alexjegers/DAMPING_ADJUSTER/Controller/Testing and Other/ST7789  Address Set Bug/IMG_5339.JPG

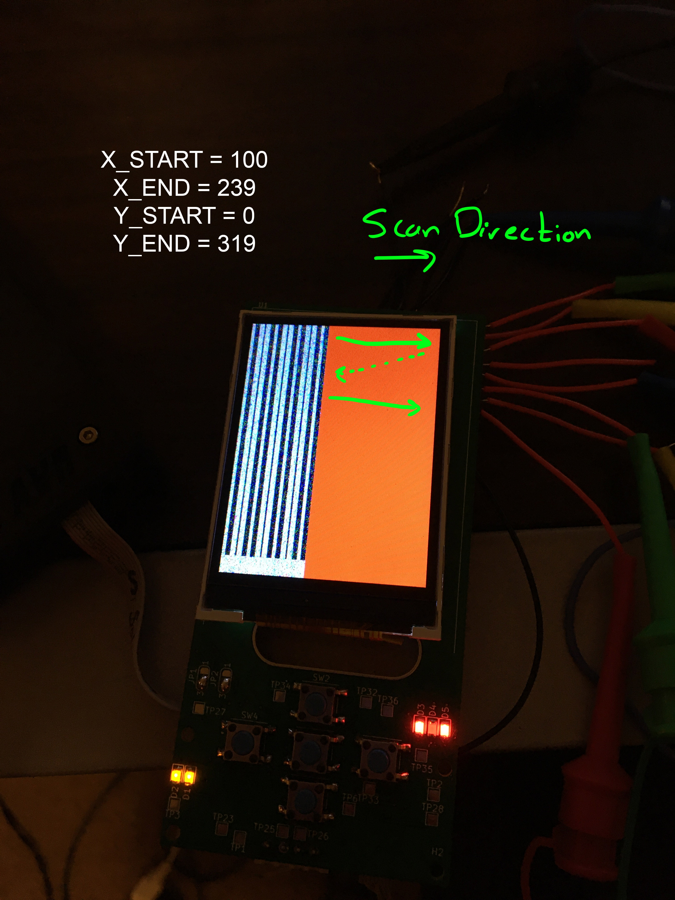
Controller/Testing and Other/ST7789 Address Set Bug/IMG_5339.JPG
