alexjegers/DAMPING_ADJUSTER/Stepper Motor Controller/CAD/3D Models/PerformanceLog.txt

Number of Contacts: 0
Number of contact data: 0
