alexjegers/DAMPING_ADJUSTER/Other Docs/Coilover Adjuster IIC Procedure.docx

Coilover Adjuster IIC Procedure

Version 1

1. Initiate communication by sending the device address and a write bit.
  a. Write 1 byte of data, this sets the internal address. After 1 byte of data the slave will NACK and transmission will stop.
    i. This slave now hold that internal address.
2. To read or write from this address, start another transmission beginning with the device address and the preferred direction (read or write) immediately followed by sending data (write) or preparing to receive (read) the next byte(s).
  a. Refer to the table below for size of each internal address and read/write capability.

Address | Name | Direction | Size (bytes) | Description
0x01 | MOTOR_SETPOINT | R/W | 2 | First byte: LSB of setpoint. Second byte: MSB of setpoint. Setpoint is the actual damping setting multiplied by 10. Should be a multiple of 10 between 0 – 300.
0x02 | MOTOR_POSITION | R/W | 2 | Only write on startup. First byte: LSB of position. Second byte: MSB of position. Position is the true position of the coilover times 10.
0x03 | MOTOR_SPEED | R/W | 2 | First byte: LSB of rotational speed in RPM. Second byte: MSB of rotational speed in RPM.
0x04 | MOTOR_CURRENT | R/W | 2 | First byte: LSB of member from CURRENT_LIMIT_t. Second byte: MSB of member from CURRENT_LIMIT_t.
0x05 | MOTOR_STEP_MODE | R/W | 1 | Member of STEP_MODE_t.
0x06 | MOTOR_STATUS_FLAGS | R | 1 | Returns 1 byte. STEPPER_INFO.flags
0x07 | BATTERY_VOLTAGE | R | 2 | Returns the ADC result
0x08 | GO_TO_ZERO | W | 1 | Any value written starts the go to zero process.

Version 2

Offset | Name | Direction | Size (bytes) | Description
0x00 | POSITION | | 2 | First byte: MSB of position. Second byte: LSB of set point.
0x02 | SET_POINT | | 2 | First byte: MSB of position. Second byte: LSB of set point.
0x04 | STEP_MODE | | 1 | Member of STEP_MODE_t.
0x05 | CURRENT_LIMIT | | 2 | First byte: MSB of member from CURRENT_LIMIT_t. Second byte: LSB of member from CURRENT_LIMIT_t.
0x07 | DECAY_MODE | | 1
0x08 | MOTOR_SPEED | | 2
0x10 | STATUS_FLAGS | | 1
