alexjegers/DAMPING_ADJUSTER/Other Docs/Coilover Damping Adjusters.pptx

## Coilover Damping Adjusters

Started: 8/10/2022

## High Level Block Diagram (old) – 8/10/2022

Main Control Board

Stepper Motor Board

IIC Slave

Stepper Motor and Driver

Encoder for Motor Position Feedback

Stepper Motor Board

IIC Slave

Stepper Motor and Driver

Encoder for Motor Position Feedback

OLED Display

IIC Master for communicating with motors

Encoder for user input

Stepper Motor Board

IIC Slave

Stepper Motor and Driver

Encoder for Motor Position Feedback

Stepper Motor Board

IIC Slave

Stepper Motor and Driver

Encoder for Motor Position Feedback

*Notes
IIC daisy chained to minimize the amount of wire.

## Motor Control Board Block Diagram – 8/13/22

IIC Master

ATtiny3217
or
AVR32DA32

DRV8825

NEMA-17 Short Stepper Motor

Bours open-center encoder

Coilover Damping Adjustment Screw

## PCB Board Cutout Coordinates – 8/19/22

Coordinates of each corner relative to origin (100, 100)

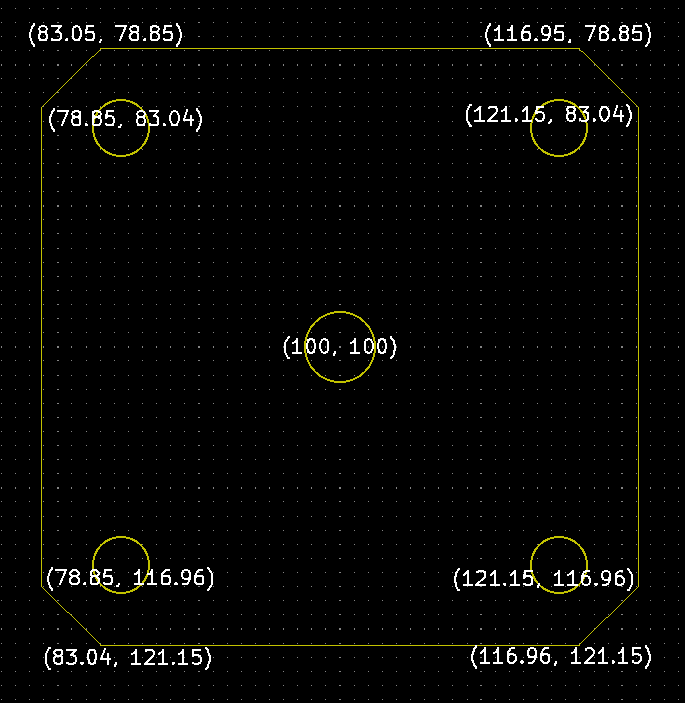
[picture p3: figure]

(100,100)

## Controller Board Block Diagram

Serial EEPROM

240x320
LCD
ST7789
or variant

8-bit parallel interface

ATUC128D3
or
SAM4LC2BA

Stepper Motor Boards

FL

FR

RL

RR

Switches

## High Level Block Diagram Updated – 9/22/22

Stepper Motor Board Front Right

IIC Slave

Stepper Motor and Driver

Encoder for Motor Position Feedback

Main Controller
Operated by driver

Stepper Motor Board Rear Right

IIC Slave

Stepper Motor and Driver

Encoder for Motor Position Feedback

LCD Display

IIC Master for communicating with motors

Switches for user input

Stepper Motor Board Front Left

IIC Slave

Stepper Motor and Driver

Encoder for Motor Position Feedback

12V

Stepper Motor Board Rear Left

IIC Slave

Stepper Motor and Driver

Encoder for Motor Position Feedback

Power Board
Located by fuse box.
4x Connectors for power and communication.

GND

## Top of Strut Dimensions and Actuator Depth – 10/9/22

Optimal length for hex key: 20.5mm from start of mounting (female) threads.

## Encoder Filtering – 8/14/22

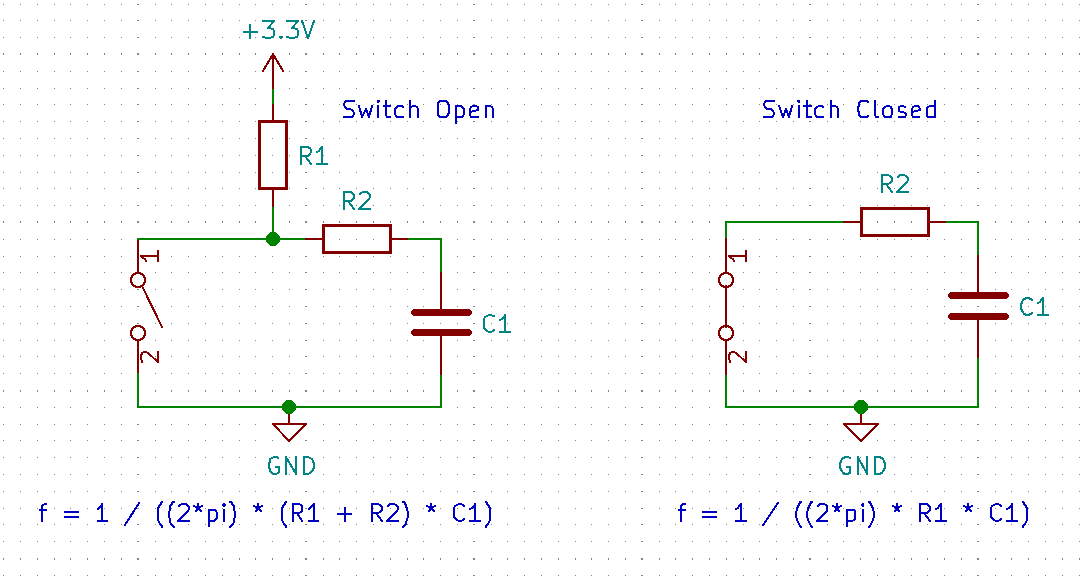
[picture p4: figure]

- Encoder max current rating: 10mA @ 5v
  - Pull-up resistor for 10mA @ 3.3V: >=330 ohm
- Max stepper RPM: ~100 rpm
  - Encoder pulses per rotation (PPR): 10
  - Pulses per second: 16.67
  - Min cutoff frequency: 16.67 Hz
- R1 = 330
- R2 = 7.5k
- C1 = 1u
  - Fc_open = 20.32 Hz
  - Fc_closed = 21.22 Hz
- If R2 = 5.1k
  - Fc_open = 29.31 Hz
  - Fc_closed = 31.21 Hz

## Encoder Filtering Cont – 8/15/22

- Schmitt trigger max upper threshold @ 3V: 2.0V
- Schmitt trigger min lower threshold @ 3V: 0.8V

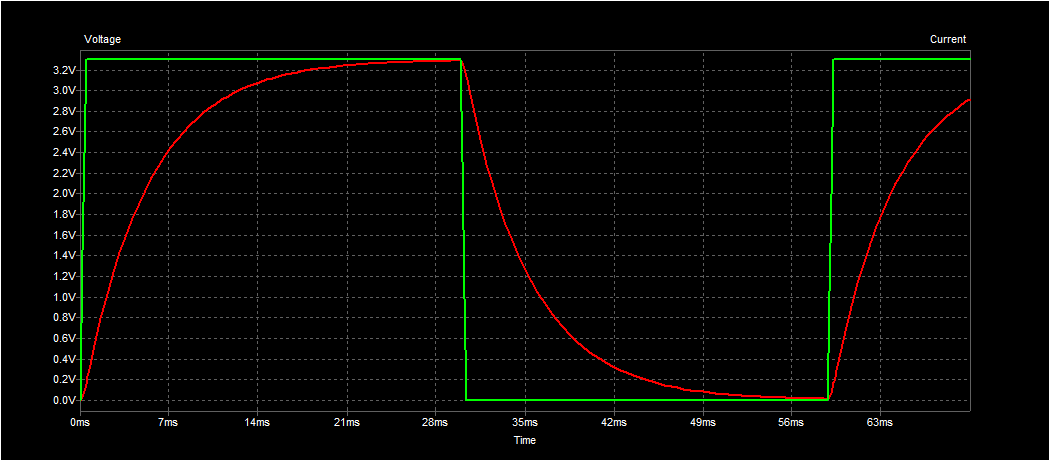
[picture p5: figure]

RC filter output with R2 = 5.1k

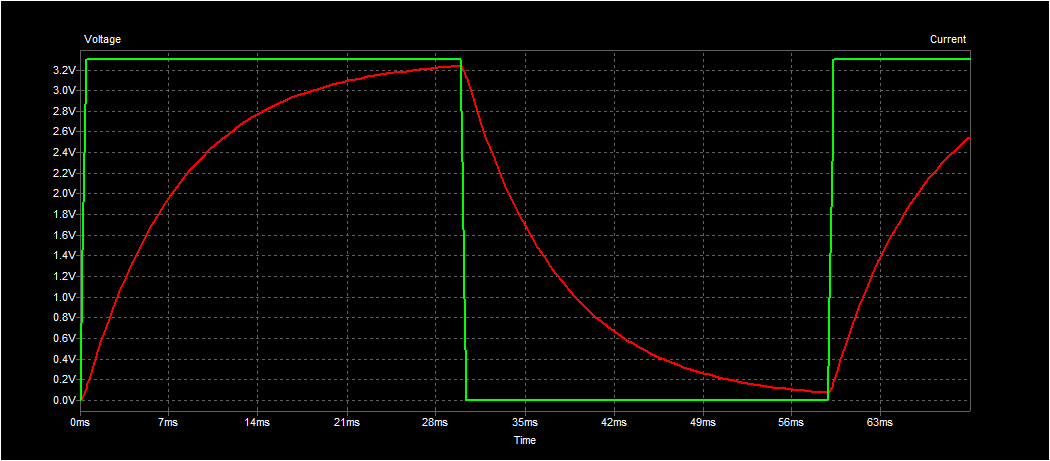
[picture p6: figure]

RC Filter output with R2 = 7.5k

## Stepper Current Sense Loop – 8/19/22

- ATtiny32xx DAC output range: 0.2 to VDD-0.2
- AVR32 DAC output range: GND to VDD
- DVR8825 Vref absolute range: 0V – 3.5V
  - Recommended range: 1V – 3.5V
- Rsense: 0.1 ohm
- Vref for 1A Ichop: 0.5V
- Rsense power dissipation: 0.1W
- Rsense: 0.25 ohm
- Vref for 1A Ichop: 1.26V
- Rsense power dissipation: 0.251W

## Stepper Motor Current Loop – 8/21/22

Goal is to keep current loop as short and constrained as possible.
Peak current of 1A per coil

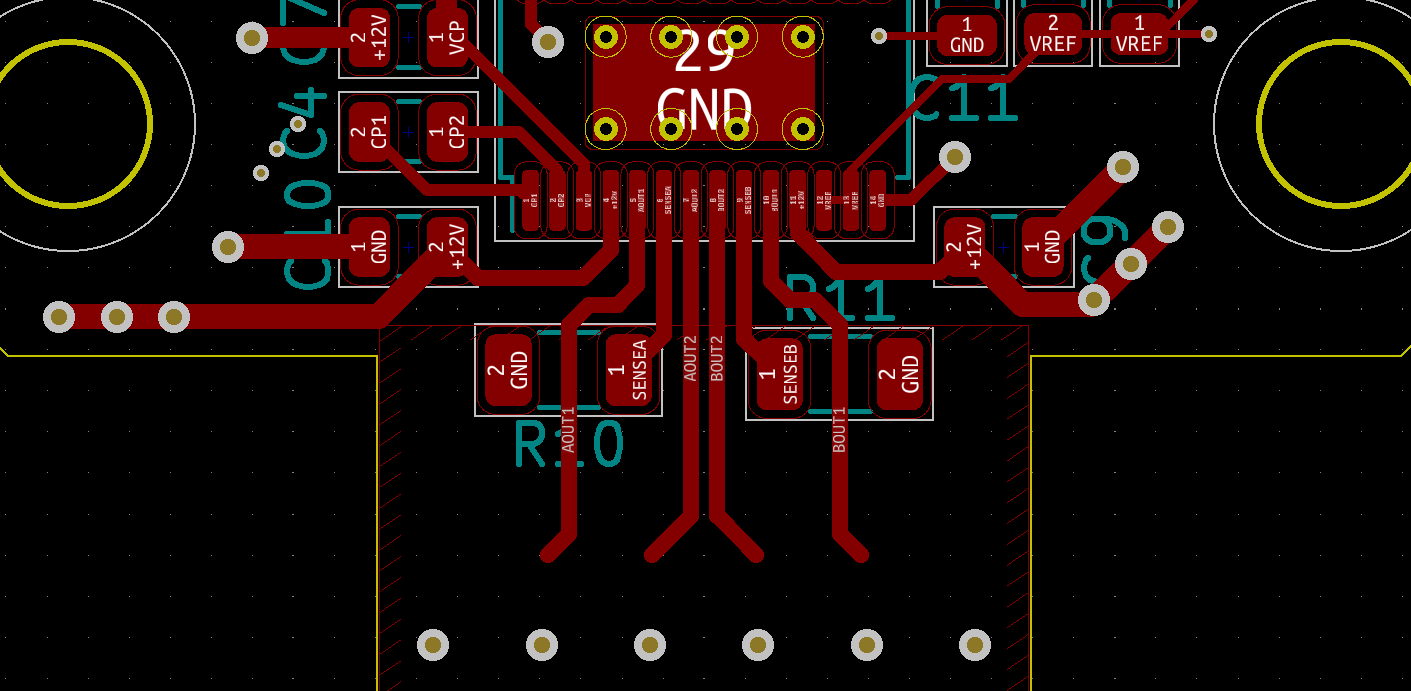
[picture p7: figure]

## On-Board Voltage Measurements – 8/21/22

- Vref = 2.5V
- Battery Voltage
- Max battery voltage: 15V
- Min battery voltage: 11V
- R1 = 1200, R2 = 200 -> divide by 7
  - Max power = 160.7mW
- Max divider output = 2.143V = 3511 (12 bit output)
- Min divider output = 1.571V = 2574 (12 bit output)
- Battery Voltage = ADC result / 1638.4

Vref = 2.5V
Regulated Voltage
Max, hopefully, 3.3V
Min, because of Vref, 2.5V
R1 = 680, R2 = 680 -> divide by 2
Max power = 165.4mW
Max divider output = 1.65V = 2703 bits
Min divider output = 1.25V = 2048 bits
Regulated Voltage = ADC result / 1638.4

## On-Board Voltage Measurements – 9/1/22

Calculating minimum impedance divider while not exceeding resistor power rating (0.25W)

## Slide 14

## Mounting – 8/26/22

- Coilover top hat thread size M12x1.25

## Controller MCU Selection – 8/29/22

Device/Description | # of pins
LCD data pins | 8
LCD backlight | 1
LCD Data/Cmd, CS, RD, WR | 4
LCD reset | 1
At least 1 IIC | 2
Buttons | >=5
Total | >=21 + prog pins

- Minimum memory:
  - Absolutely no less than 128kB, ideally more than or equal to 256kB.
- Peripherals:
  - At least 1 IIC.
  - CANBUS for future use.
  - EMI/SBC?

ATSAM4LC2BA

## ATSAM4LC2BA Clocking – 9/1/22

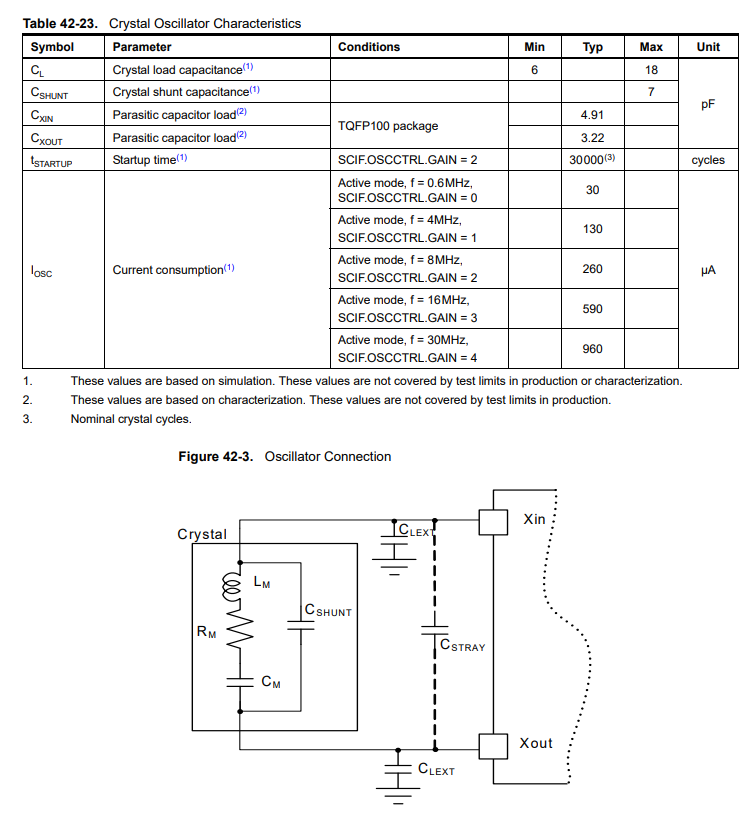
[picture p8: figure]

Crystal: AS-30.000-10-F-2020-EXT-SMD-TR
External capacitor value =
Cx = 2(CL – Cstray) = 2(10pF – 3pF) = 14pF

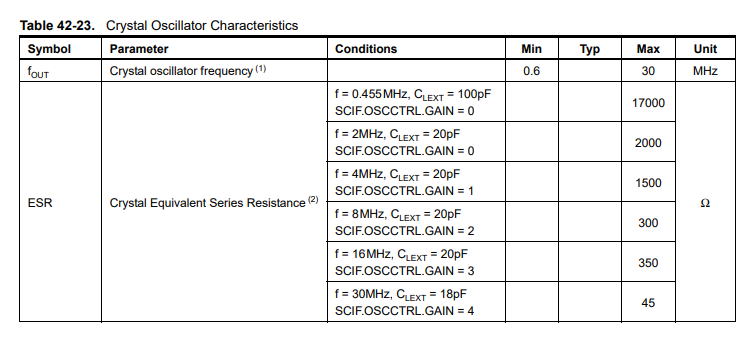
[picture p9: figure]

## Controller Board Buttons Filter – 9/2/22

- Max current through button: 10mA
  - Pull resistor (R21): 3.3V / 10mA = 330 ohm
- Cutoff frequency minimum: 15Hz
  - fc,min = 1 / ((2*pi)*(R21+R22)*C16)
- C16: 1uF
- R21: 330
- R22: 10k
- Switch pressed cutoff frequency = 15.92Hz
- Switch released cutoff frequency = 15.41Hz

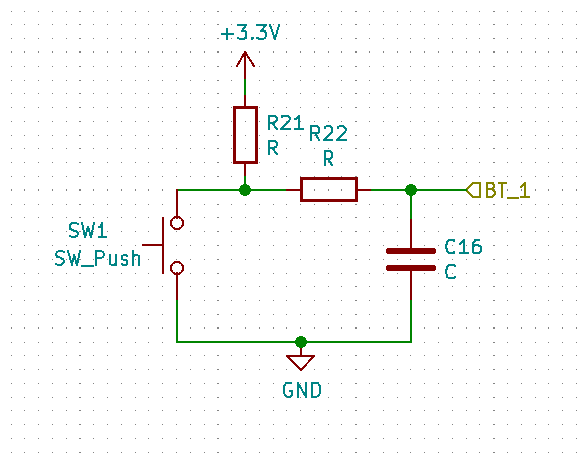
[picture p10: figure]

## ATUC128D3 Clocking – 9/3/22

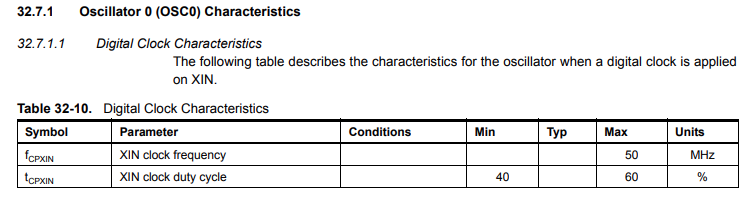
[picture p11: figure]

## DRV8825 Step PWM Frequency Calculation – 9/15/22

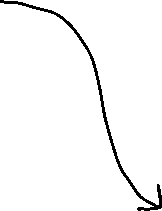
[picture p12: figure]

## Stepper Motor Timeout Frequency Calculations – 10/7/2022

## UPDI Pinout – 8/13/22

Atmel ICE Pinout

My Pinout

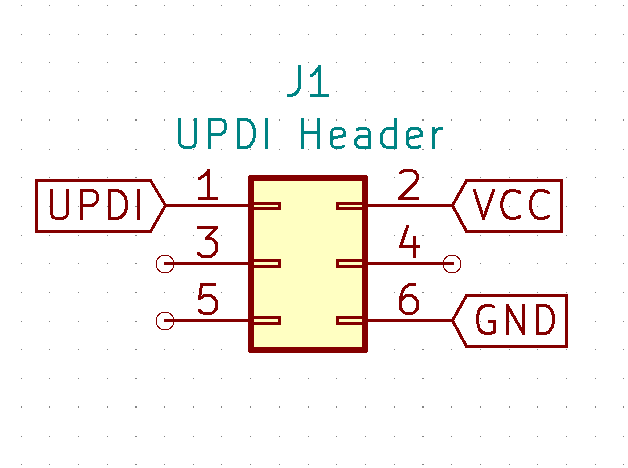
[picture p13: figure]
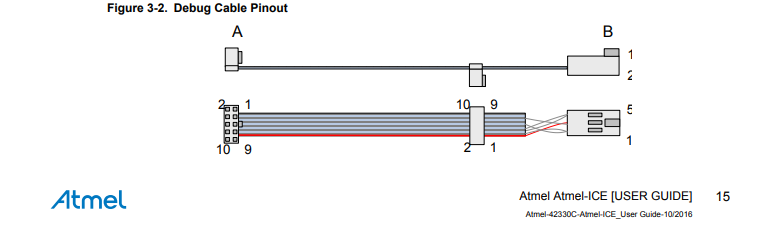
[picture p14: figure]
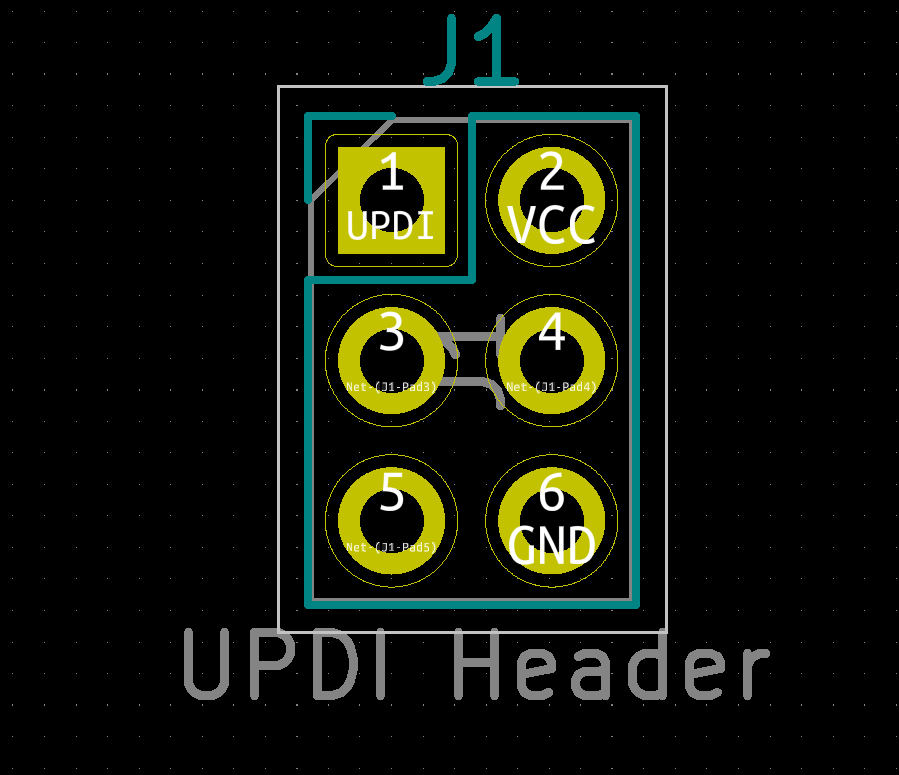
[picture p15: figure]
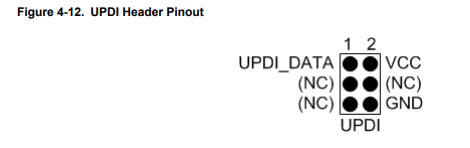
[picture p16: figure]

## UPDI Pinout - 8/20/22

Updated schematic for AVR32DA32

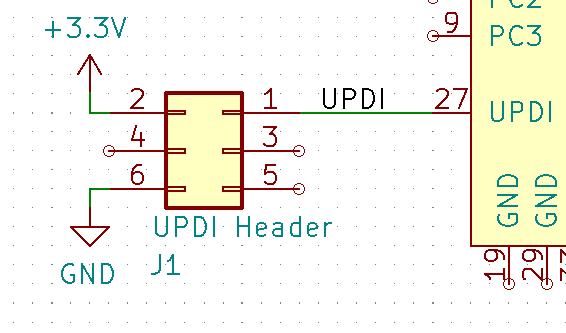
[picture p17: figure]

## UA78M33CKVURG3 Footprint – 8/15/22

Had to modify existing KiCAD TO-252 footprint. Extended pin 1 & 3 pads to 2.75mm from 2.2mm.

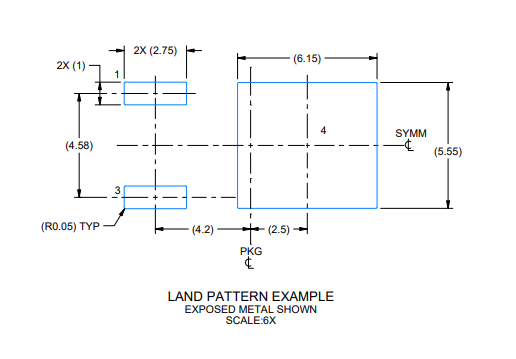
[picture p18: figure]
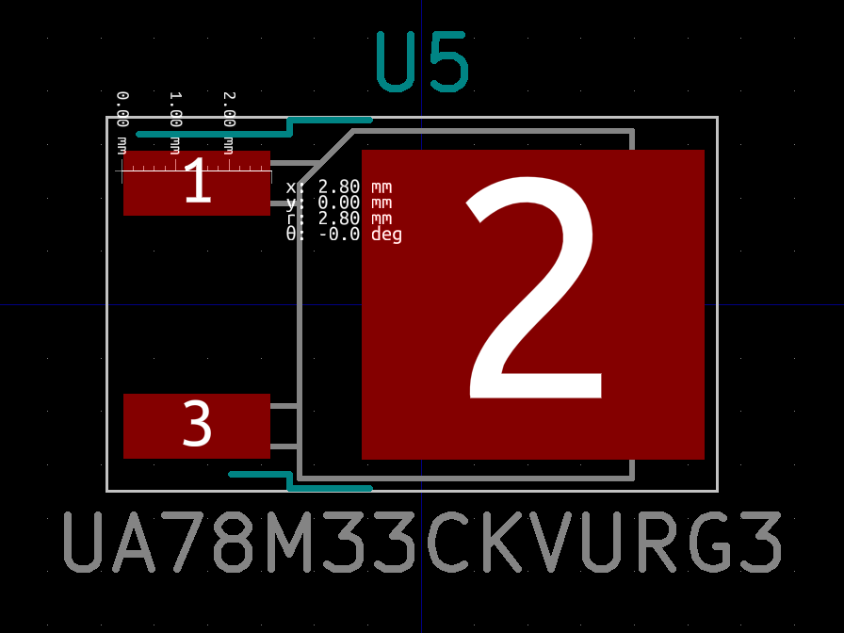
[picture p19: figure]

## ATSAM4LC2BA JTAG Pinout – 8/30/22

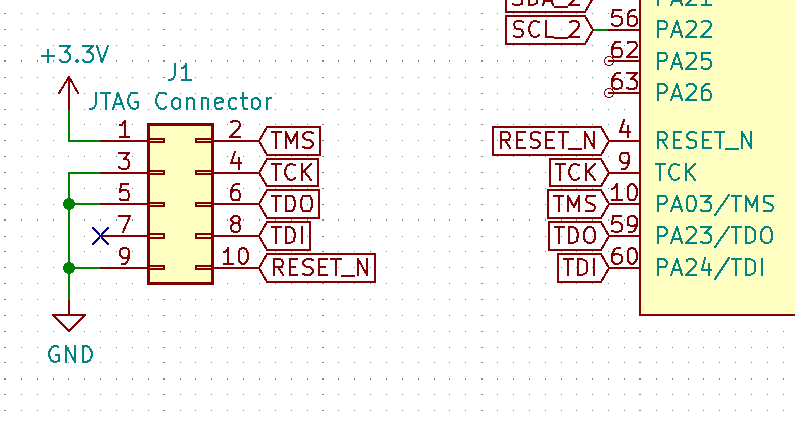
[picture p20: figure]
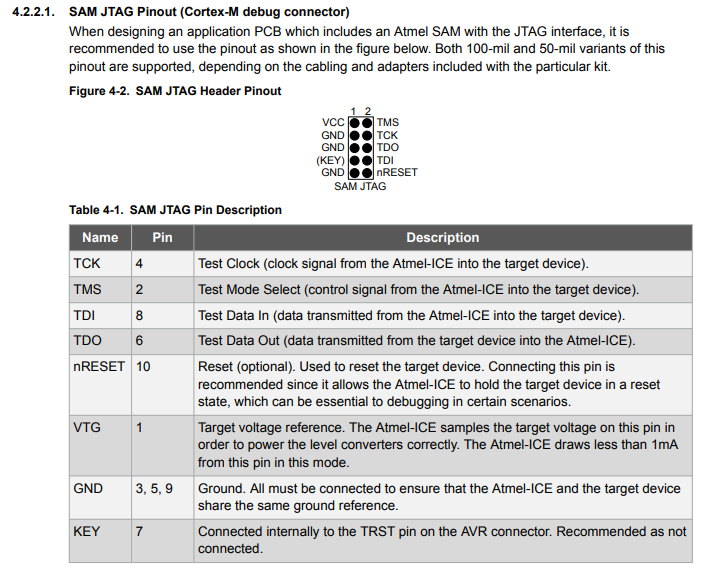
[picture p21: figure]
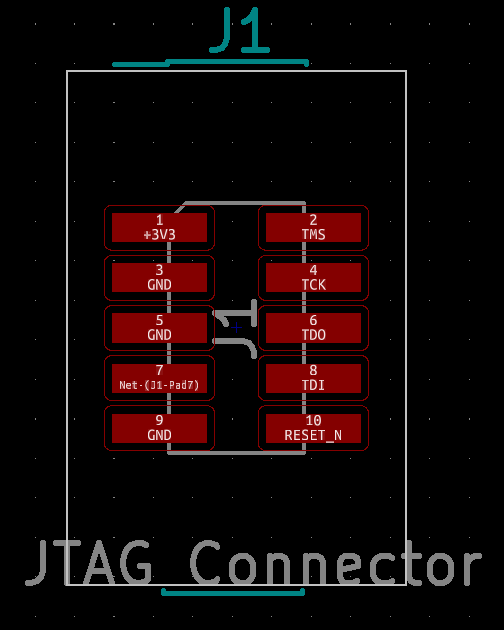
[picture p22: figure]

## ATSAM4LC2BA I2C Pins – 8/31/22

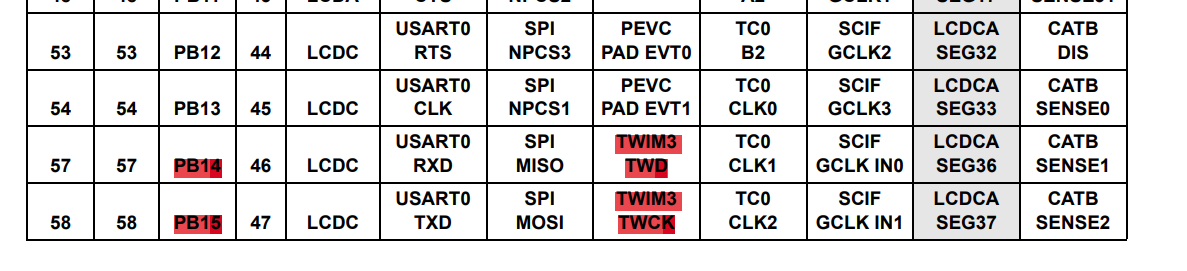
[picture p23: figure]
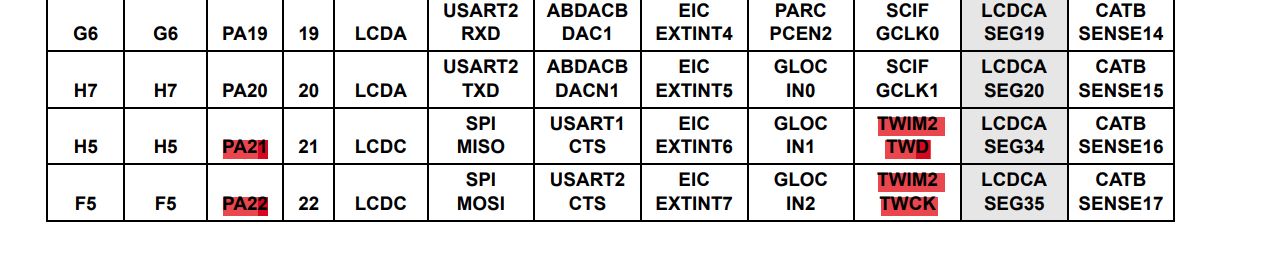
[picture p24: figure]
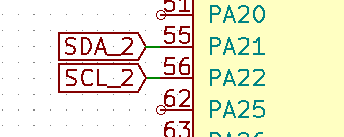
[picture p25: figure]

## BSR802N Backlight FET Pinout – 9/1/22

Datasheet

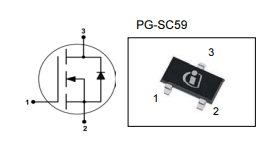
[picture p26: figure]
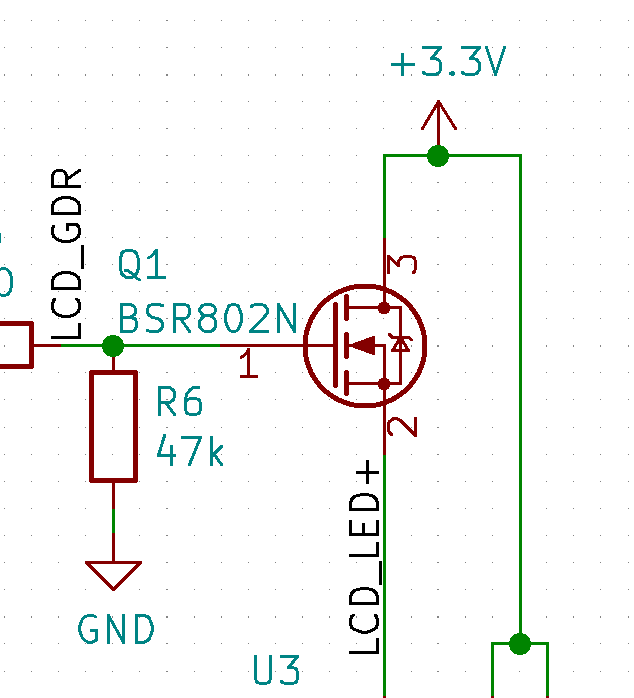
[picture p27: figure]
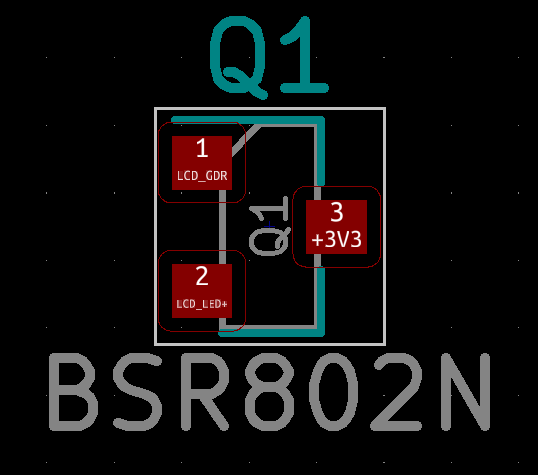
[picture p28: figure]

## ATUC128C3 JTAG Pinout – 9/3/22

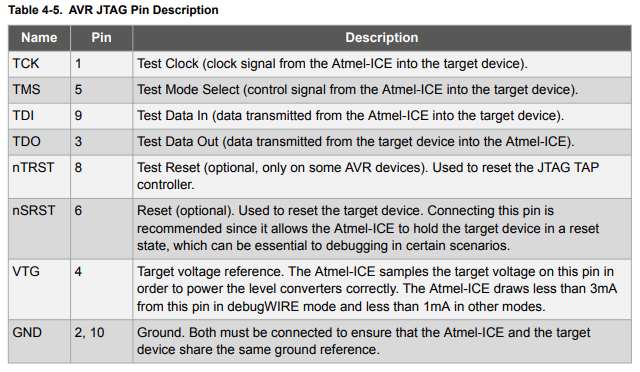
[picture p29: figure]
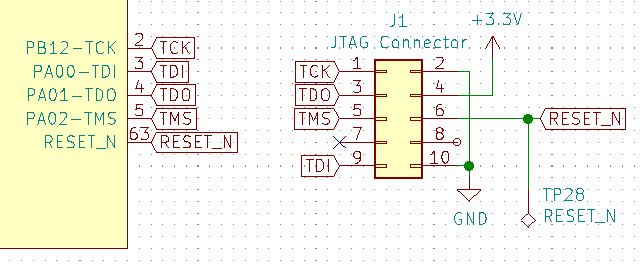
[picture p30: figure]
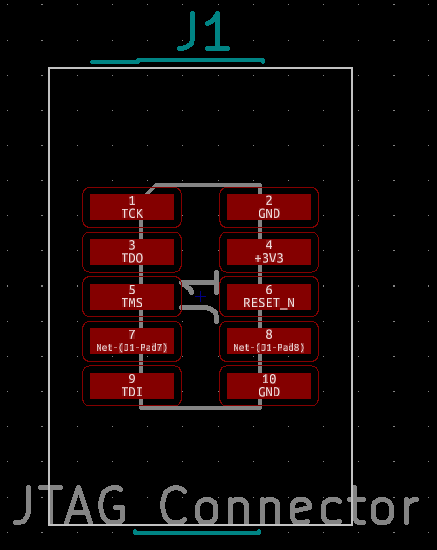
[picture p31: figure]
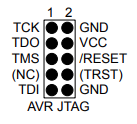
[picture p32: figure]

## SN74LVC2G17 Decoupling – 8/15/22

## UA78M33CKVURG3 Decoupling – 8/17/22

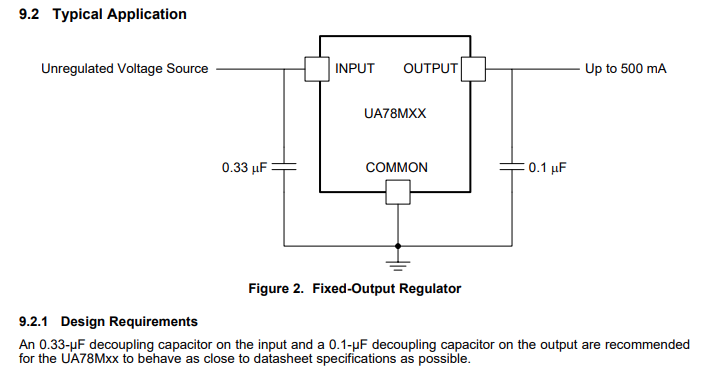
[picture p33: figure]

## AVR32DA32 Decoupling

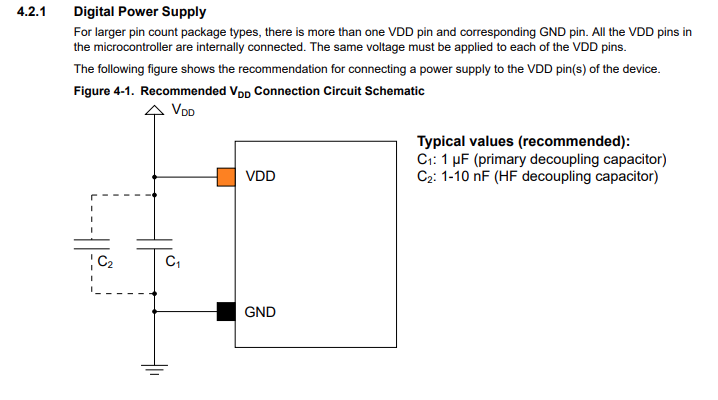
[picture p34: figure]
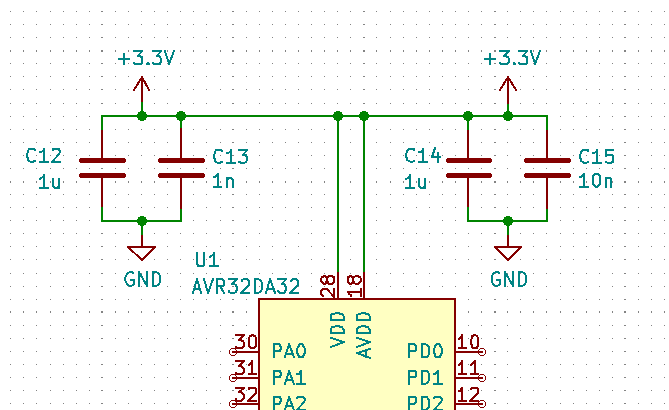
[picture p35: figure]

## ATSAM4LC2BA Power Supply – 8/30/22

- VDDANA, GNDANA
  - Analog Voltage Supply,
  - 3.3V
- VDDCORE
  - Core voltage supply
  - 1.8V, connect to VDDOUT
- VDDIN
  - Voltage regulator in
  - 3.3V
- VDDIO
  - IO Voltage,
  - 3.3V,
- VDDOUT
  - Voltage regulator output
  - 1.8V out
