alexjegers/DAMPING_ADJUSTER/Other Docs/Pinout Check Template.xlsx

Pin Number | My Symbol | Pin Number2 | Data Sheet | Check
1 |  | 1 |  | TRUE
2 |  | 2 |  | TRUE
3 |  | 3 |  | TRUE
4 |  | 4 |  | TRUE
5 |  | 5 |  | TRUE
6 |  | 6 |  | TRUE
7 |  | 7 |  | TRUE
8 |  | 8 |  | TRUE
9 |  | 9 |  | TRUE
10 |  | 10 |  | TRUE
11 |  | 11 |  | TRUE
12 |  | 12 |  | TRUE
13 |  | 13 |  | TRUE
14 |  | 14 |  | TRUE
15 |  | 15 |  | TRUE
16 |  | 16 |  | TRUE
17 |  | 17 |  | TRUE
18 |  | 18 |  | TRUE
19 |  | 19 |  | TRUE
20 |  | 20 |  | TRUE
21 |  | 21 |  | TRUE
22 |  | 22 |  | TRUE
23 |  | 23 |  | TRUE
24 |  | 24 |  | TRUE
25 |  | 25 |  | TRUE
26 |  | 26 |  | TRUE
27 |  | 27 |  | TRUE
28 |  | 28 |  | TRUE
29 |  | 29 |  | TRUE
30 |  | 30 |  | TRUE
31 |  | 31 |  | TRUE
32 |  | 32 |  | TRUE
33 |  | 33 |  | TRUE
