alexjegers/DAMPING_ADJUSTER/Controller/CAD/JPG/A1005-001-Front.JPG

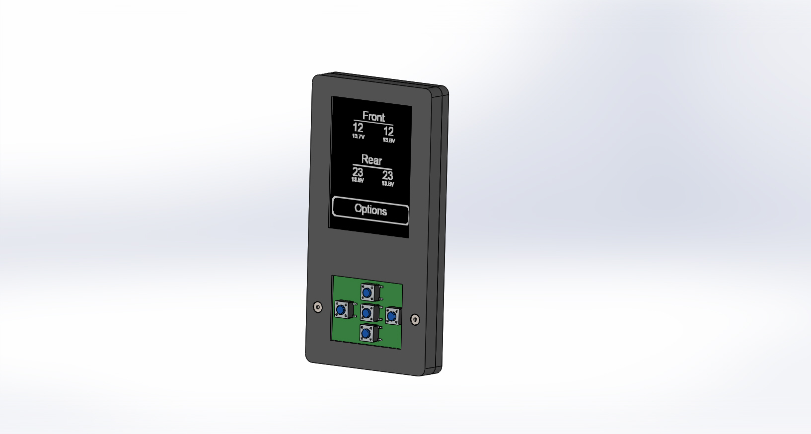
Controller/CAD/JPG/A1005-001-Front.JPG
