alexjegers/DAMPING_ADJUSTER/Controller/CAD/JPG/A1005-001-Rear.JPG

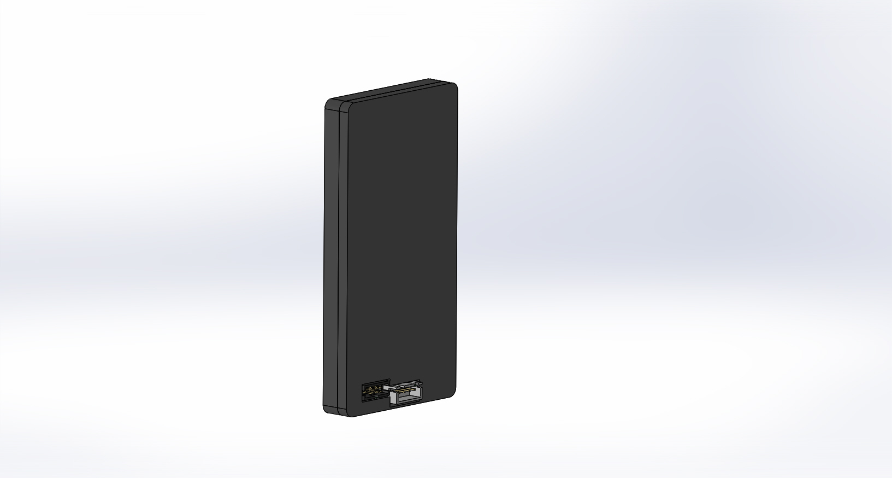
Controller/CAD/JPG/A1005-001-Rear.JPG
