alexjegers/DAMPING_ADJUSTER/Other Docs/Diagram Overview.jpg

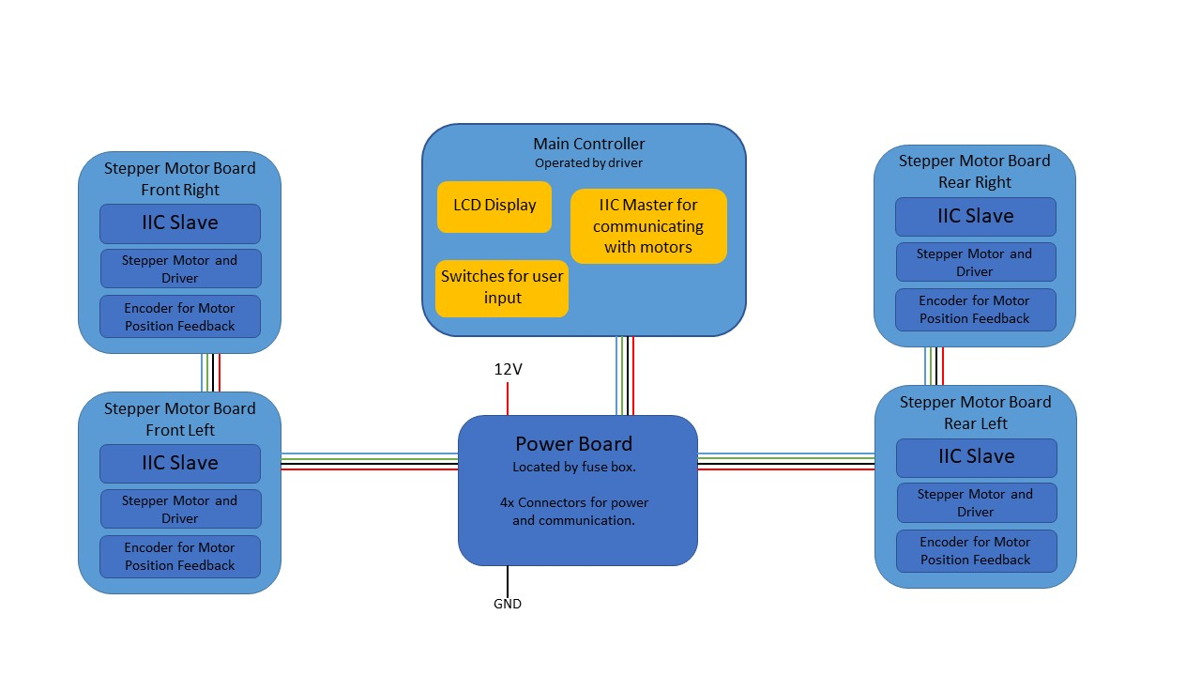
Other Docs/Diagram Overview.jpg
