alexjegers/DAMPING_ADJUSTER/Stepper Motor Controller/Testing and Other/ADC Input Impedance/Schematic.PNG

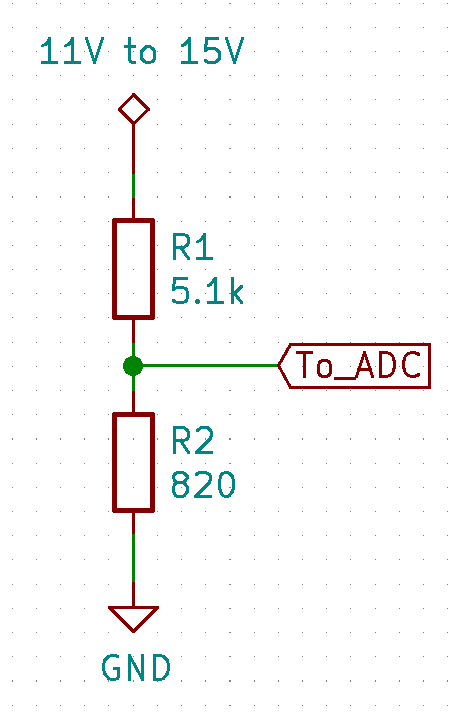
Stepper Motor Controller/Testing and Other/ADC Input Impedance/Schematic.PNG
