alexjegers/DAMPING_ADJUSTER/Stepper Motor Controller/Testing and Other/ADC Measurements/Schematic.PNG

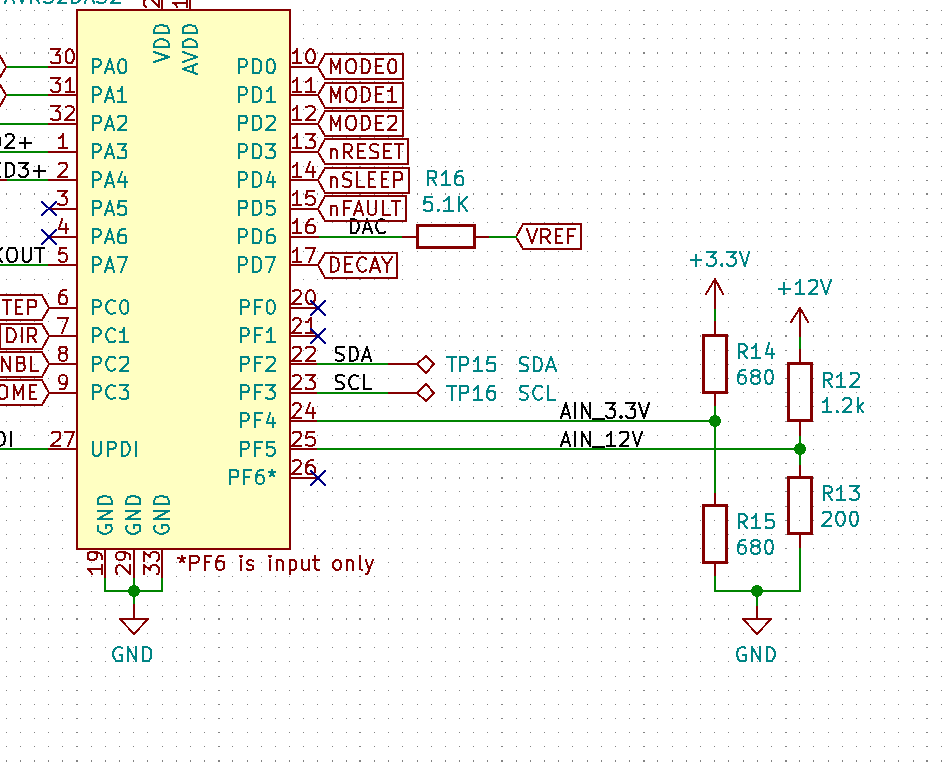
Stepper Motor Controller/Testing and Other/ADC Measurements/Schematic.PNG
