alexjegers/DAMPING_ADJUSTER/Other Docs/Full Parts List.xlsx

Sheet: Parts
Part Num | Mfg Part Num | Type | Distributor | Description | Unit Cost
1001 | PER231-P19-N0010 | Other | Arrow | Open center encoder | 2.24
1002 | 17HS08-1004S | Other | StepperOnline | Nema 17 Stepper Motor | 8.56
1003 | SN74LVC2G17DBVR | IC | JLC Parts | Schmitt Trigger, Dual | 0.15
1004 | UA78M33CKVURG3 | IC | Digi-Key | 3.3V Regulator | 0.81
1005 | JST-XH | Connector | Amazon | 2.54mm pitch connector
1005-001 | JST-XH | Connector |  | 2 pin
1005-002 | JST-XH | Connector |  | 3 pin
1005-003 | JST-XH | Connector |  | 4 pin
1006 | MAL202136101E3 | Passive | Digi-Key | 100uF axial capacitor | 1.98
1007 | DRV8825 | IC | JLC Parts | Stepper motor driver | 3.87
1008-001 | KDV12DR100ET | Passive | Digi-Key | Current Sense Resistors .1 ohm | 0.36 | *Note: Alternative for .25 ohm, order both.
1008-002 | CSR1206FKR250 | Passive | Digi-Key | Current Sense Resistors .25 ohm | 0.41
1009 | AVR32DA32T-E/RXB | IC | Digi-Key | 8 bit AVR MCU 32kb flash | 2.14
1010 |  | 3D Printed |  | Stepper motor to hex adapter
1011 |  | 3D Printed |  | PCB Stepper motor spacer
1012 | 18072 | Hardware | Bolts Depot | Mounting Nut | 0.24
1013 |  | 3D Printed |  | Mounting nut holder front
1014 | 22474 | Hardware | Bolts Depot | Extended Mount to Stepper Screws 25mm | 0.21
1015 | AT24C04D | IC | Digi-Key | IIC EEPROM | 0.26
1016 | BSR802NL6327HTSA1 | IC | Digi-Key | LCD Backlight FET switch | 0.72
1017 | ATSAM4LC2BA-MUR | IC | Digi-Key | 32 bit MCU 128kB flash | 2.47
1018 |  | 3D Printed |  | Mounting Nut Holder rear
1019 |  | Hardware |  | 3mm Hex Key
1020 | AS-30.000-10-F-2020-EXT-SMD-TR | Passive | Digi-Key | 30MHz crystal | 0.21
1021-001 |  | Passive |  | 14pF crystal load cap
1021-002 |  | Passive |  | 12pF crystal load cap
1021-003 |  | Passive |  | 16pF crystal load cap
1021-004 |  | Passive |  | 10pF crystal load cap
1022 | ECS-2520MV-480-CN-TR | Passive | Digi-Key | 48 MHz Oscillator | 1.29
1023 | ATUC128D3-A2UT | IC | Digi-Key | 32 bit MCU 128kB flash | 2.65
1024 | 104990542 | IC | Digi-Key | 2.4" LCD Screen | 6.9
1025 | CF20241D0R0-NH | Connector | Digi-Key | FFC Connector for LCD | 0.47
1026 |  | Hardware |  | M2 threaded insert
1027 | PTS645SM43SMTR92 LFS | Other | Digi-Key | Switch for controller board | 0.28
1028 |  | 3D Printed |  | Controller case bottom half
1029 |  | 3D Printed |  | Controller case top half
1030 | 3221-10-0300-00 | Connector | Digi-Key | JTAG Socket | 0.76
1031 |  | 3D Printed |  | Power and Signal Board Case Bottom
1032 |  | 3D Printed |  | Power and signal board case top
]

Sheet: Assemblies
Part Number | Description
A1001 | Full stepper motor assembly
A1002 | Stepper motor board PCA
A1003 | LCD and FPC Connector
A1004 | Controller Board PCA
A1005 | Full Controller Assembly
A1006 | Power/signal distribution PCA
A1007 | Full power/signal distribution assembly
A1013 | Stepper motor mount front, 1013 & 1012
A1018 | Stepper motor mount rear, 1018 & 1012
