alexjegers/DAMPING_ADJUSTER/Other Docs/BOM & Dev Costs.xlsx

Sheet: A1001 - Full Stepper Assembly
Part Num | Mfg Part Num | Distributor | Description | Quantity | Unit Cost | Total Cost | Cost for 1
1010 | 3D Printed |  | Stepper motor to hex adapter | 1 |  | 0 | 20.4
1011 | 3D Printed |  | PCB Stepper motor spacer | 1 |  | 0
A1002 | A1002 |  | Stepper motor PCA | 1 | 19.32 | 19.32
A1013 | A1013 |  | Stepper Motor Mount | 1 | 1.08 | 1.08

Sheet: A1002 - Stepper Motor PCA
Part Num/Designator | Mfg Part Num | Distributor | Type | Value | Footprint | Quantity | Unit Cost | Total Cost | Total
C1, C2, C12, C14 | 1276-1066-1-ND | DigiKey | Capacitor | 1u | 0805 | 4 | 0.1 | 0.4 | 19.32
C3, C6, C7, C9, C10 | 1276-1099-1-ND | DigiKey | Capacitor | .1u | 0805 | 5 | 0.1 | 0.5
C4, C15 | 1276-1015-1-ND | DigiKey | Capacitor | .01u | 0805 | 1 | 0.1 | 0.1
C5 | 1276-1123-1-ND | DigiKey | Capacitor | .33u | 0805 | 1 | 0.1 | 0.1
C8 | 4032PHCT-ND | DigiKey | Capacitor | 100u | 0805 | 1 | 1.98 | 1.98
C11 | 1276-1039-1-ND | DigiKey | Capacitor | .47u | 0805 | 1 | 0.1 | 0.1
C13 | 1276-1020-1-ND | DigiKey | Capacitor | 1n | 0805 | 1 | 0.1 | 0.1
D1-D5 | 732-4988-1-ND | DigiKey | LED | LED | 1206 | 5 | 0.23 | 1.15
J1 | 2057-PH2RA-06-UA-ND | DigiKey | Connector | 2x3 2.54mm 90 degree THT header |  | 1 | 0.19 | 0.19
J2 |  |  | Connector | JST-XH 4 pin THT |  | 1 |  | 0
J3, J4 |  |  | Connector | JST-XH 4 pin THT |  | 2 |  | 0
R1, R2 | A106061CT-ND | DigiKey | Resistor | 330 | 0805 | 2 | 0.1 | 0.2
R3, R4, R16 | 13-RT0805FRE075K1LCT-ND | DigiKey | Resistor | 5.1k | 0805 | 3 | 0.1 | 0.3
R5 | A106058CT-ND | DigiKey | Resistor | 1M | 0805 | 1 | 0.1 | 0.1
R6, R7 | RMCF0805FT10K0CT-ND | DigiKey | Resistor | 10k | 0805 | 2 | 0.1 | 0.2
R10, R11/1008-001 | 273-KDV12DR100ETCT-ND | DigiKey | Resistor | 0.1 | 1206 | 2 | 0.36 | 0.72
R12, R20 | A129750CT-ND | DigiKey | Resistor | 1.2k | 0805 | 2 | 0.1 | 0.2
R13 | RHM200KCT-ND | DigiKey | Resistor | 200 | 0805 | 1 | 0.14 | 0.14
R14, R15 | A129747CT-ND | DigiKey | Resistor | 680 | 0805 | 2 | 0.1 | 0.2
R17-R19, R21 | A129745CT-ND | DigiKey | Resistor | 470 | 0805 | 4 | 0.1 | 0.4
U1/1009 | 150-AVR32DA32T-E/RXBCT-ND | DigiKey | IC | AVR32DA32 | QFN-32 | 1 | 2.14 | 2.14
U2/1007 | C81582 | LCSC/JLC | IC | DRV8825 | HTSSOP-28 | 1 | 4.02 | 4.02
U3/1001 | 118-PER231-P19-N0010-ND | DigiKey | IC | PER231-P19-N0010 |  | 1 | 3.42 | 3.42
U4/1003 | 296-SN74LVC2G17DBVRCT-ND | DigiKey | IC | SN74LVC2G17DBVR | SOT23-6 | 1 | 0.44 | 0.44
U5/1004 | 296-21208-1-ND | DigiKey | IC | UA78M33CKVURG3 | TO-252-2 | 1 | 0.62 | 0.62
A1002 |  | JLC PCB | PCB | PCB |  | 1 | 1.6 | 1.6

Sheet: A1003 - Controller Board PCA
Part Num/Designator | Mfg Part Num | Distributor | Type | Value | Footprint | Quantity | Unit Cost | Total Cost | Total
C1, C3-C5, C7, C9, C10, C12, C13, C15 | 1276-1099-1-ND | DigiKey | Capacitor | .1u | 0805 | 10 | 0.1 | 1 | 19.19
C2, C6, C16-C20 | 1276-1066-1-ND | DigiKey | Capacitor | 1u | 0805 | 7 | 0.1 | 0.7
C8 | 1276-1123-1-ND | DigiKey | Capacitor | .33u | 0805 | 1 | 0.1 | 0.1
C11 | 1276-6454-1-ND | DigiKey | Capacitor | 10u | 0805 | 1 | 0.18 | 0.18
C14 | 399-17612-1-ND | DigiKey | Capacitor | 10p | 0805 | 1 | 0.26 | 0.26
D1-D5 | 732-4988-1-ND | DigiKey | LED | Any | 1206 | 5 | 0.23 | 1.15
J1 | 1175-1735-ND | DigiKey | Connector |  | 2x6 SMD | 1 | 0.76 | 0.76
J2 |  | DigiKey | Connector |  | 1x4 THT | 1 |  | 0
Q1/1016 | BSR802NL6327HTSA1CT-ND | DigiKey | IC | BSR802N | SOT-23 | 1 | 0.72 | 0.72
R1 | A130137CT-ND | DigiKey | Resistor | 3.3k | 0805 | 1 | 0.1 | 0.1
R2, R14 | A129750CT-ND | DigiKey | Resistor | 1.2k | 0805 | 2 | 0.1 | 0.2
R3, R4 | RNCP0805FTD1K00CT-ND | DigiKey | Resistor | 1k | 0805 | 2 | 0.1 | 0.2
R5, R15 | RHM200KCT-ND | DigiKey | Resistor | 200 | 0805 | 2 | 0.14 | 0.28
R6 | A106064CT-ND | DigiKey | Resistor | 47k | 0805 | 1 | 0.1 | 0.1
R13, R22, R24, R26, R28, R30 | RMCF0805FT10K0CT-ND | DigiKey | Resistor | 10k | 0805 | 6 | 0.1 | 0.6
R18-R20 | A129745CT-ND | DigiKey | Resistor | 470 | 0805 | 2 | 0.1 | 0.2
R21, R23, R25, R27, R29 | A106061CT-ND | DigiKey | Resistor | 330 | 0805 | 5 | 0.1 | 0.5
U1/1024 | 1597-104990542-ND | DigiKey | IC | RY24049B0-00 |  | 1 | 6.9 | 6.9
U2/1004 | 296-21208-1-ND | DigiKey | IC | UA78M33CKVURG3 | TO-252-2 | 1 | 0.62 | 0.62
U3/1023 | ATUC128D3-A2UT-ND | DigiKey | IC | ATUC128D3 | TQFP-64 | 1 | 2.65 | 2.65
U4/1015 | 1611-AT24C04D-XHM-B-ND | DigiKey | IC | AT24C04D | TSSOP-8 | 1 | 0.26 | 0.26
X1 | XC2757CT-ND | DigiKey | IC | ECS-2520MV-480 |  | 1 | 1.24 | 1.24
J3 | 2987-CF20241D0R0-NHCT-ND | DigiKey | Connector | CF20241D0R0-NH |  | 1 | 0.47 | 0.47
SW1-SW5 | CKN9112CT-ND | DigiKey | Switch | PTS645SM43SMTR92 LFS |  | 5 | 0.28 | 1.4

Sheet: A1013 - Stepper Motor Mount
Part Num | Mfg Part Num | Distributor | Description | Quantity | Unit Cost | Total Cost | Cost for 1
1012 | 18072 | Bolts Depot | Mounting Nut | 1 | 0.24 | 0.24 | 1.08
1013 | 3D Printed |  | Mounting nut holder front | 1 |  | 0
1014 | 22474 | Bolts Depot | Extended Mount to Stepper Screws 25mm | 4 | 0.21 | 0.84

Sheet: A1018 - Stepper Motor Mount Ext
Part Num | Mfg Part Num | Distributor | Description | Quantity | Unit Cost | Total Cost | Cost for 1

Sheet: Purchase History
Date | Part Num | Retailer | Order Number | Item | Quantity | Sub-Total | Tax | Shipping | Total
2022-08-13 | 1001 | Arrow.com |  | Open Center Encoder | 4 | 8.98 | 1.33 | 5.99 | 16.3 | Total Spent | 246.86
8/25/2022 | A1002 | Digikey.com | 77498754 | Electrical Parts | 5 | 30.81 | 3.51 | 4.99 | 39.31
2022-08-25 | A1002 | JLCPCB | Y9-3281895A | PCB, PCA, and parts | 5 | 35.38 | 0 | 19.44 | 54.82
2022-08-28 | A1002 | Bolts Depot | 1825377 | 1012, 1014, some socket cap | 4 | 10.88 | 0.89 | 4.95 | 16.72
2022-08-29 | A1003 | Digikey.com | 77627274 | Electrical Parts | 2 | 21.28 | 2.51 | 4.99 | 28.78
2022-09-12 | A1002 | Digikey.com | 77751071 | Electrical Parts | 5 | 10.7 | 1.39 | 4.99 | 17.08
2022-09-18 | A1003/A1002 | Digikey.com | 77843061 | Switches, header pins | 2 | 6.86 | 1.7 | 4.99 | 13.55
2022-09-25 | A1003 | JLCPCB | Y13-3281895A, Y11-3281895A | PCB | 5 | 9 | 0 | 20.01 | 29.01
2022-10-02 | A1003 | Digikey.com | 78062957 | Passives | 2 | 14.27 | 1.86 | 4.99 | 21.12
2022-10-02 | 1005 | PCHCables.com | PCH-106524 | Connectors M&F | 15 | 4.05 | 0 | 6.12 | 10.17
