alexjegers/DAMPING_ADJUSTER/Stepper Motor Controller/Electrical/Mfg Files/JLC PCA BOM.xlsx

Comment | Designator | Footprint | JLCPCB Part #（optional）
SN74LVC2G17DBVR | U4 | SOT-23-6L | C10429
DRV8825PWPR | U2 | HTSSOP-28_EP_4.4x9.7x0.65P | C81582
