alexjegers/DAMPING_ADJUSTER/Controller/Electrical/Controller_Board_AB/Mfg Files/BOM/Controller_Board_JLC_BOM.xlsx

Comment | Designator | Footprint | JLCPCB Part #（optional）
.1u | C1, C3-C5, C7, C9, C10, C12, C13, C15 | Capacitor_SMD:C_0805_2012Metric | C1711
1u | C2, C6, C16-C20 | Capacitor_SMD:C_0805_2012Metric
.33u | C8 | Capacitor_SMD:C_0805_2012Metric
10u | C11 | Capacitor_SMD:C_0805_2012Metric
10p | C14 | Capacitor_SMD:C_0805_2012Metric
LED | D1, D2 | LED_SMD:LED_0805_2012Metric
LED1 | D3 | LED_SMD:LED_0805_2012Metric
LED2 | D4 | LED_SMD:LED_0805_2012Metric
LED3 | D5 | LED_SMD:LED_0805_2012Metric
3.3k | R1 | Resistor_SMD:R_0805_2012Metric
1.2k | R2, R14 | Resistor_SMD:R_0805_2012Metric
1k | R3, R4 | Resistor_SMD:R_0805_2012Metric
200 | R5, R15 | Resistor_SMD:R_0805_2012Metric
47k | R6 | Resistor_SMD:R_0805_2012Metric
10k | R13, R22, R24, R26, R28, R30 | Resistor_SMD:R_0805_2012Metric
470 | R18-R20 | Resistor_SMD:R_0805_2012Metric
330 | R21, R23, R25, R27, R29 | Resistor_SMD:R_0805_2012Metric
ECS-2520MV-480 | X1 | Oscillator:Oscillator_SMD_ECS_2520MV-xxx-xx-4Pin_2.5x2.0mm
