alexjegers/DAMPING_ADJUSTER/Controller/CAD/SLDPRT/A1005-001.SLDASM

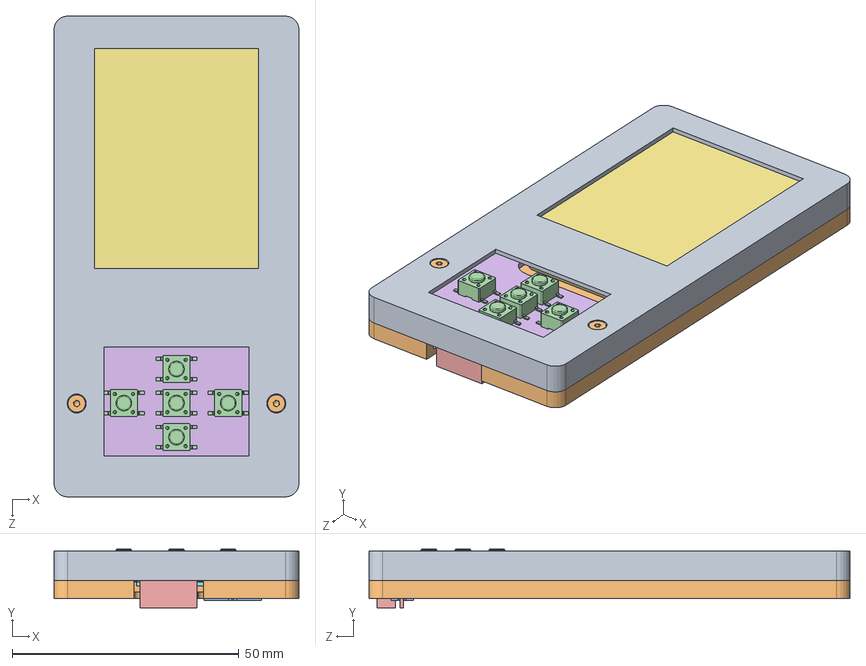
[picture p41: CAD file, 2022-11-11]
Controller/CAD/SLDPRT/A1005-001.SLDASM
54.0 x 13.0 x 106.0 mm
COMPOUND.step x 5
SOLID.step x 20
SOLID-0.step
SOLID-1.step
SOLID-2.step x 5
SOLID-3.step x 22
SOLID-4.step
COMPOUND-5.step
SOLID-6.step
COMPOUND-7.step
COMPOUND-8.step
socket head cap screw_am x 2
socket countersunk head screw_am x 2
