alexjegers/DAMPING_ADJUSTER/Power & Signal Board/CAD/SLDPRT/A1007-001.SLDASM

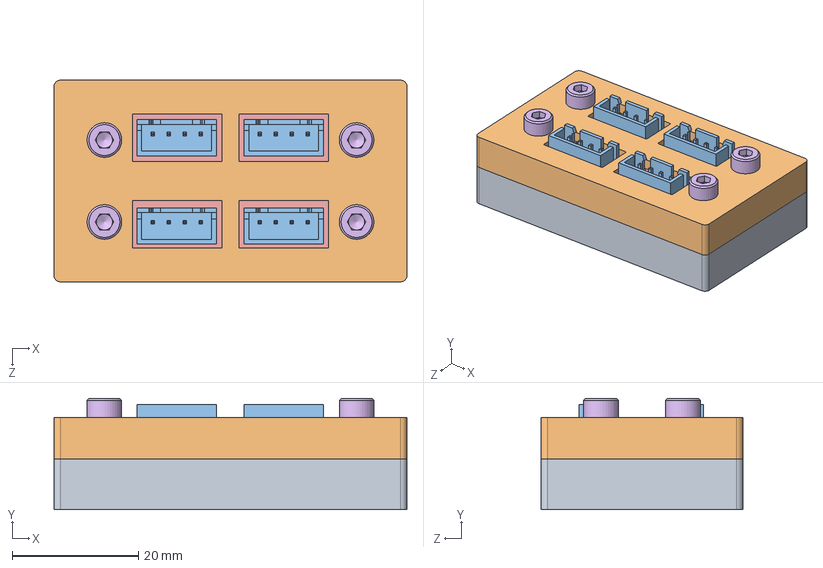
[picture p43: CAD file, 2022-11-11]
Power & Signal Board/CAD/SLDPRT/A1007-001.SLDASM
56.0 x 17.6 x 32.0 mm
COMPOUND.step x 4
SOLID.step x 4
COMPOUND-0.step
socket head cap screw_am x 6
