alexjegers/DAMPING_ADJUSTER/Stepper Motor Controller/CAD/3D Models/A1001-003.SLDASM

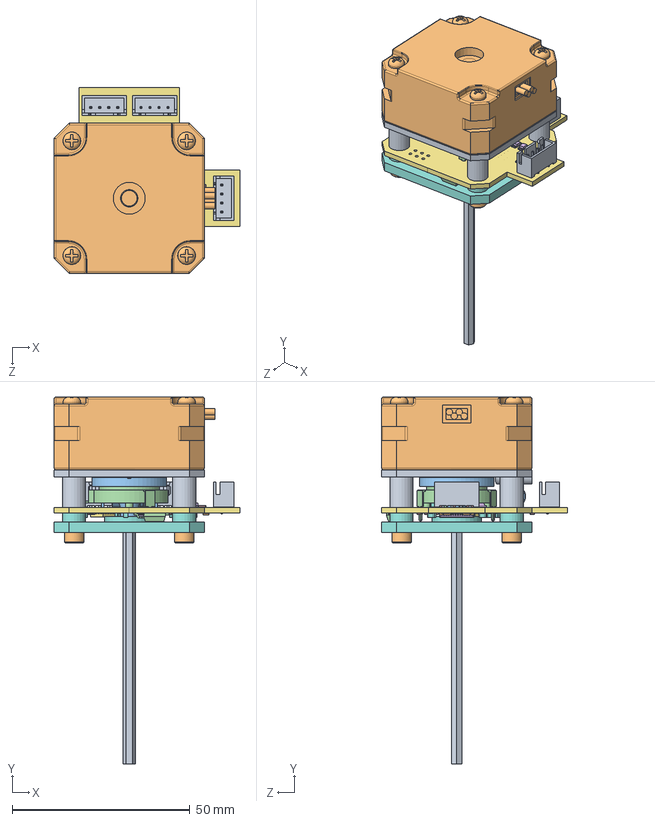
[picture p44: CAD file, 2022-11-15]
Stepper Motor Controller/CAD/3D Models/A1001-003.SLDASM
52.3 x 103.3 x 52.3 mm
SOLID.step x 19
SOLID-0.step x 5
SOLID-1.step
SOLID-2.step x 14
COMPOUND.step x 3
SOLID-3.step x 2
SOLID-4.step
SOLID-5.step
SOLID-6.step
SOLID-7.step
COMPOUND-8.step
socket head cap screw_am x 4
