alexjegers/DAMPING_ADJUSTER/Controller/CAD/SLDPRT/A1003-001.SLDASM

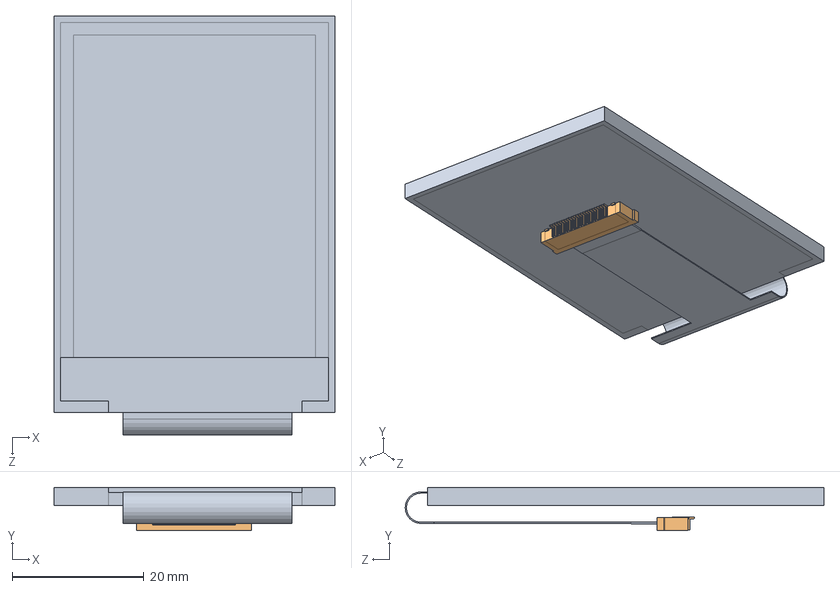
[picture p45: CAD file, 2022-11-11]
Controller/CAD/SLDPRT/A1003-001.SLDASM
42.7 x 6.60 x 63.7 mm
