alexjegers/DAMPING_ADJUSTER/Stepper Motor Controller/CAD/3D Models/A1004-001.SLDASM

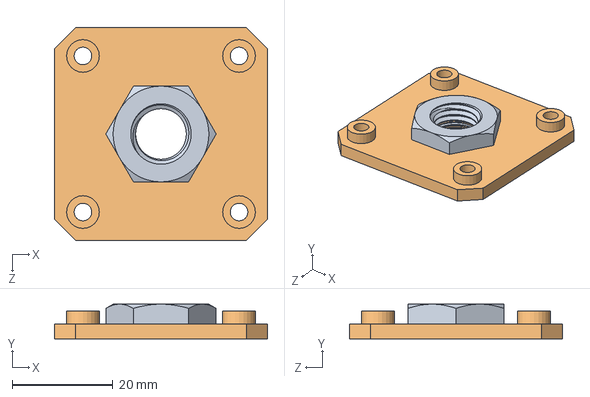
[picture p46: CAD file, 2022-10-05]
Stepper Motor Controller/CAD/3D Models/A1004-001.SLDASM
42.3 x 6.90 x 42.3 mm
