alexjegers/DAMPING_ADJUSTER/Stepper Motor Controller/CAD/3D Models/A1005-001.SLDASM

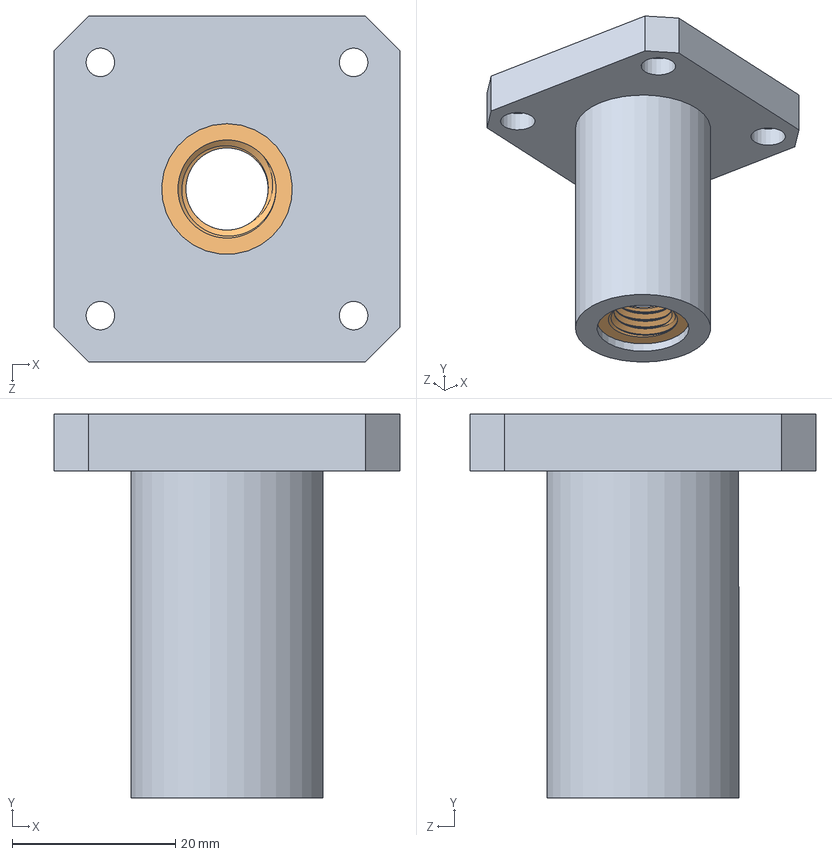
[picture p48: CAD file, 2022-10-05]
Stepper Motor Controller/CAD/3D Models/A1005-001.SLDASM
42.3 x 47.0 x 42.3 mm
