alexjegers/DAMPING_ADJUSTER/Controller/CAD/SLDPRT/1028-002.SLDPRT

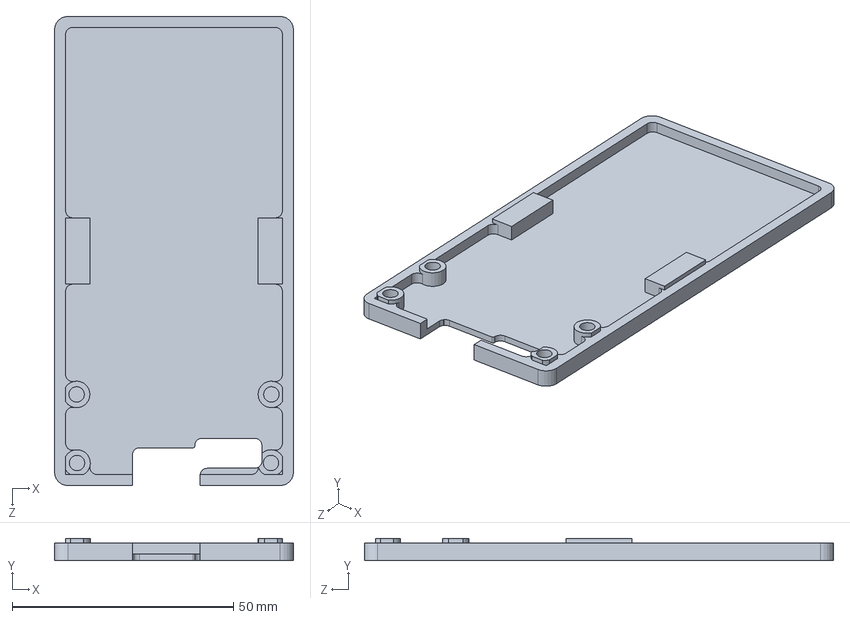
[picture p51: CAD file, 2022-12-20]
Controller/CAD/SLDPRT/1028-002.SLDPRT
54.0 x 5.00 x 106.0 mm
