alexjegers/DAMPING_ADJUSTER/Controller/CAD/STEP/1030-001.STEP

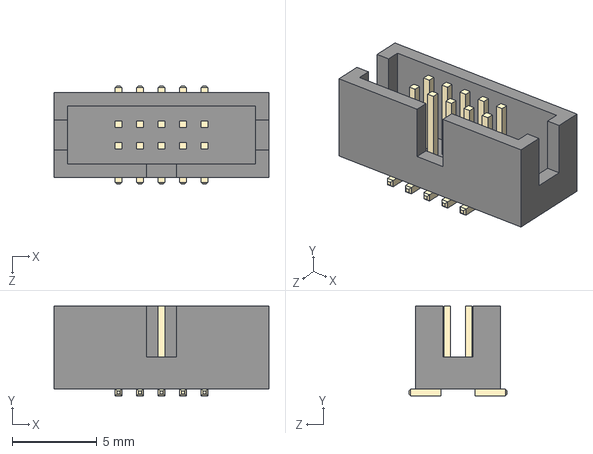
[picture p52: CAD file, 2022-10-19]
Controller/CAD/STEP/1030-001.STEP
12.7 x 5.30 x 5.80 mm
