alexjegers/DAMPING_ADJUSTER/Controller/Testing and Other/Carbon Fiber Mold/1028-001 Mold.SLDPRT

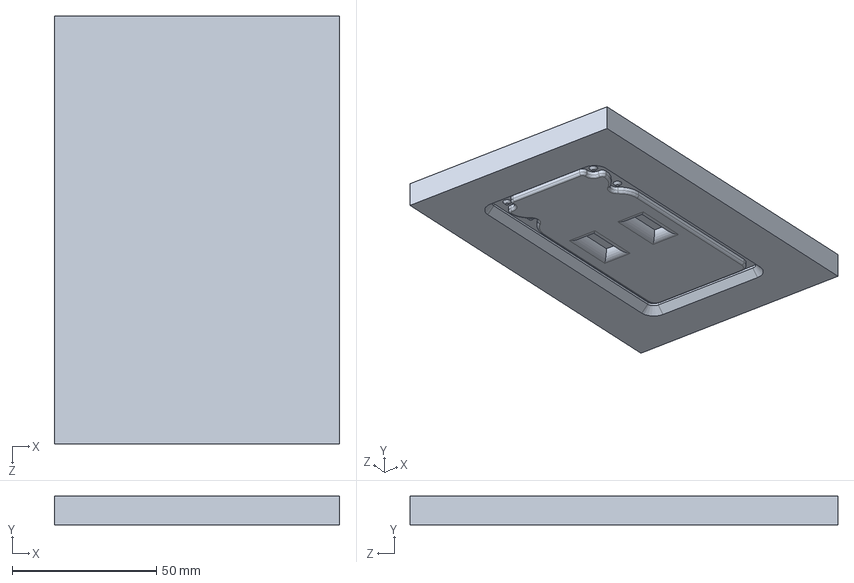
[picture p53: CAD file, 2022-10-11]
Controller/Testing and Other/Carbon Fiber Mold/1028-001 Mold.SLDPRT
99.0 x 9.90 x 148.5 mm
