alexjegers/DAMPING_ADJUSTER/Power & Signal Board/CAD/SLDPRT/1031-001.SLDPRT

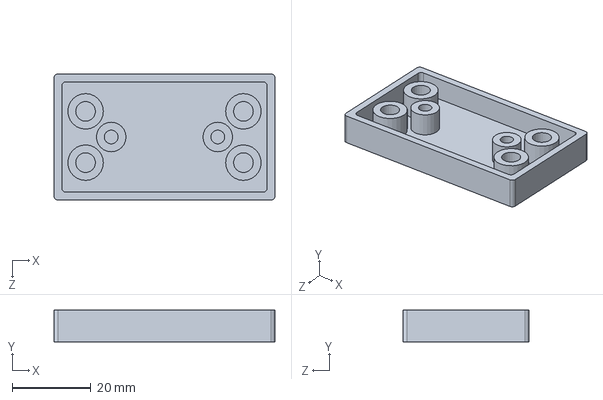
[picture p54: CAD file, 2022-11-11]
Power & Signal Board/CAD/SLDPRT/1031-001.SLDPRT
56.0 x 8.00 x 32.0 mm
