alexjegers/DAMPING_ADJUSTER/Power & Signal Board/CAD/STEP/Power_Board_001.step

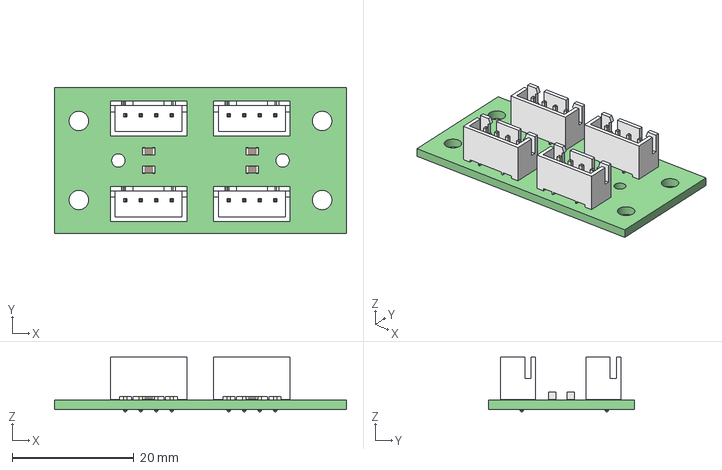
[picture p55: CAD file, 2022-11-11]
Power & Signal Board/CAD/STEP/Power_Board_001.step
48.0 x 24.0 x 9.00 mm
