alexjegers/DAMPING_ADJUSTER/Stepper Motor Controller/CAD/3D Models/1010-004.SLDPRT

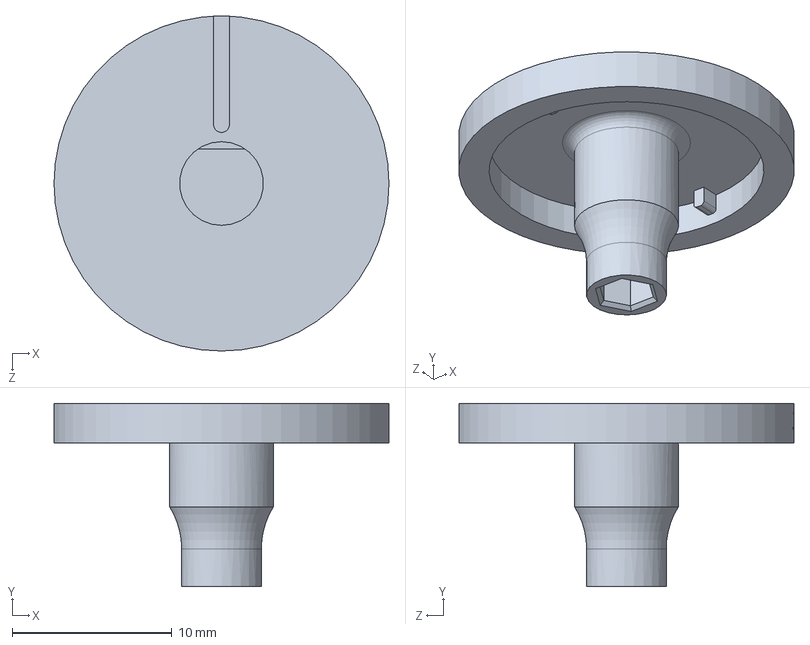
[picture p56: CAD file, 2022-11-15]
Stepper Motor Controller/CAD/3D Models/1010-004.SLDPRT
21.0 x 11.5 x 21.0 mm
