alexjegers/DAMPING_ADJUSTER/Stepper Motor Controller/CAD/STEP/1005-002.STEP

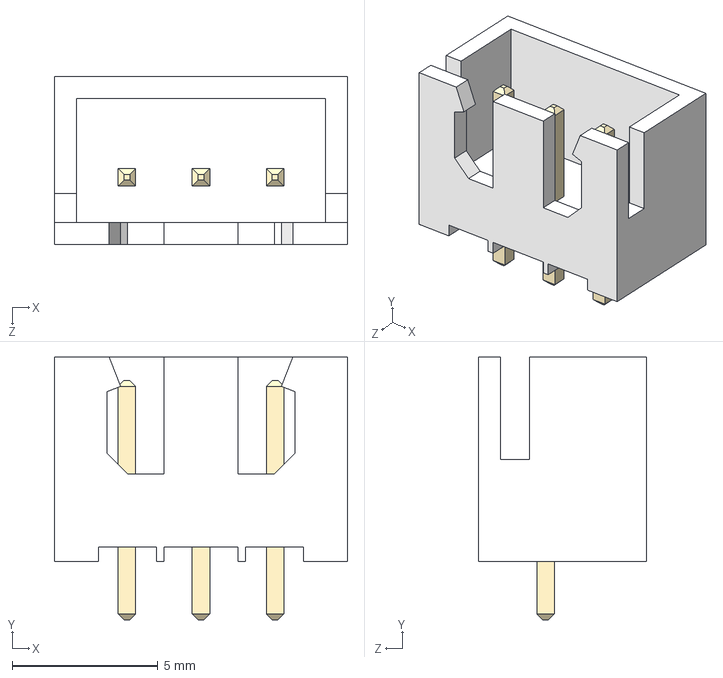
[picture p58: CAD file, 2022-10-05]
Stepper Motor Controller/CAD/STEP/1005-002.STEP
10.0 x 9.00 x 5.75 mm
