alexjegers/DAMPING_ADJUSTER/Stepper Motor Controller/CAD/STL/1013-1.STL

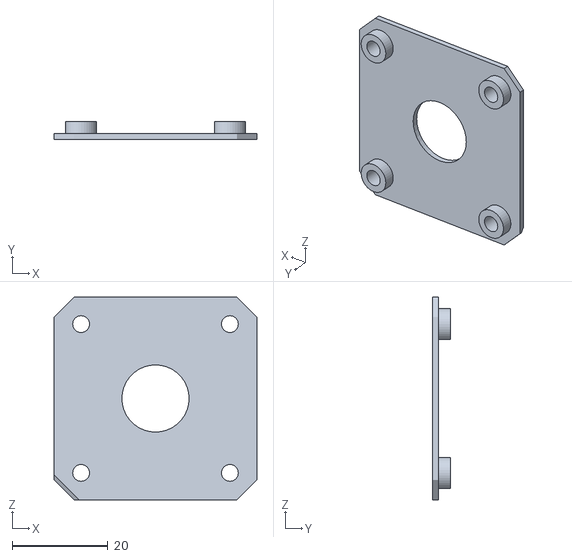
[picture p59: CAD file, 2022-10-05]
Stepper Motor Controller/CAD/STL/1013-1.STL
42.3 x 3.70 x 42.3
