alexjegers/DAMPING_ADJUSTER/Controller/Testing and Other/Carbon Fiber Mold/1028-001 Mold 2.SLDPRT

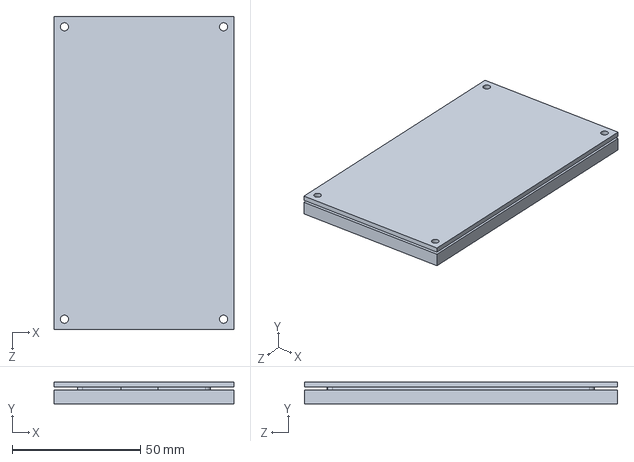
[picture p60: CAD file, 2022-10-11]
Controller/Testing and Other/Carbon Fiber Mold/1028-001 Mold 2.SLDPRT
70.0 x 8.50 x 122.0 mm
