alexjegers/DAMPING_ADJUSTER/Power & Signal Board/CAD/SLDPRT/1032-001.SLDPRT

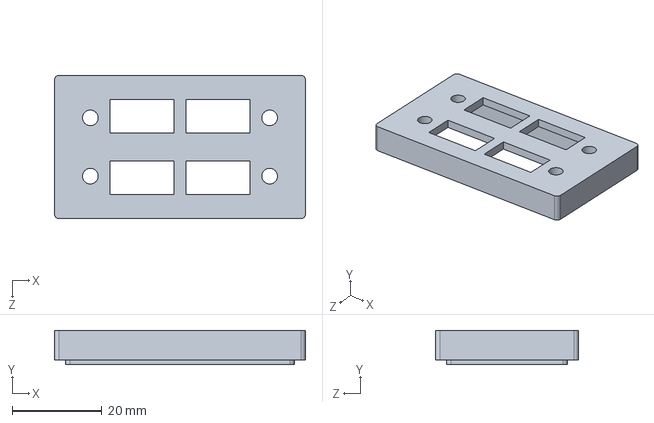
[picture p61: CAD file, 2022-11-11]
Power & Signal Board/CAD/SLDPRT/1032-001.SLDPRT
56.0 x 7.65 x 32.0 mm
