alexjegers/DAMPING_ADJUSTER/Stepper Motor Controller/CAD/3D Models/1019-002.SLDPRT

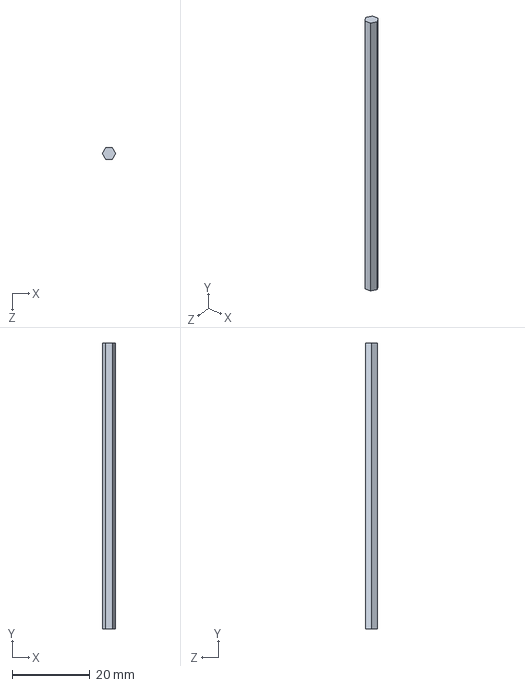
[picture p62: CAD file, 2022-11-15]
Stepper Motor Controller/CAD/3D Models/1019-002.SLDPRT
3.46 x 73.7 x 3.00 mm
