alexjegers/DAMPING_ADJUSTER/Stepper Motor Controller/CAD/STEP/1005-003.STEP

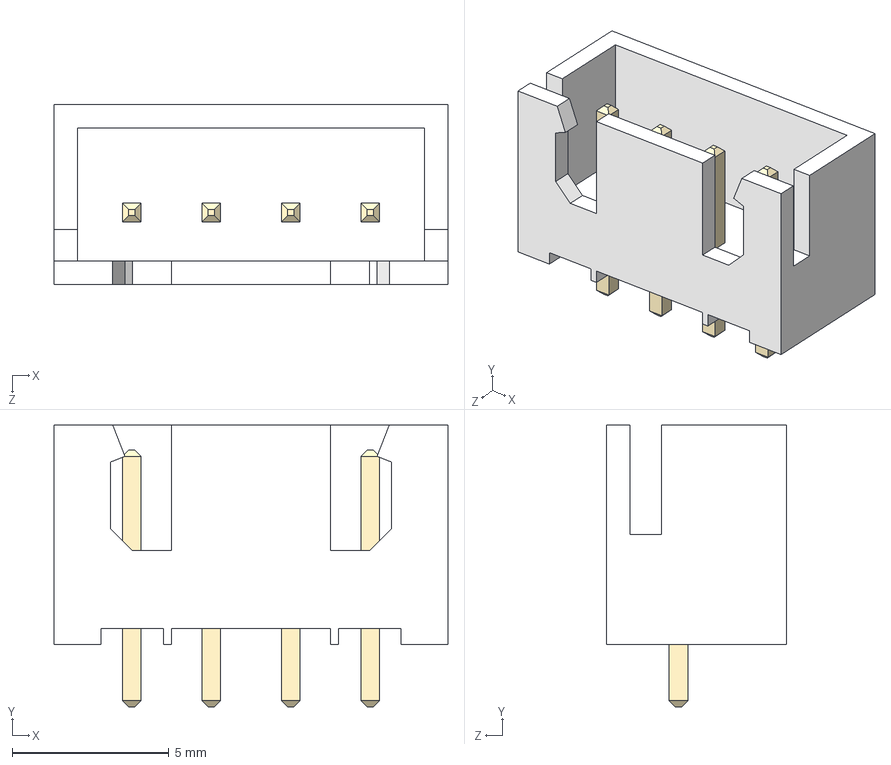
[picture p63: CAD file, 2022-10-05]
Stepper Motor Controller/CAD/STEP/1005-003.STEP
12.6 x 9.00 x 5.75 mm
