alexjegers/DAMPING_ADJUSTER/Stepper Motor Controller/CAD/STL/1013-2.STL

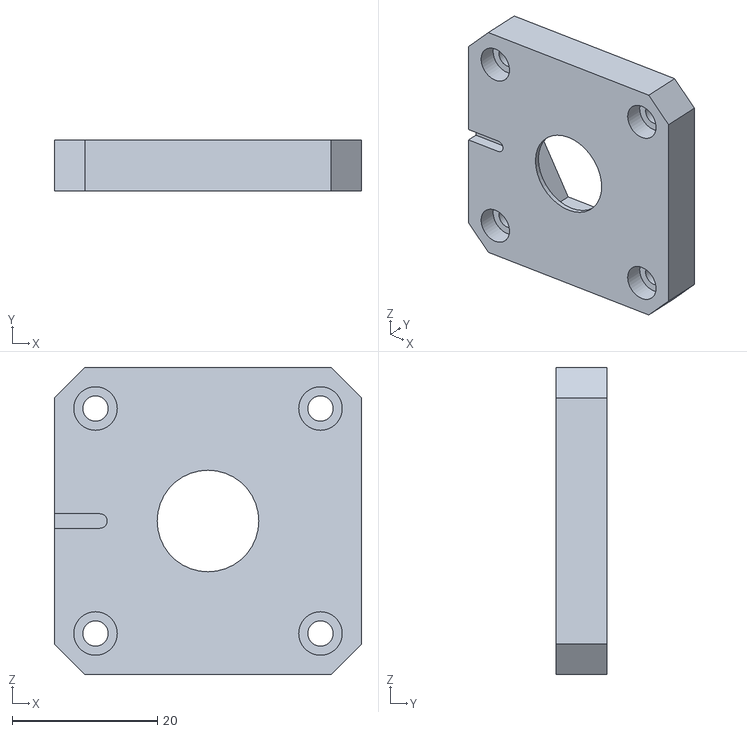
[picture p64: CAD file, 2022-10-05]
Stepper Motor Controller/CAD/STL/1013-2.STL
42.3 x 7.00 x 42.3
