alexjegers/DAMPING_ADJUSTER/Controller/CAD/STEP/1024-001.STEP

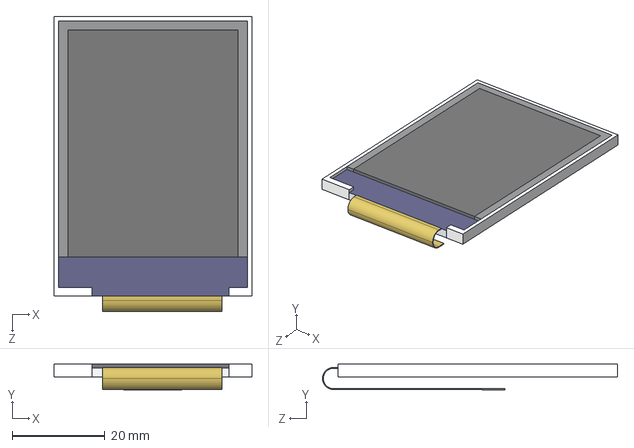
[picture p65: CAD file, 2022-10-05]
Controller/CAD/STEP/1024-001.STEP
42.7 x 5.55 x 63.7 mm
