alexjegers/DAMPING_ADJUSTER/Stepper Motor Controller/CAD/STEP/1001.STEP

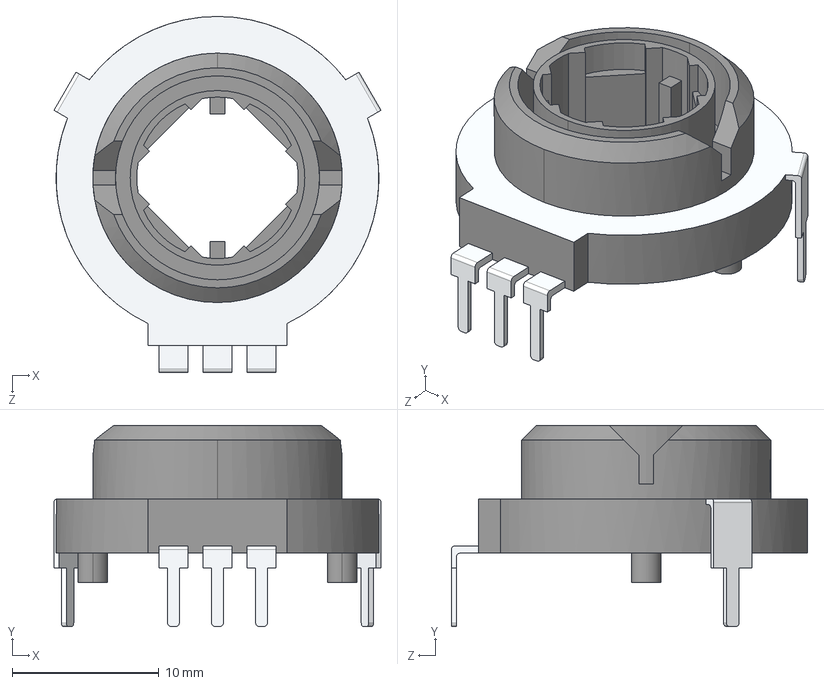
[picture p66: CAD file, 2022-10-05]
Stepper Motor Controller/CAD/STEP/1001.STEP
22.3 x 13.7 x 24.3 mm
