alexjegers/DAMPING_ADJUSTER/Stepper Motor Controller/CAD/STL/1018-2.STL

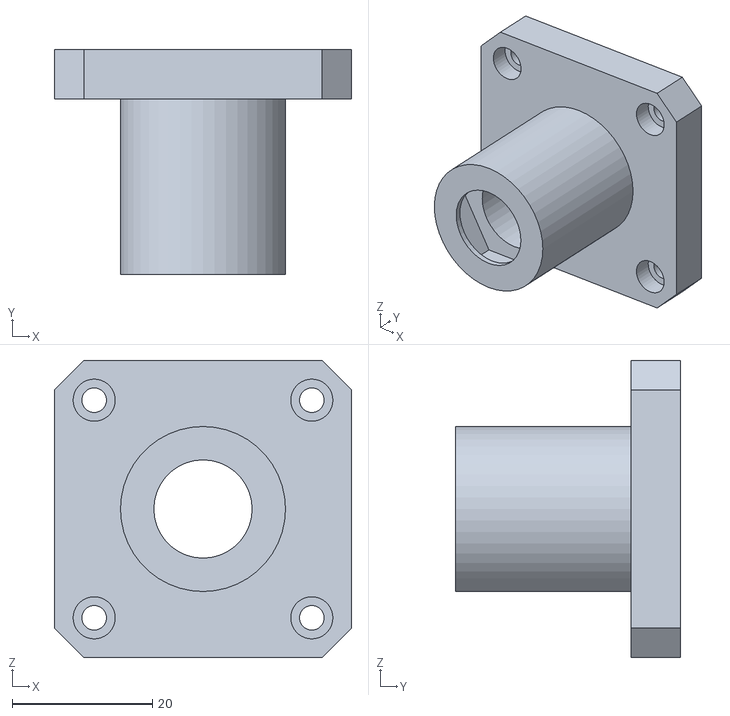
[picture p67: CAD file, 2022-10-05]
Stepper Motor Controller/CAD/STL/1018-2.STL
42.3 x 32.0 x 42.3
