alexjegers/DAMPING_ADJUSTER/Controller/CAD/STEP/1025.STEP

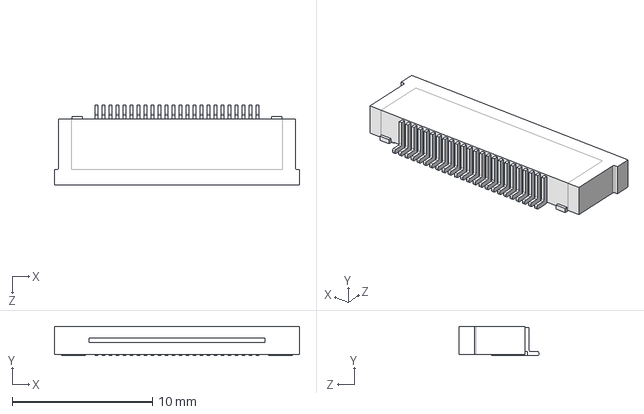
[picture p68: CAD file, 2022-10-05]
Controller/CAD/STEP/1025.STEP
17.5 x 2.10 x 5.70 mm
