alexjegers/DAMPING_ADJUSTER/Stepper Motor Controller/CAD/3D Models/1011-004.SLDPRT

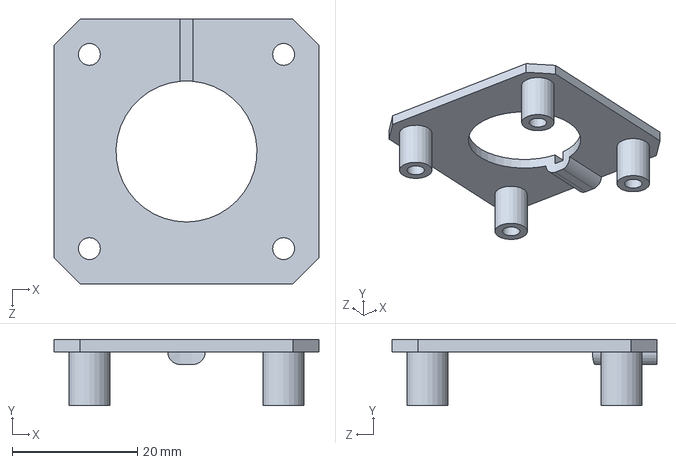
[picture p69: CAD file, 2022-10-11]
Stepper Motor Controller/CAD/3D Models/1011-004.SLDPRT
42.3 x 10.6 x 42.3 mm
