alexjegers/DAMPING_ADJUSTER/Stepper Motor Controller/CAD/STEP/1005-001.STEP

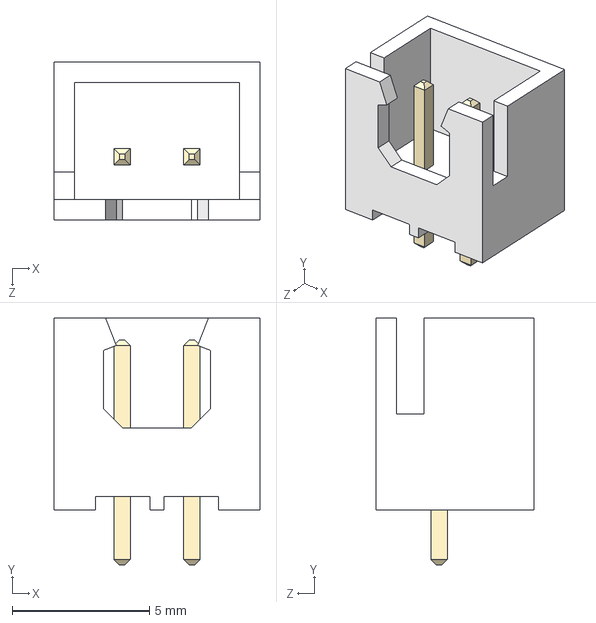
[picture p70: CAD file, 2022-10-05]
Stepper Motor Controller/CAD/STEP/1005-001.STEP
7.50 x 9.00 x 5.75 mm
