alexjegers/DAMPING_ADJUSTER/Controller/CAD/STEP/1027-001.STEP

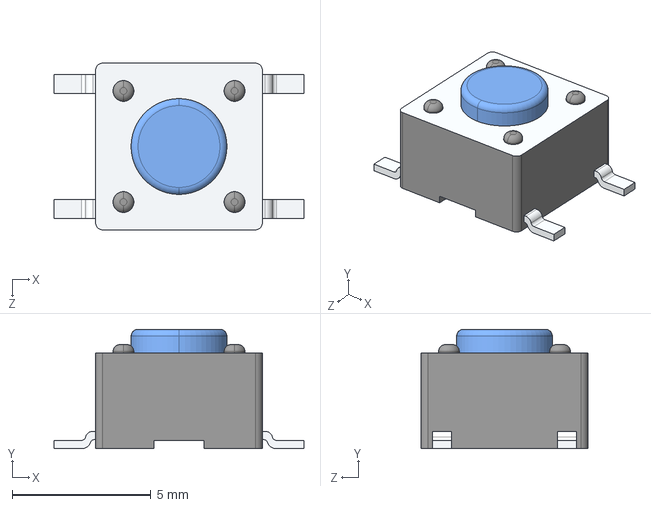
[picture p72: CAD file, 2022-10-05]
Controller/CAD/STEP/1027-001.STEP
9.00 x 4.30 x 6.00 mm
