alexjegers/DAMPING_ADJUSTER/Stepper Motor Controller/CAD/3D Models/1013-002.SLDPRT

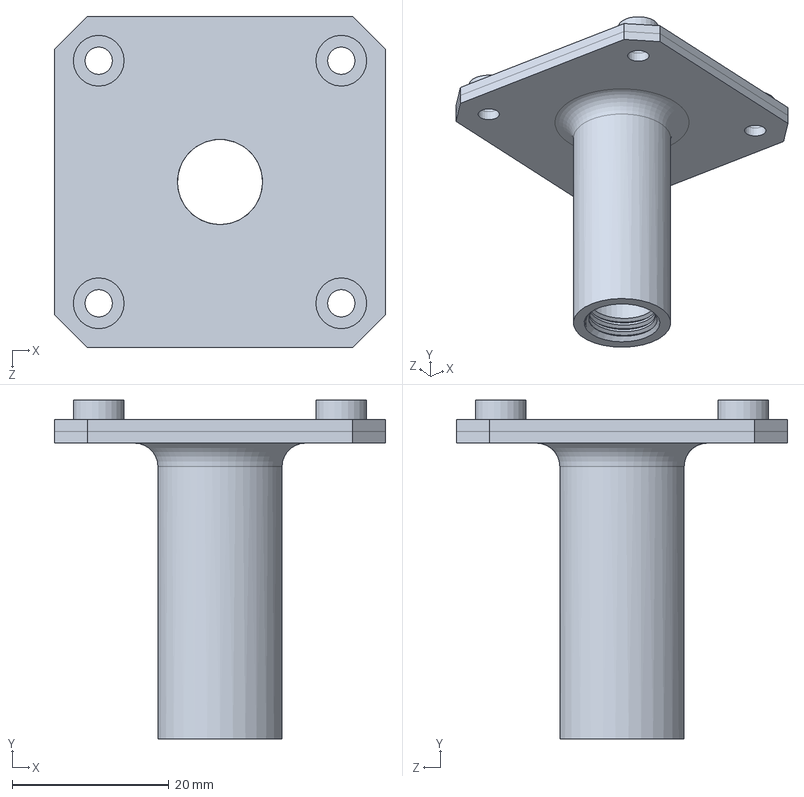
[picture p73: CAD file, 2022-10-11]
Stepper Motor Controller/CAD/3D Models/1013-002.SLDPRT
42.3 x 43.3 x 42.3 mm
