alexjegers/DAMPING_ADJUSTER/Stepper Motor Controller/CAD/STEP/1007.STEP

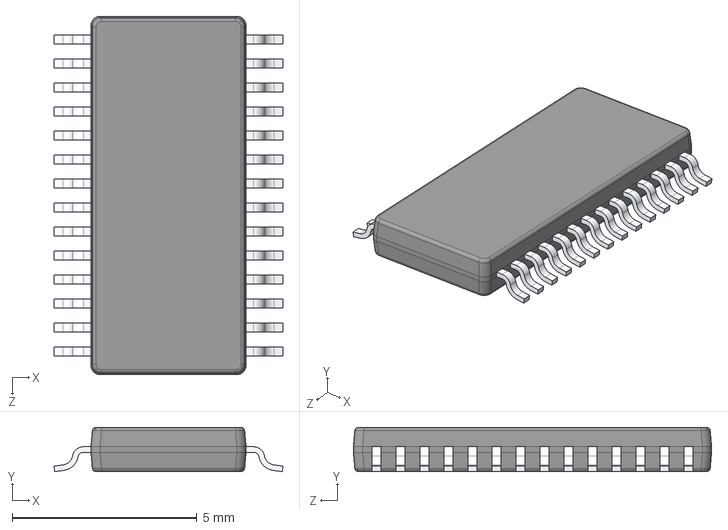
[picture p74: CAD file, 2022-10-05]
Stepper Motor Controller/CAD/STEP/1007.STEP
6.20 x 1.20 x 9.70 mm
