alexjegers/DAMPING_ADJUSTER/Controller/CAD/SLDPRT/1029-001.SLDPRT

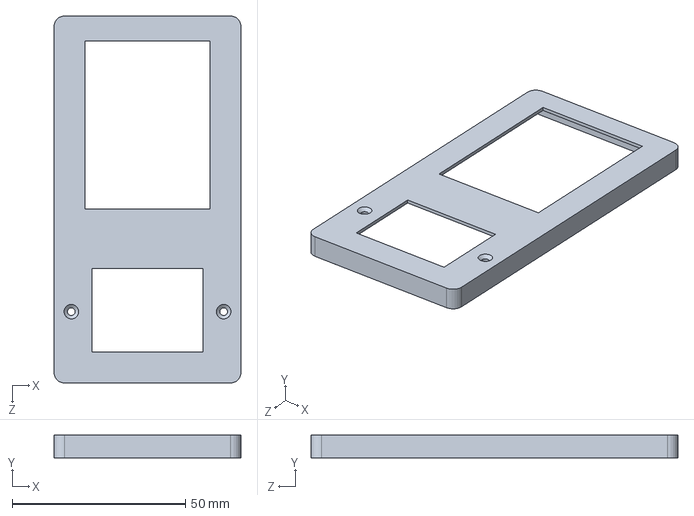
[picture p75: CAD file, 2022-10-11]
Controller/CAD/SLDPRT/1029-001.SLDPRT
54.0 x 6.50 x 106.0 mm
