alexjegers/DAMPING_ADJUSTER/Controller/CAD/SLDPRT/Contr_Mock.SLDPRT

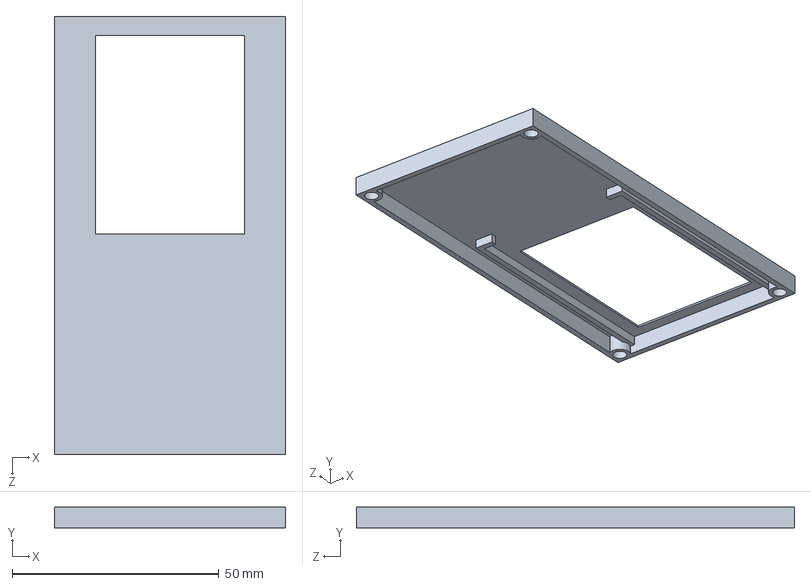
[picture p76: CAD file, 2022-10-05]
Controller/CAD/SLDPRT/Contr_Mock.SLDPRT
56.0 x 5.00 x 106.0 mm
