alexjegers/DAMPING_ADJUSTER/Stepper Motor Controller/CAD/3D Models/1010-001.SLDPRT

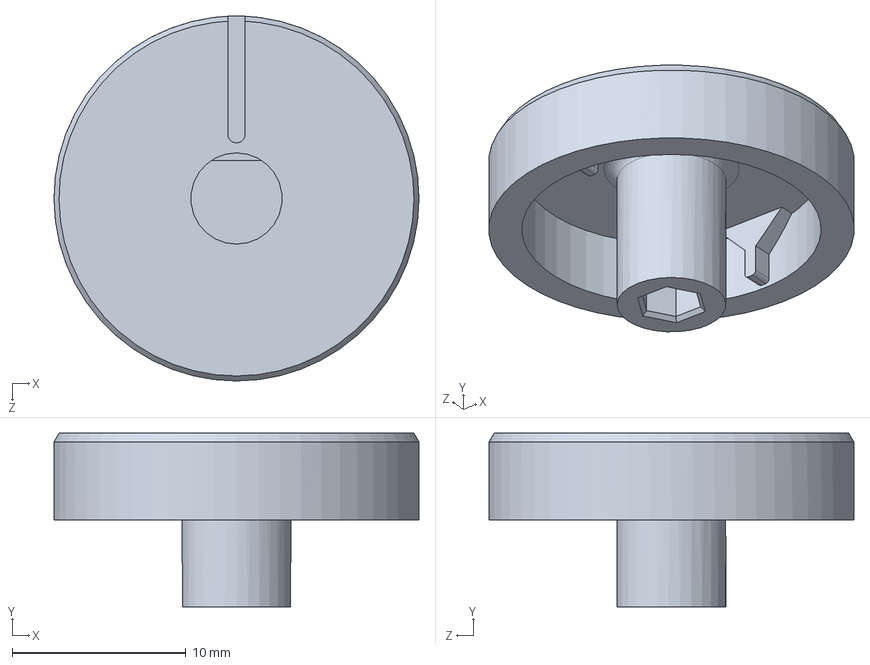
[picture p77: CAD file, 2022-10-05]
Stepper Motor Controller/CAD/3D Models/1010-001.SLDPRT
21.0 x 10.0 x 21.0 mm
