alexjegers/DAMPING_ADJUSTER/Stepper Motor Controller/CAD/3D Models/1013-001.SLDPRT

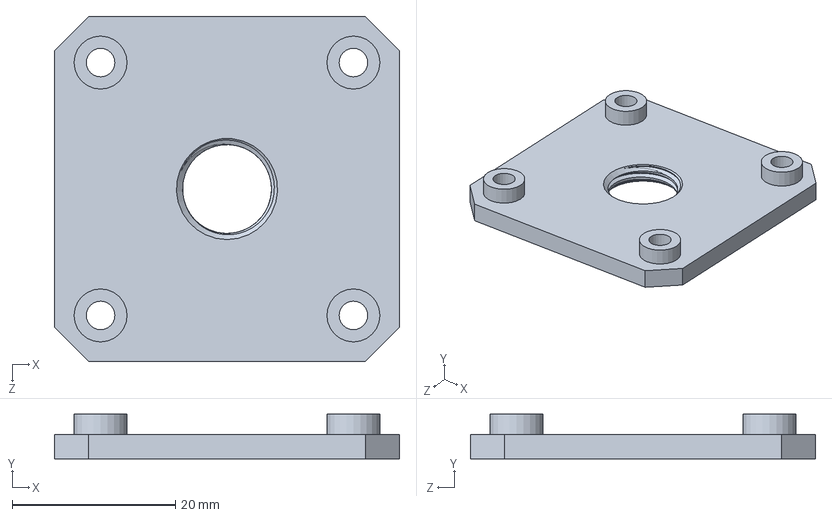
[picture p78: CAD file, 2022-10-05]
Stepper Motor Controller/CAD/3D Models/1013-001.SLDPRT
42.3 x 5.50 x 42.3 mm
