alexjegers/DAMPING_ADJUSTER/Controller/CAD/SLDPRT/1020-001.SLDPRT

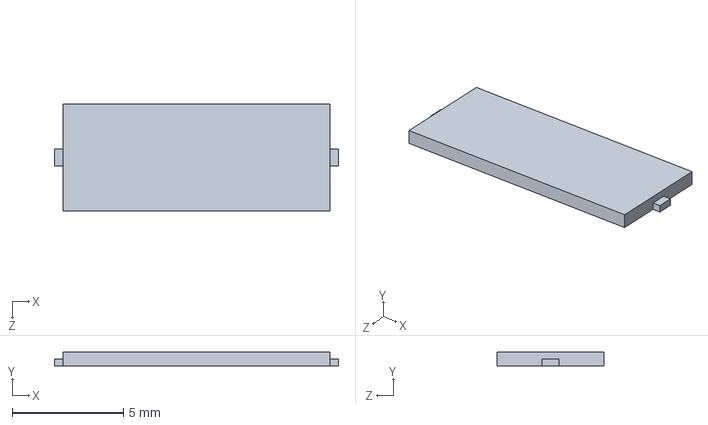
[picture p79: CAD file, 2022-10-05]
Controller/CAD/SLDPRT/1020-001.SLDPRT
12.8 x 0.65 x 4.80 mm
