alexjegers/DAMPING_ADJUSTER/Controller/CAD/SLDPRT/1028-001.SLDPRT

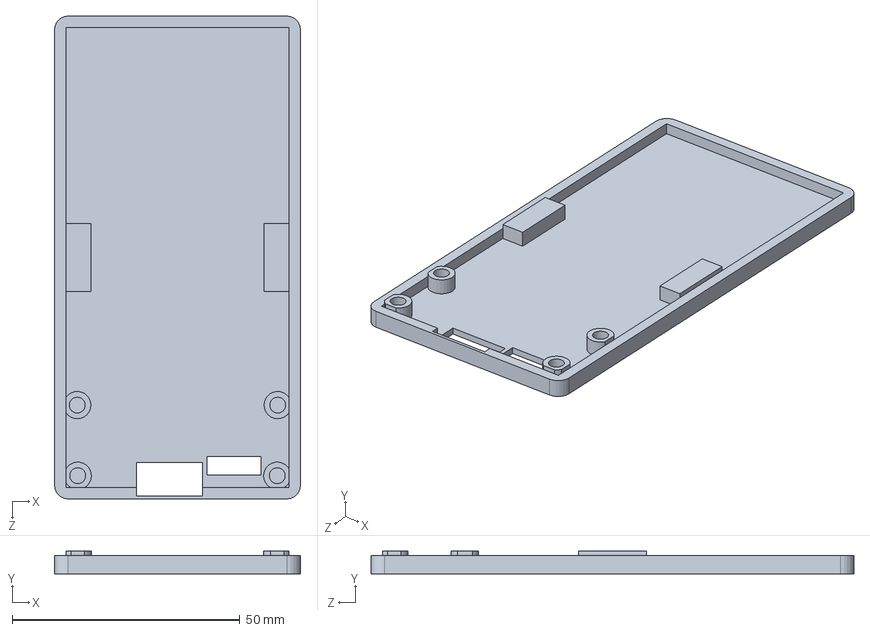
[picture p80: CAD file, 2022-10-05]
Controller/CAD/SLDPRT/1028-001.SLDPRT
54.0 x 5.00 x 106.0 mm
