alexjegers/DAMPING_ADJUSTER/Controller/CAD/SLDPRT/1026-001.SLDPRT

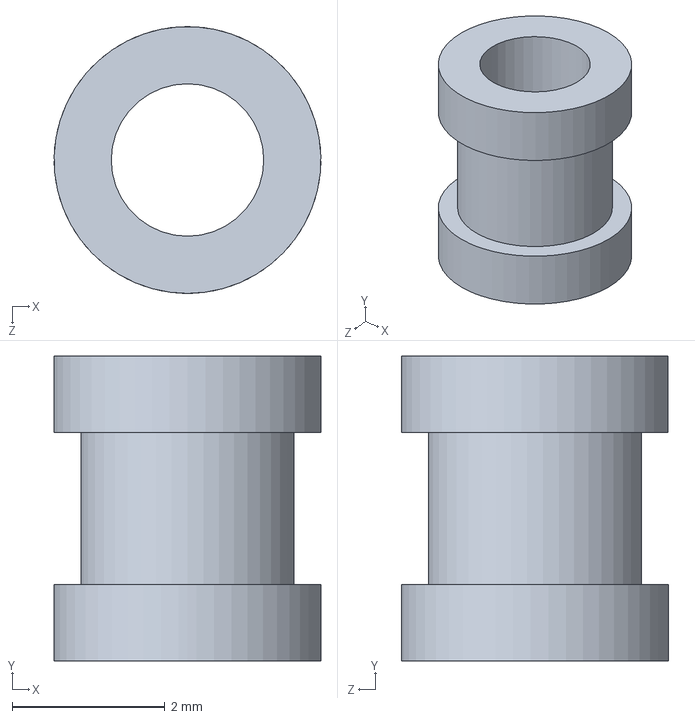
[picture p81: CAD file, 2022-10-05]
Controller/CAD/SLDPRT/1026-001.SLDPRT
3.50 x 4.00 x 3.50 mm
