alexjegers/DAMPING_ADJUSTER/Stepper Motor Controller/CAD/3D Models/1001-001.SLDPRT

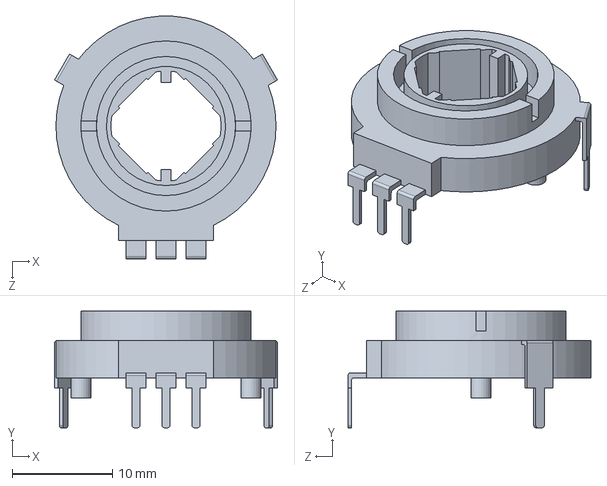
[picture p82: CAD file, 2022-10-05]
Stepper Motor Controller/CAD/3D Models/1001-001.SLDPRT
22.3 x 11.7 x 24.2 mm
