alexjegers/DAMPING_ADJUSTER/Stepper Motor Controller/CAD/3D Models/1010-002.SLDPRT

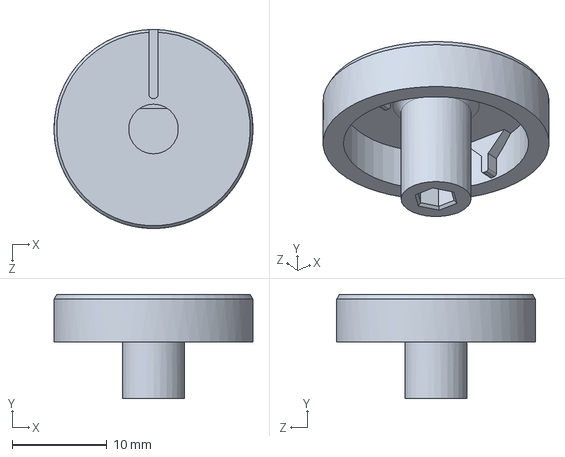
[picture p83: CAD file, 2022-10-05]
Stepper Motor Controller/CAD/3D Models/1010-002.SLDPRT
21.0 x 11.0 x 21.0 mm
