alexjegers/DAMPING_ADJUSTER/Stepper Motor Controller/CAD/3D Models/1002-001.SLDPRT

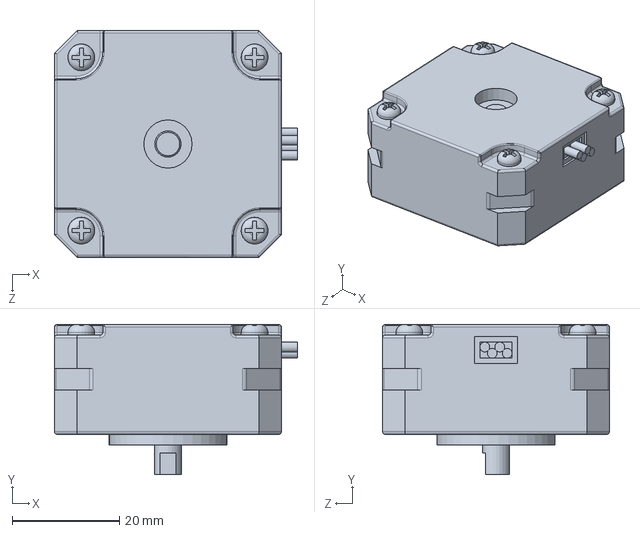
[picture p84: CAD file, 2022-10-05]
Stepper Motor Controller/CAD/3D Models/1002-001.SLDPRT
45.3 x 28.0 x 42.3 mm
