alexjegers/DAMPING_ADJUSTER/Stepper Motor Controller/CAD/3D Models/1019-001.SLDPRT

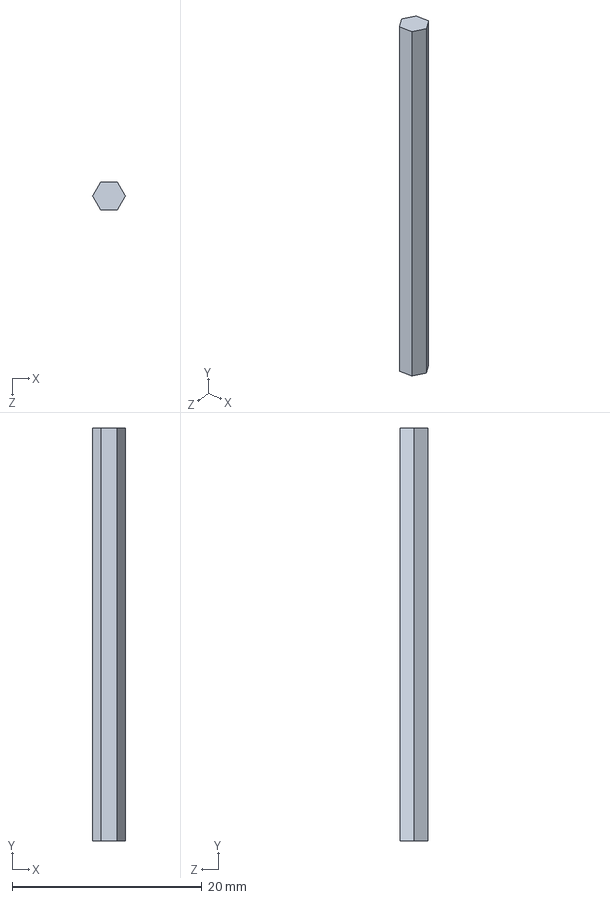
[picture p85: CAD file, 2022-10-05]
Stepper Motor Controller/CAD/3D Models/1019-001.SLDPRT
3.46 x 43.6 x 3.00 mm
