alexjegers/DAMPING_ADJUSTER/Stepper Motor Controller/CAD/3D Models/1011-001.SLDPRT

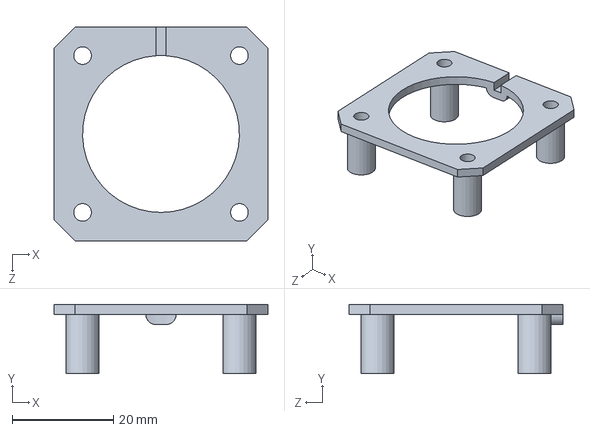
[picture p86: CAD file, 2022-10-05]
Stepper Motor Controller/CAD/3D Models/1011-001.SLDPRT
42.3 x 13.7 x 42.3 mm
