alexjegers/DAMPING_ADJUSTER/Stepper Motor Controller/CAD/3D Models/1010-003.SLDPRT

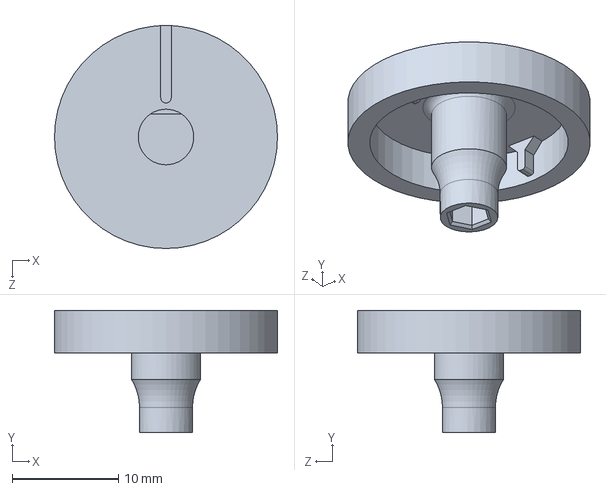
[picture p87: CAD file, 2022-10-05]
Stepper Motor Controller/CAD/3D Models/1010-003.SLDPRT
21.0 x 11.5 x 21.0 mm
