alexjegers/DAMPING_ADJUSTER/Stepper Motor Controller/CAD/3D Models/1011-002.SLDPRT

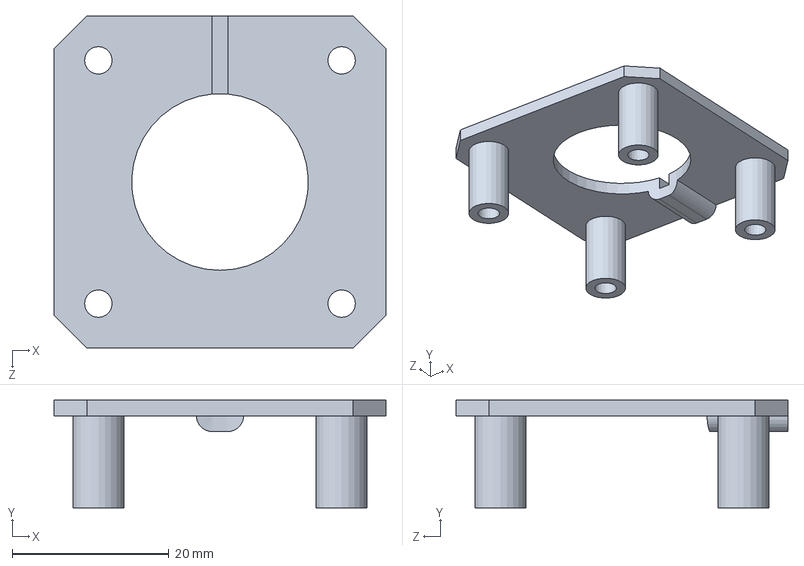
[picture p88: CAD file, 2022-10-05]
Stepper Motor Controller/CAD/3D Models/1011-002.SLDPRT
42.3 x 13.7 x 42.3 mm
