alexjegers/DAMPING_ADJUSTER/Stepper Motor Controller/CAD/3D Models/1018-001.SLDPRT

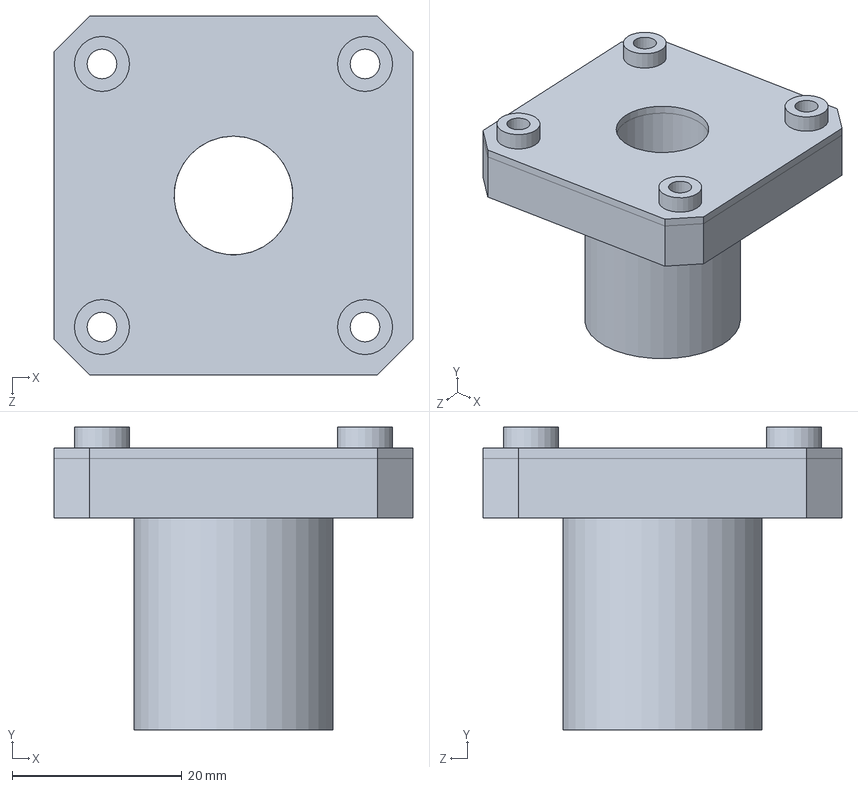
[picture p89: CAD file, 2022-10-05]
Stepper Motor Controller/CAD/3D Models/1018-001.SLDPRT
42.3 x 35.7 x 42.3 mm
