alexjegers/DAMPING_ADJUSTER/Stepper Motor Controller/CAD/3D Models/1012-001.SLDPRT

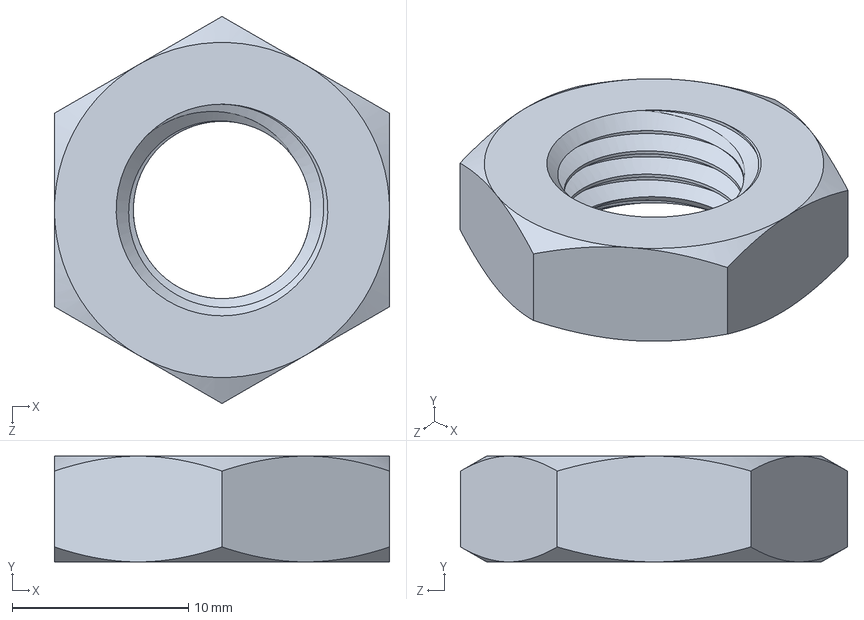
[picture p90: CAD file, 2022-10-05]
Stepper Motor Controller/CAD/3D Models/1012-001.SLDPRT
19.0 x 6.00 x 21.9 mm
