alexjegers/DAMPING_ADJUSTER/Stepper Motor Controller/CAD/3D Models/1018-002.SLDPRT

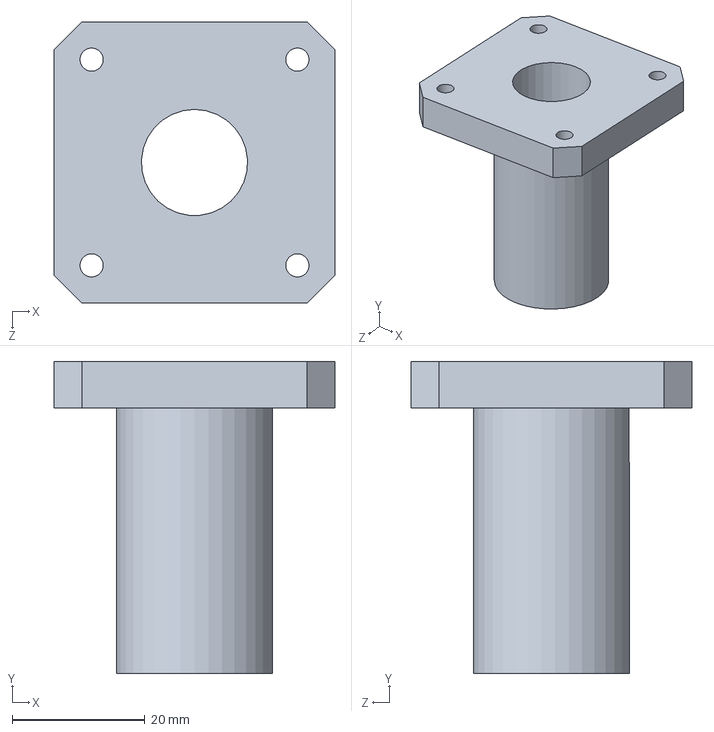
[picture p91: CAD file, 2022-10-05]
Stepper Motor Controller/CAD/3D Models/1018-002.SLDPRT
42.3 x 47.0 x 42.3 mm
