alexjegers/DAMPING_ADJUSTER/Stepper Motor Controller/CAD/3D Models/1011-003.SLDPRT

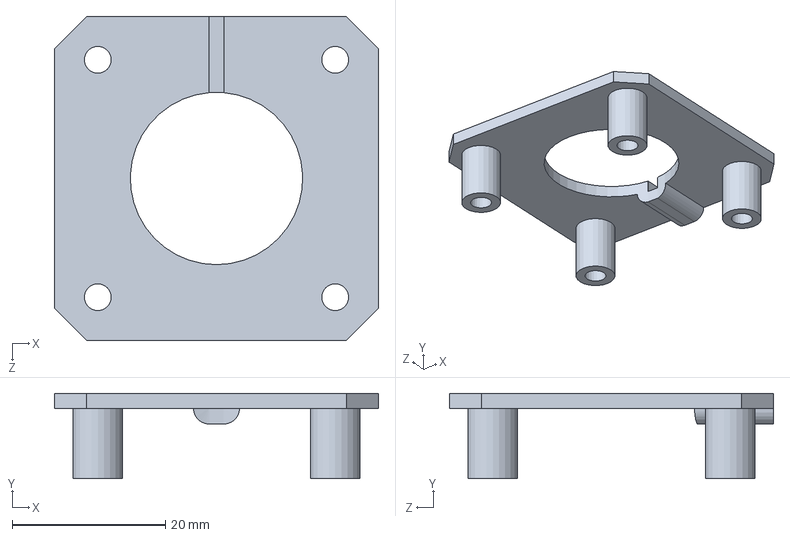
[picture p92: CAD file, 2022-10-05]
Stepper Motor Controller/CAD/3D Models/1011-003.SLDPRT
42.3 x 11.1 x 42.3 mm
