alexjegers/DAMPING_ADJUSTER/(list of files, cad)

Other CAD files:
Controller/CAD/SLDPRT/A1004-001.SLDASM
Controller/CAD/STEP/A1003.STEP
Controller/CAD/SLDPRT/1025-001.SLDPRT
Stepper Motor Controller/CAD/3D Models/1007-001.SLDPRT
Controller/CAD/DXF/1028-002.DXF
Controller/CAD/DXF/1028-002.SLDDRW
Controller/CAD/SLDPRT/1024-001.SLDPRT
Controller/CAD/SLDPRT/1027-001.SLDPRT
Controller/CAD/SLDPRT/1030-001.SLDPRT
Power & Signal Board/CAD/SLDPRT/Power_Board_001.SLDASM
Stepper Motor Controller/CAD/3D Models/1005-001.SLDPRT
Stepper Motor Controller/CAD/Footprint Drawings/1001.SLDDRW
Stepper Motor Controller/CAD/STL/1010-001.STL
Stepper Motor Controller/CAD/STL/1010-002.STL
Stepper Motor Controller/CAD/STL/1010-003.STL
Stepper Motor Controller/CAD/STL/1010-004.STL
Stepper Motor Controller/CAD/STL/1011-001.STL
Stepper Motor Controller/CAD/STL/1011-002.STL
Stepper Motor Controller/CAD/STL/1011-003.STL
Stepper Motor Controller/CAD/STL/1011-004.STL
Stepper Motor Controller/CAD/STL/1013-001.STL
Stepper Motor Controller/CAD/STL/1018-002.STL
