alexjegers/DAMPING_ADJUSTER/Controller/Testing and Other/Checklists & Verifications/Checklist for Controller.docx

Checklist for Controller

Circuit Design

Requirement | Status
MOSFET driving the LCD backlight, connected to PMW pin?
LCD data bits start at the lsb of a single MCU port
Clock signal pin broken out?
Reset pin broken out?
1k pull up resistors on IIC lines?
EEPROM???

Schematic

Requirement | Status
Verified pinouts of all ICs?
Same comm connector pinout as stepper board?

PCB Layout

Requirement | Status
Nothing below LCD so it can lay flat on PCB?
JTAG Header courtyard is appropriate size?
