alexjegers/DAMPING_ADJUSTER/Stepper Motor Controller/Testing and Other/Long Cable Testing/IIC Over a Distance.docx

Cable Length Effect on IIC Communication

Configurations tested:

- 100kHz and 10kHz clock speed (SCL) through standard jumper wires.
- 100kHz and 10kHz clock speed (SCL) through 340cm long cable, only the signal wires.
- 100kHz and 10kHz clock speed (SCL) through 340cm long cable with power and ground.

Wire: Single jumper

Pull-up: 1k

Frequency: 10kHz

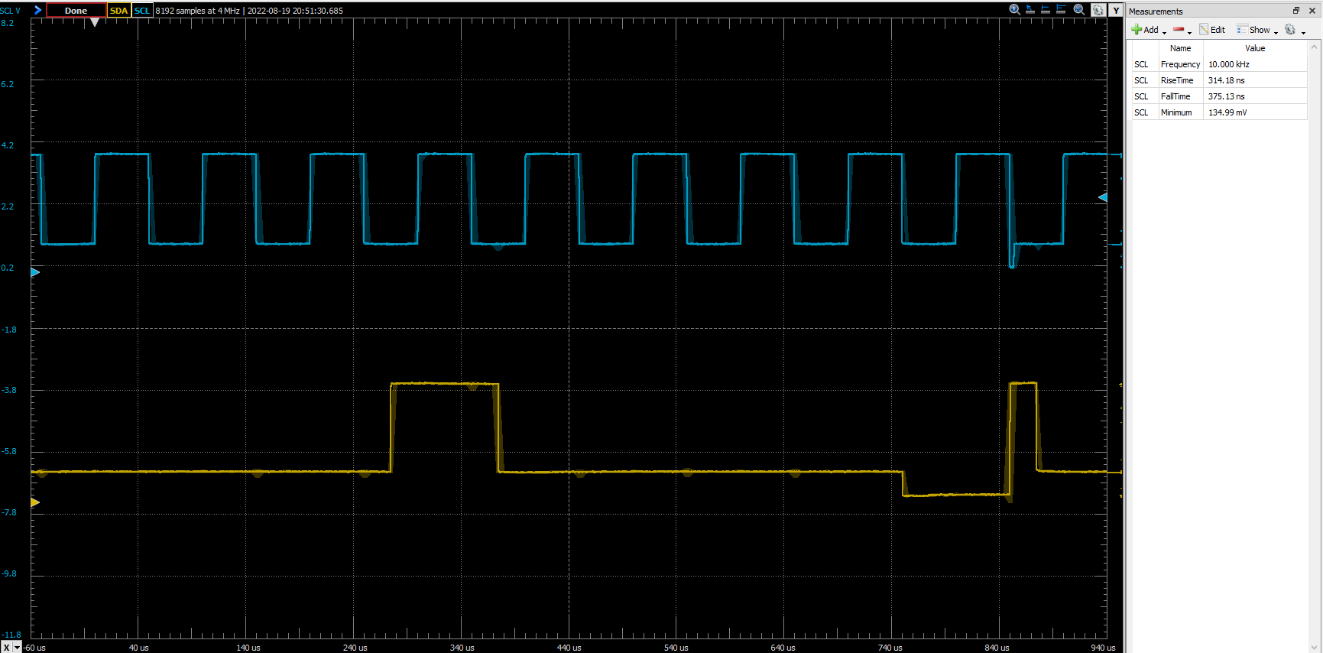
[picture p94: figure]

Wire: Single jumpers

Pull-up: 1k

Frequency: 100kHz

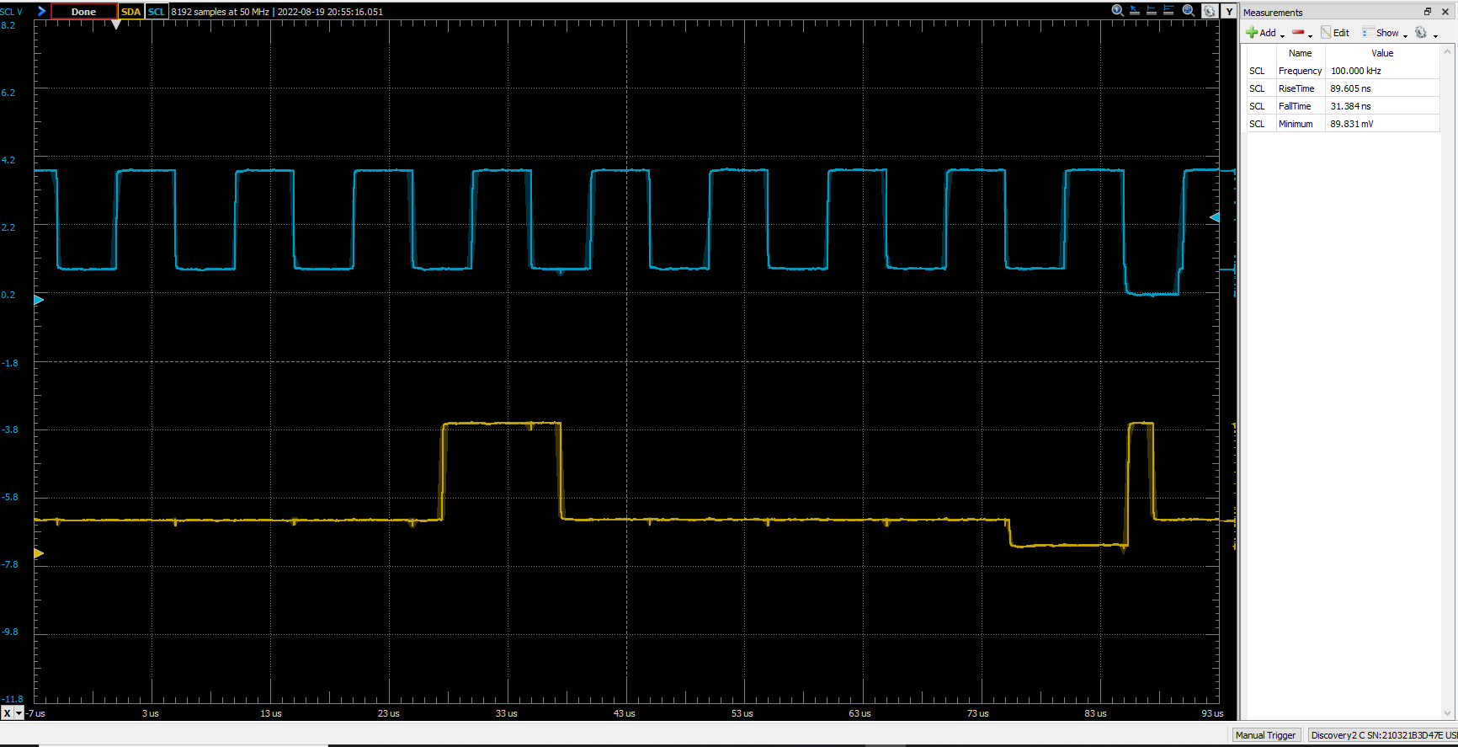
[picture p95: figure]

Wire: 340cm, only signal wires

Pull-up: 1k

Frequency: 10k

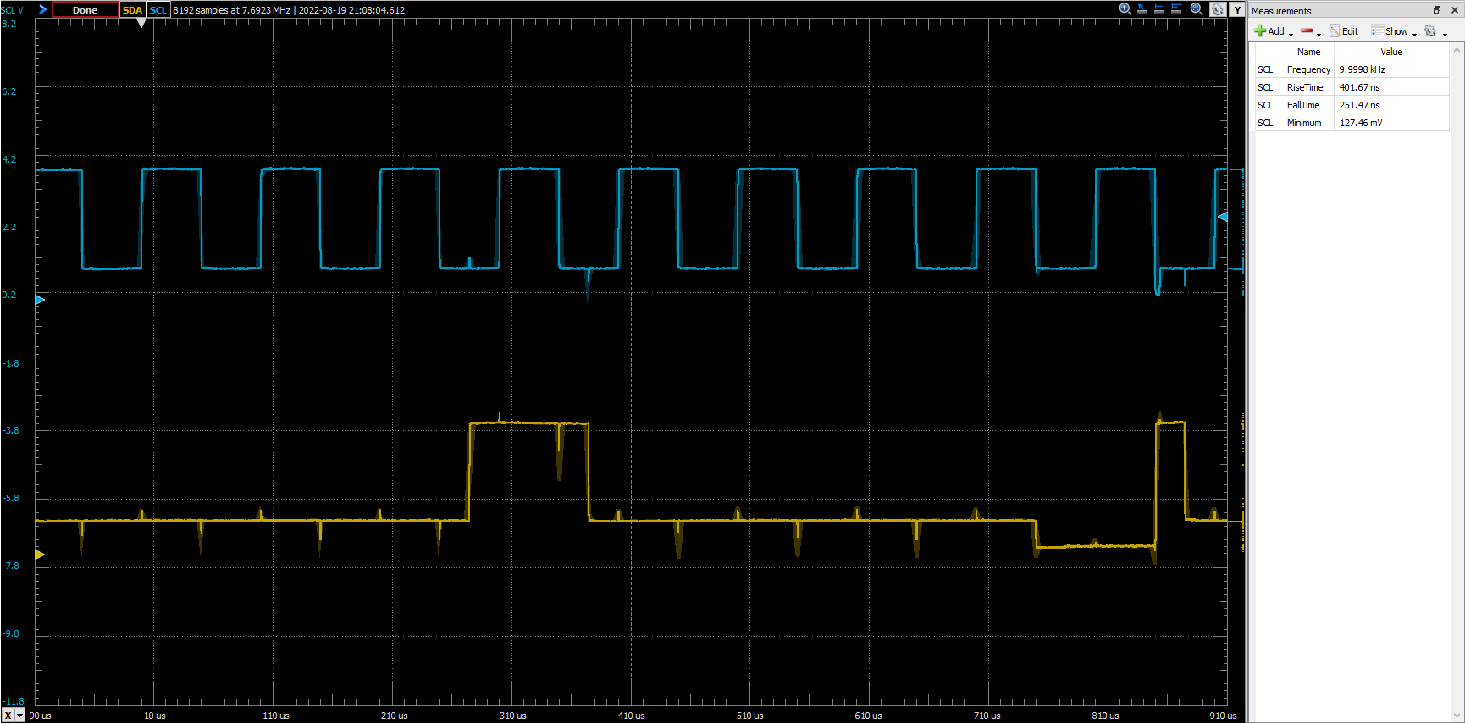
[picture p96: figure]

Wire: 340cm, only signal wires

Pull-up: 1k

Frequency: 100k

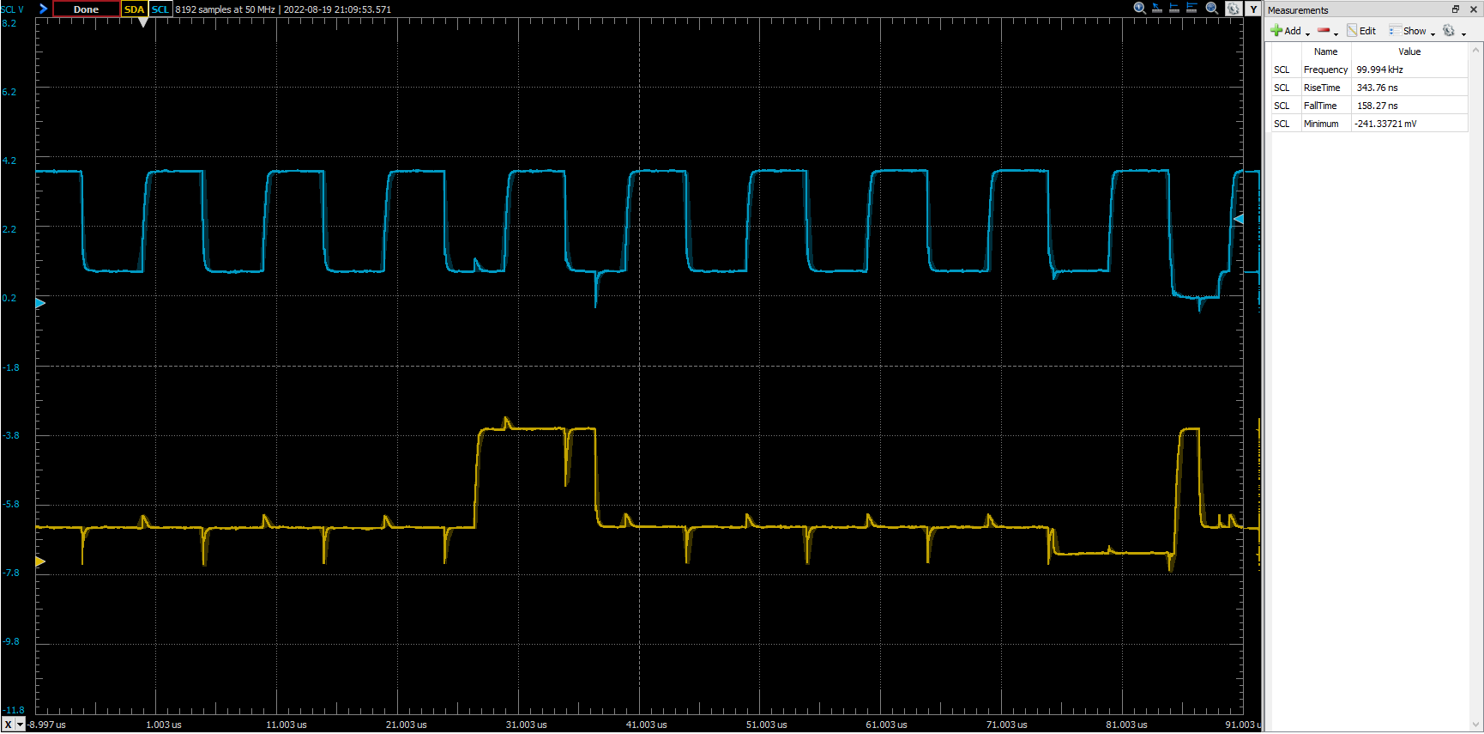
[picture p97: figure]
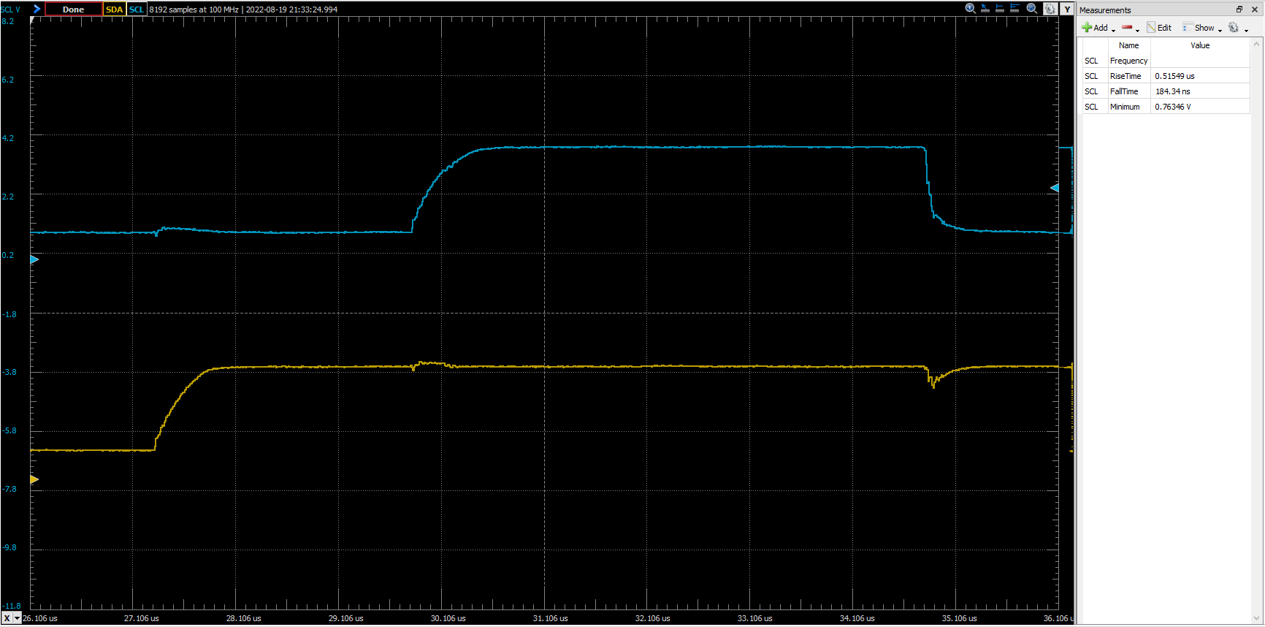
[picture p98: figure]

Wire: 340cm, signal wires and power wires.

Pull-up: 1k

Frequency: 10k

Note: Too much noise for it to get an accurate rise and fall time.

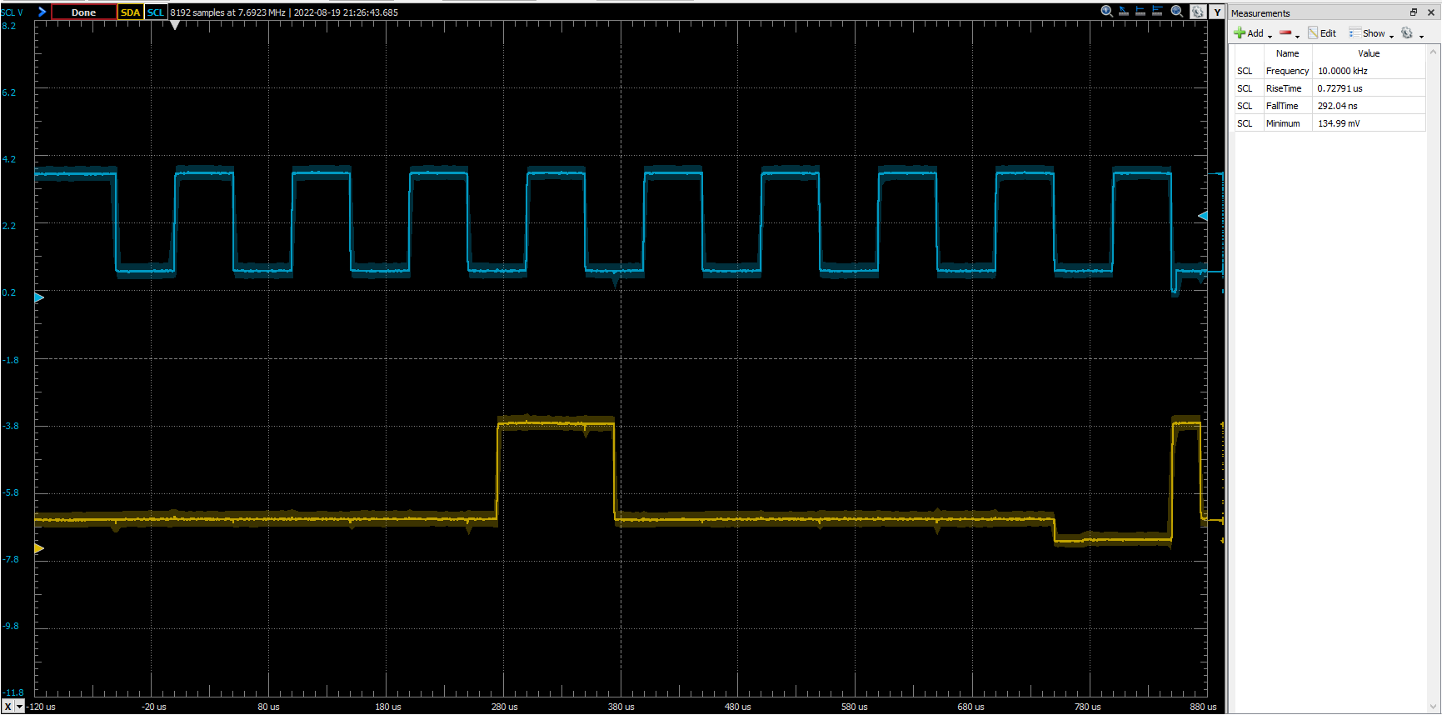
[picture p99: figure]

Wire: 340cm, signal wires and power wires.

Pull-up: 1k

Frequency: 100k

Note: Too much noise for it to get an accurate rise and fall time.

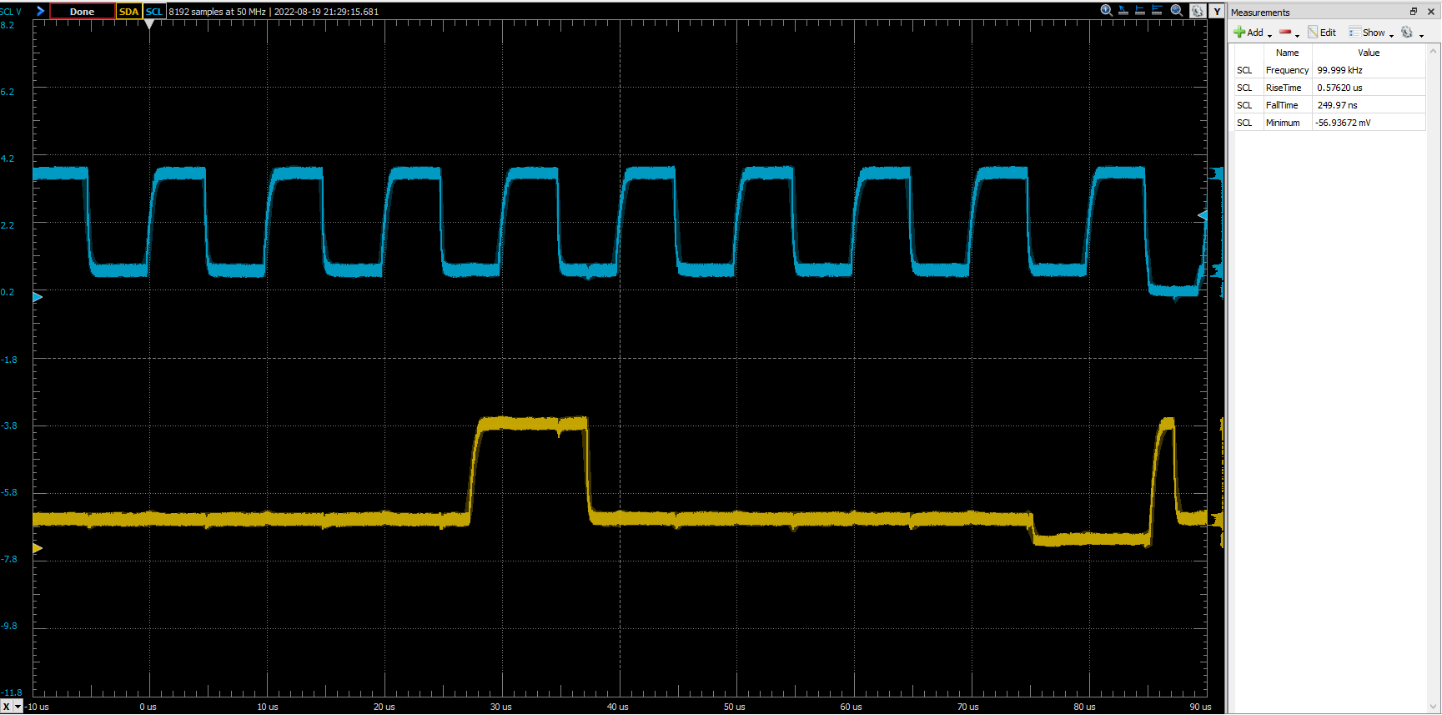
[picture p100: figure]
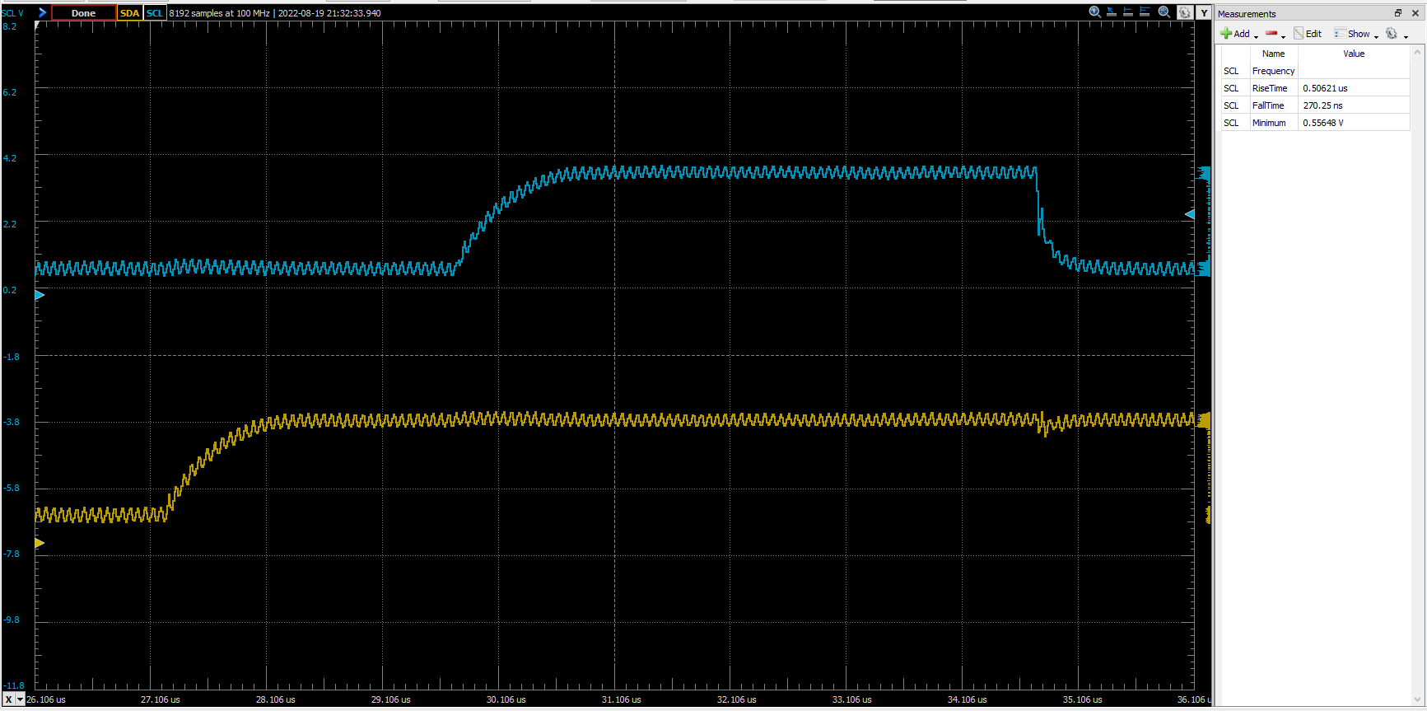
[picture p101: figure]
