alexjegers/DAMPING_ADJUSTER/Stepper Motor Controller/Testing and Other/Long Cable Testing/Motor Power thru Long Wire.docx

Cable Length Effect on Stepper Motor Power Supply and IIC Lines

Power Supply Voltage When Supplied Directly (Picture 1)

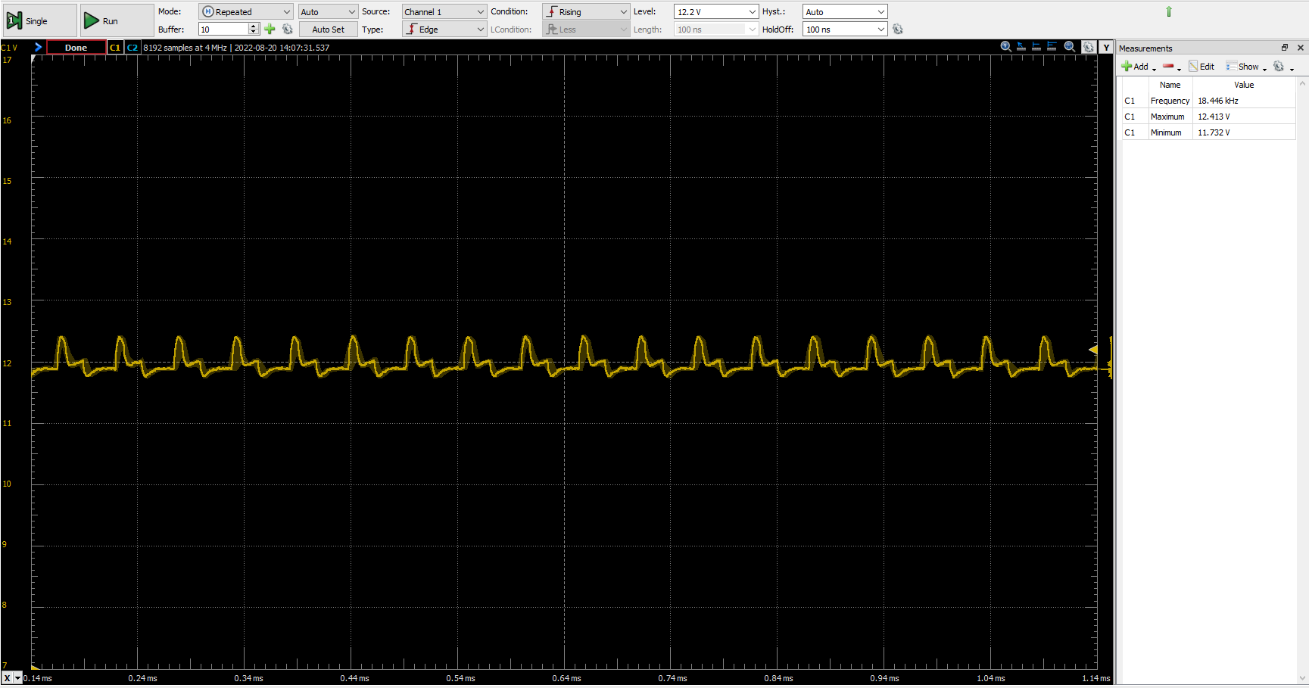
[picture p102: figure]

Voltage supplied is 12V.

Power Supply Voltage When Ran Through 340cm of Cable and IIC Clock (Picture 2)

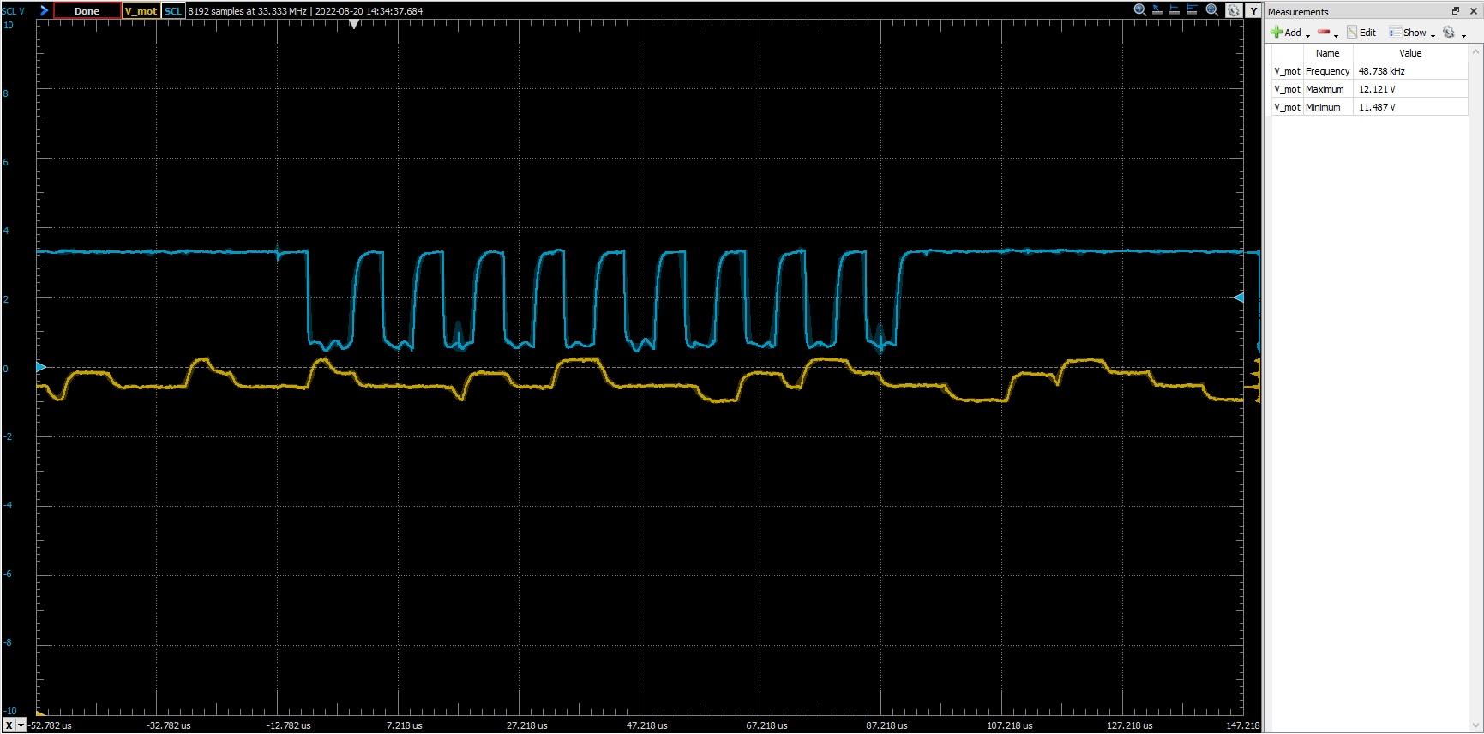
[picture p103: figure]

IIC clock speed is 100kHz.
