alexjegers/DAMPING_ADJUSTER/Controller/Testing and Other/Checklists & Verifications/Controller Board Pinout Verification.xlsx

Sheet: Template
Pin Number | My Symbol | Pin Number2 | Data Sheet | Check
1 |  | 1 |  | TRUE
2 |  | 2 |  | TRUE
3 |  | 3 |  | TRUE
4 |  | 4 |  | TRUE
5 |  | 5 |  | TRUE
6 |  | 6 |  | TRUE
7 |  | 7 |  | TRUE
8 |  | 8 |  | TRUE
9 |  | 9 |  | TRUE
10 |  | 10 |  | TRUE
11 |  | 11 |  | TRUE
12 |  | 12 |  | TRUE
13 |  | 13 |  | TRUE
14 |  | 14 |  | TRUE
15 |  | 15 |  | TRUE
16 |  | 16 |  | TRUE
17 |  | 17 |  | TRUE
18 |  | 18 |  | TRUE
19 |  | 19 |  | TRUE
20 |  | 20 |  | TRUE
21 |  | 21 |  | TRUE
22 |  | 22 |  | TRUE
23 |  | 23 |  | TRUE
24 |  | 24 |  | TRUE
25 |  | 25 |  | TRUE
26 |  | 26 |  | TRUE
27 |  | 27 |  | TRUE
28 |  | 28 |  | TRUE
29 |  | 29 |  | TRUE
30 |  | 30 |  | TRUE
31 |  | 31 |  | TRUE
32 |  | 32 |  | TRUE
33 |  | 33 |  | TRUE

Sheet: ATSAM4LC2B
Pin Number | My Symbol | Pin Number2 | Data Sheet | Check | Pin Function | Multiplexing
1 | PA00 | 1 | PA00 | TRUE | XIN | Enable oscillator
2 | PA01 | 2 | PA01 | TRUE | XOUT | Enable oscillator
3 | PA02 | 3 | PA02 | TRUE
4 | RESET_N | 4 | RESET_N | TRUE | Internal Pullup | Pull low to reset
5 | VDDCORE | 5 | VDDCORE | TRUE
6 | GND | 6 | GND | TRUE
7 | VDDOUT | 7 | VDDOUT | TRUE
8 | VDDIN | 8 | VDDIN | TRUE
9 | TCK | 9 | TCK | TRUE | TCK | None
10 | PA03 | 10 | PA03 | TRUE | TMS | None
11 | PB00 | 11 | PB00 | TRUE | IO Out
12 | PB01 | 12 | PB01 | TRUE | IO Out
13 | PB02 | 13 | PB02 | TRUE | IO Out
14 | PB03 | 14 | PB03 | TRUE | IO Out
15 | PA04 | 15 | PA04 | TRUE | ADC | AD0, Function A
16 | PA05 | 16 | PA05 | TRUE | ADC | AD1, Function A
17 | XIN32 | 17 | XIN32 | TRUE
18 | XOUT32 | 18 | XOUT32 | TRUE
19 | PB04 | 19 | PB04 | TRUE | IO Out
20 | PB05 | 20 | PB05 | TRUE | IO Out
21 | PA06 | 21 | PA06 | TRUE
22 | PA07 | 22 | PA07 | TRUE
23 | GNDANA | 23 | GNDANA | TRUE
24 | ADVREFP | 24 | ADVREFP | TRUE
25 | VDDANA | 25 | VDDANA | TRUE
26 | PA08 | 26 | PA08 | TRUE | PWM output | TC0 A0, Function B
27 | PB06 | 27 | PB06 | TRUE | IO Out
28 | PB07 | 28 | PB07 | TRUE | IO Out
29 | PA09 | 29 | PA09 | TRUE | IO Out
30 | PA10 | 30 | PA10 | TRUE | IO Out
31 | PA11 | 31 | PA11 | TRUE | IO Out
32 | PA12 | 32 | PA12 | TRUE | IO Out
33 | CAPH | 33 | CAPH | TRUE
34 | CAPL | 34 | CAPL | TRUE
35 | VLCD | 35 | VLCD | TRUE
36 | BIASH | 36 | BIASH | TRUE
37 | BIASL | 37 | BIASL | TRUE
38 | GND | 38 | GND | TRUE
39 | VLCDIN | 39 | VLCDIN | TRUE
40 | PA13 | 40 | PA13 | TRUE | IO Out
41 | PA14 | 41 | PA14 | TRUE | IO In | Enable interrupt
42 | PA15 | 42 | PA15 | TRUE | IO In | Enable interrupt
43 | PA16 | 43 | PA16 | TRUE | IO In | Enable interrupt
44 | PA17 | 44 | PA17 | TRUE | IO In | Enable interrupt
45 | PB08 | 45 | PB08 | TRUE | IO In | Enable interrupt
46 | PB09 | 46 | PB09 | TRUE | IO Out
47 | PB10 | 47 | PB10 | TRUE | Clock Out | GCLK0, Function E
48 | PB11 | 48 | PB11 | TRUE | Clock Out | GCLK1, Function E
49 | PA18 | 49 | PA18 | TRUE
50 | PA19 | 50 | PA19 | TRUE | IO Out
51 | PA20 | 51 | PA20 | TRUE | IO Out
52 | VDDIO | 52 | VDDIO | TRUE
53 | PB12 | 53 | PB12 | TRUE | Clock Out | GCLK2, Function E
54 | PB13 | 54 | PB13 | TRUE | Clock Out | GCLK3, Function E
55 | PA21 | 55 | PA21 | TRUE | SDA | TWD2, Function E
56 | PA22 | 56 | PA22 | TRUE | SCL | TWCK2, Function E
57 | PB14 | 57 | PB14 | TRUE | SDA | TWD3, Function C
58 | PB15 | 58 | PB15 | TRUE | SCL | TWCK3, Function C
59 | PA23 | 59 | PA23 | TRUE | TDO | None
60 | PA24 | 60 | PA24 | TRUE | TDI | None
61 | VDDIO | 61 | VDDIO | TRUE
62 | PA25 | 62 | PA25 | TRUE | IO Out
63 | PA26 | 63 | PA26 | TRUE
64 | GND | 64 | GND | TRUE
65 | GND | 65 | GND | TRUE

Sheet: RY2049B0-00
Pin Number | My Symbol | Pin Number2 | Data Sheet | Check
1 | LED+ | 1 | LED-K | FALSE
2 | LED- | 2 | LED- | TRUE
3 | GND | 3 | GND | TRUE
4 | VCC | 4 | VCC | TRUE
5 | IOVCC | 5 | IOVCC | TRUE
6 | NC | 6 | NC | TRUE
7 | CS | 7 | CS | TRUE
8 | RESET | 8 | RESET | TRUE
9 | RS | 9 | RS | TRUE
10 | WR | 10 | WR | TRUE
11 | RD | 11 | RD | TRUE
12 | DB7 | 12 | DB7 | TRUE
13 | DB6 | 13 | DB6 | TRUE
14 | DB5 | 14 | DB5 | TRUE
15 | DB4 | 15 | DB4 | TRUE
16 | DB3 | 16 | DB3 | TRUE
17 | DB2 | 17 | DB2 | TRUE
18 | DB1 | 18 | DB1 | TRUE
19 | DB0 | 19 | DB0 | TRUE
20 | GND | 20 | GND | TRUE
21 | NC | 21 | NC | TRUE
22 | NC | 22 | NC | TRUE
23 | NC | 23 | NC | TRUE
24 | NC | 24 | NC | TRUE

Sheet: AT24C04D
Pin Number | My Symbol | Pin Number2 | Data Sheet | Check
1 | NC | 1 | NC | TRUE
2 | A1 | 2 | A1 | TRUE
3 | A2 | 3 | A2 | TRUE
4 | GND | 4 | GND | TRUE
5 | SDA | 5 | SDA | TRUE
6 | SCL | 6 | SCL | TRUE
7 | WP | 7 | WP | TRUE
8 | VCC | 8 | VCC | TRUE

Sheet: ATUC128D3
Pin Number | My Symbol | Pin Number2 | Data Sheet | Check | Pin Function | Multiplexing
18 | ADVREF | 18 | ADVREF | TRUE
1 | GND | 1 | GND | TRUE
23 | GND | 23 | GND | TRUE
49 | GND | 49 | GND | TRUE
17 | GNDANA | 17 | GNDANA | TRUE
3 | PA00-TDI | 3 | PA00 | FALSE | JTAG
4 | PA01-TDO | 4 | PA01 | FALSE | JTAG
5 | PA02-TMS | 5 | PA02 | FALSE | JTAG
9 | PA03 | 9 | PA03 | TRUE
10 | PA04 | 10 | PA04 | TRUE
11 | PA05 | 11 | PA05 | TRUE | Analog In | ADCIN2, Function B
12 | PA06 | 12 | PA06 | TRUE | Analog In | ADCIN3, Function C
13 | PA07 | 13 | PA07 | TRUE
14 | PA08 | 14 | PA08 | TRUE
28 | PA09 | 28 | PA09 | TRUE | SCL | TWCK, Function A
29 | PA10 | 29 | PA10 | TRUE | SDA | TWD, Function A
30 | PA11 | 30 | PA11 | TRUE | PWM Out | TC A2, Function B or PMWA0, Function C
31 | PA12 | 31 | PA12 | TRUE | IO Out
33 | PA13 | 33 | PA13 | TRUE | IO Out
34 | PA14 | 34 | PA14 | TRUE | IO Out
35 | PA15 | 35 | PA15 | TRUE | IO Out
36 | PA16 | 36 | PA16 | TRUE | IO Out
37 | PA17 | 37 | PA17 | TRUE
39 | PA18-XIN | 39 | PA18 | FALSE
40 | PA19-XOUT | 40 | PA19 | FALSE
44 | PA20 | 44 | PA20 | TRUE
45 | PA21 | 45 | PA21 | TRUE | IO In
46 | PA22 | 46 | PA22 | TRUE | IO In
47 | PA23 | 47 | PA23 | TRUE | IO In
59 | PA24 | 59 | PA24 | TRUE | IO In
60 | PA25 | 60 | PA25 | TRUE | IO In
61 | PA26 | 61 | PA26 | TRUE
62 | PA27 | 62 | PA27 | TRUE
41 | PA28 | 41 | PA28 | TRUE
42 | PA29 | 42 | PA29 | TRUE
15 | PA30 | 15 | PA30 | TRUE | GLCK0 Out | GCLK2, Function C
16 | PA31 | 16 | PA31 | TRUE
6 | PB00 | 6 | PB00 | TRUE | IO Out
7 | PB01 | 7 | PB01 | TRUE | IO Out
24 | PB02 | 24 | PB02 | TRUE | IO Out
25 | PB03 | 25 | PB03 | TRUE | IO Out
26 | PB04 | 26 | PB04 | TRUE | IO Out
27 | PB05 | 27 | PB05 | TRUE | IO Out
38 | PB06 | 38 | PB06 | TRUE | IO Out
43 | PB07 | 43 | PB07 | TRUE | IO Out
54 | PB08 | 54 | PB08 | TRUE
55 | PB09 | 55 | PB09 | TRUE | IO Out
57 | PB10 | 57 | PB10 | TRUE | IO Out
58 | PB11 | 58 | PB11 | TRUE | IO Out
2 | PB12-TCK | 2 | PB12 | FALSE | JTAG
8 | PB13 | 8 | PB13 | TRUE
50 | PB14-DP | 50 | PB14-DP | TRUE
51 | PB15-DM | 51 | PB15-DM | TRUE
52 | PB16-VBUS | 52 | PB16-VBUS | TRUE
53 | PB17 | 53 | PB17 | TRUE
56 | PB18 | 56 | PB18 | TRUE
63 | RESET_N | 63 | RESET_N | TRUE | JTAG | Internal Pullup
19 | VDDANA | 19 | VDDANA | TRUE
22 | VDDCORE | 22 | VDDCORE | TRUE
21 | VDDIN | 21 | VDDIN | TRUE
32 | VDDIO | 32 | VDDIO | TRUE
48 | VDDIO | 48 | VDDIO | TRUE
64 | VDDIO | 64 | VDDIO | TRUE
20 | VDDOUT | 20 | VDDOUT | TRUE
