alexjegers/DAMPING_ADJUSTER/Stepper Motor Controller/Testing and Other/ADC Measurements/ADC Measurements.xlsx

Sheet: CLK_DIV = 2
Power Supply Voltage | Voltage Divider Output | ADC Result (Hex) | ADC Result (Dec)
10 | 1.427 | 08FF | 2303
10.5 | 1.493 | 097F | 2431
11 | 1.565 | 09EF | 2543
11.5 | 1.64 | 09FF | 2559
12 | 1.714 | 0AE7 | 2791
12.5 | 1.786 | 0B5E | 2910
13 | 1.858 | 0BCE | 3022
13.5 | 1.927 | 0BFF | 3071
14 | 1.999 | 0BFF | 3071
14.5 | 2.07 | 0CFF | 3327
15 | 2.141 | 0D7F | 3455
15.5 | 2.209 | 0DFF | 3583

Sheet: CLK_DIV = 256
Power Supply Voltage | Voltage Divider Output | ADC Result (Hex) | ADC Result (Dec)
10 | 1.426 | 923 | 2339
10.5 | 1.497 | 999 | 2457
11 | 1.568 | 0A0E | 2574
11.5 | 1.64 | 0A83 | 2691
12 | 1.711 | 0AF7 | 2807
12.5 | 1.782 | 0B6D | 2925
13 | 1.854 | 0BE2 | 3042
13.5 | 1.925 | 0C57 | 3159
14 | 1.996 | 0CCC | 3276
14.5 | 2.068 | 0D41 | 3393
15 | 2.139 | 0DB6 | 3510
15.5 | 2.21 | 0E2A | 3626
