alexjegers/DAMPING_ADJUSTER/Stepper Motor Controller/Testing and Other/Pinout Verification/Pinout Verification.xlsx

Sheet: AVR32DA32
Pin Number | My Symbol | Pin Number2 | Data Sheet | Check
1 | PA3 | 1 | PA3 | TRUE
2 | PA4 | 2 | PA4 | TRUE
3 | PA5 | 3 | PA5 | TRUE
4 | PA6 | 4 | PA6 | TRUE
5 | PA7 | 5 | PA7 | TRUE
6 | PC0 | 6 | PC0 | TRUE
7 | PC1 | 7 | PC1 | TRUE
8 | PC2 | 8 | PC2 | TRUE
9 | PC3 | 9 | PC3 | TRUE
10 | PD0 | 10 | PD0 | TRUE
11 | PD1 | 11 | PD1 | TRUE
12 | PD2 | 12 | PD2 | TRUE
13 | PD3 | 13 | PD3 | TRUE
14 | PD4 | 14 | PD4 | TRUE
15 | PD5 | 15 | PD5 | TRUE
16 | PD6 | 16 | PD6 | TRUE
17 | PD7 | 17 | PD7 | TRUE
18 | AVDD | 18 | AVDD | TRUE
19 | GND | 19 | GND | TRUE
20 | PF0 | 20 | PF0 | TRUE
21 | PF1 | 21 | PF1 | TRUE
22 | PF2 | 22 | PF2 | TRUE
23 | PF3 | 23 | PF3 | TRUE
24 | PF4 | 24 | PF4 | TRUE
25 | PF5 | 25 | PF5 | TRUE
26 | PF6 | 26 | PF6 | TRUE
27 | UPDI | 27 | UPDI | TRUE
28 | VDD | 28 | VDD | TRUE
29 | GND | 29 | GND | TRUE
30 | PA0 | 30 | PA0 | TRUE
31 | PA1 | 31 | PA1 | TRUE
32 | PA2 | 32 | PA2 | TRUE
33 | GND | 33 | GND | TRUE

Sheet: DRV8825
Pin Number | My Symbol | Pin Number2 | Data Sheet | Check
1 | CP1 | 1 | CP1 | TRUE
2 | CP2 | 2 | CP2 | TRUE
3 | VCP | 3 | VCP | TRUE
4 | VMA | 4 | VMA | TRUE
5 | AOUT1 | 5 | AOUT1 | TRUE
6 | ISENA | 6 | ISENA | TRUE
7 | AOUT2 | 7 | AOUT2 | TRUE
8 | BOUT2 | 8 | BOUT2 | TRUE
9 | ISENB | 9 | ISENB | TRUE
10 | BOUT1 | 10 | BOUT1 | TRUE
11 | VMB | 11 | VMB | TRUE
12 | AVREF | 12 | AVREF | TRUE
13 | BVREF | 13 | BVREF | TRUE
14 | GND | 14 | GND | TRUE
15 | V3P3OUT | 15 | V3P3OUT | TRUE
16 | nRESET | 16 | nRESET | TRUE
17 | nSLEEP | 17 | nSLEEP | TRUE
18 | nFAULT | 18 | nFAULT | TRUE
19 | DECAY | 19 | DECAY | TRUE
20 | DIR | 20 | DIR | TRUE
21 | nENBLE | 21 | nENBLE | TRUE
22 | STEP | 22 | STEP | TRUE
23 | NC | 23 | NC | TRUE
24 | MODE0 | 24 | MODE0 | TRUE
25 | MODE1 | 25 | MODE1 | TRUE
26 | MODE2 | 26 | MODE2 | TRUE
27 | nHOME | 27 | nHOME | TRUE
28 | GND | 28 | GND | TRUE
29 | GND | 29 | GND | TRUE
30 |  | 30 |  | TRUE
31 |  | 31 |  | TRUE
32 |  | 32 |  | TRUE
33 |  | 33 |  | TRUE

Sheet: SN74LVC
Pin Number | My Symbol | Pin Number2 | Data Sheet | Check
1 | 1A | 1 | 1A | TRUE
2 | GND | 2 | GND | TRUE
3 | 2A | 3 | 2A | TRUE
4 | 2Y | 4 | 2Y | TRUE
5 | VCC | 5 | VCC | TRUE
6 | 1Y | 6 | 1Y | TRUE
7 |  | 7 |  | TRUE
8 |  | 8 |  | TRUE
9 |  | 9 |  | TRUE
10 |  | 10 |  | TRUE
11 |  | 11 |  | TRUE
12 |  | 12 |  | TRUE
13 |  | 13 |  | TRUE
14 |  | 14 |  | TRUE
15 |  | 15 |  | TRUE
16 |  | 16 |  | TRUE
17 |  | 17 |  | TRUE
18 |  | 18 |  | TRUE
19 |  | 19 |  | TRUE
20 |  | 20 |  | TRUE
21 |  | 21 |  | TRUE
22 |  | 22 |  | TRUE
23 |  | 23 |  | TRUE
24 |  | 24 |  | TRUE
25 |  | 25 |  | TRUE
26 |  | 26 |  | TRUE
27 |  | 27 |  | TRUE
28 |  | 28 |  | TRUE
29 |  | 29 |  | TRUE
30 |  | 30 |  | TRUE
31 |  | 31 |  | TRUE
32 |  | 32 |  | TRUE
33 |  | 33 |  | TRUE
