alexjegers/DAMPING_ADJUSTER/Controller/Testing and Other/LCD Data Bus Transition Times/LCD Data Bus Transition Times.docx

Abbreviation | Datasheet | Description | Time
T_ast | Address setup time | Time between D/C line change and WR or RD fall | 4.83us
T_aht | Address hold time | Time between WR or RD rise and D/C change | 10us
T_chw | Chip select H pulse width | Time CS is high between transfers
T_cs | Chip select setup time | Time that CS is low before WR or RD comes high | 120us
T_rcs | Chip select setup time (read ID)
T_rcs | Chip select setup time (read FM)
T_csf | Chip select wait time | Time from CS rise to WR fall? | NA
T_csh | Chip select hold time | Time from WR rise to CS rise. | 10us
T_wc | Write cycle | Time from WR fall to WR fall | 19us
T_wrh | Control pulse high duration | Time that WR is high | 7us
T_wrl | Control pulse low duration | Time that WR is low | 12us
T_rc (ID) | Read cycle (ID)
T_rdh (ID) | Control pulse high duration (ID)
T_rdl (ID) | Control pulse low duration (ID)
T_dst | Data setup time | Time that data is on the bus before WR goes high | 2.5us
T_dht | Data hold time | Time from WR going high to data changing. | 14us
T_odh | Output disable time. | Unknown

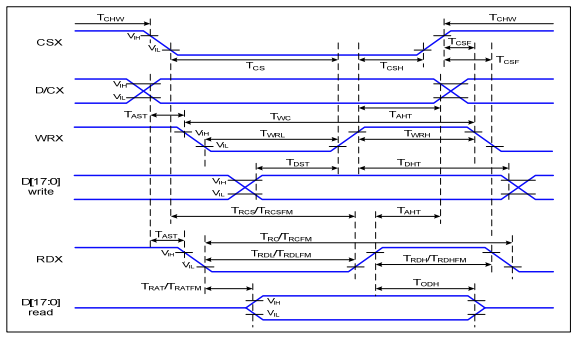
[picture p104: figure]
