alexjegers/DAMPING_ADJUSTER/Stepper Motor Controller/Testing and Other/Current Sense Loop/DAC output and Isense calculations.xlsx

Vref | Isense | DAC Value | Power Loss | Rsense: | 0.1
0 | 0.00 | 0.00 | 0.000
0.01 | 0.03 | 5.28 | 0.003
0.03 | 0.05 | 10.61 | 0.005
0.04 | 0.08 | 15.89 | 0.008
0.05 | 0.10 | 21.20 | 0.010
0.06 | 0.13 | 26.50 | 0.013
0.08 | 0.16 | 31.80 | 0.016
0.09 | 0.18 | 37.11 | 0.018
0.10 | 0.21 | 42.41 | 0.021
0.12 | 0.23 | 47.71 | 0.023
0.13 | 0.26 | 53.02 | 0.026
0.14 | 0.28 | 58.32 | 0.028
0.16 | 0.31 | 63.62 | 0.031
0.17 | 0.34 | 68.93 | 0.034
0.18 | 0.36 | 74.23 | 0.036
0.19 | 0.39 | 79.53 | 0.039
0.21 | 0.41 | 84.83 | 0.041
0.22 | 0.44 | 90.14 | 0.044
0.23 | 0.47 | 95.44 | 0.047
0.25 | 0.49 | 100.74 | 0.049
0.26 | 0.52 | 106.05 | 0.052
0.27 | 0.54 | 111.35 | 0.054
0.28 | 0.57 | 116.65 | 0.057
0.30 | 0.60 | 121.96 | 0.060
0.31 | 0.62 | 127.26 | 0.062
0.32 | 0.65 | 132.56 | 0.065
0.34 | 0.67 | 137.87 | 0.067
0.35 | 0.70 | 143.17 | 0.070
0.36 | 0.73 | 148.47 | 0.073
0.38 | 0.75 | 153.77 | 0.075
0.39 | 0.78 | 159.08 | 0.078
0.40 | 0.80 | 164.38 | 0.080
0.41 | 0.83 | 169.68 | 0.083
0.43 | 0.85 | 174.99 | 0.085
0.44 | 0.88 | 180.29 | 0.088
0.45 | 0.91 | 185.59 | 0.091
0.47 | 0.93 | 190.90 | 0.093
0.48 | 0.96 | 196.20 | 0.096
0.49 | 0.98 | 201.50 | 0.098
0.51 | 1.01 | 206.80 | 0.101
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
