alexjegers/DAMPING_ADJUSTER/Controller/Testing and Other/Graphics/Damping Adjuster Menu.png

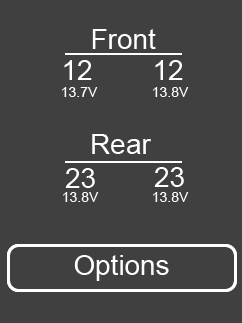
Controller/Testing and Other/Graphics/Damping Adjuster Menu.png
