alexjegers/DAMPING_ADJUSTER/Stepper Motor Controller/Testing and Other/ADC Input Impedance/ADC Datasheet.PNG

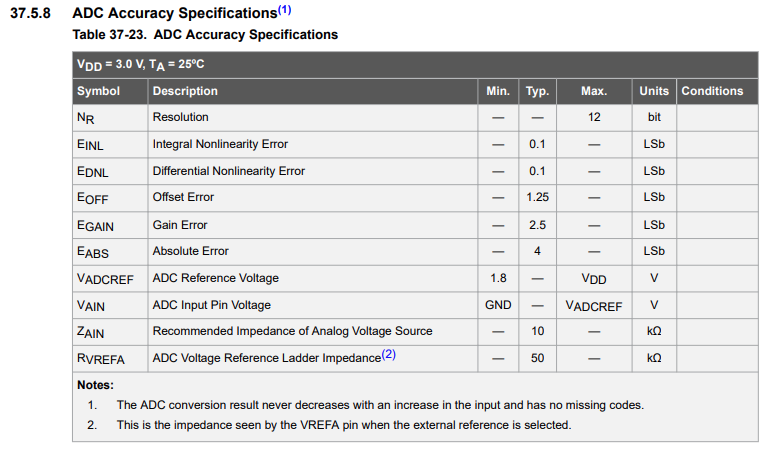
Stepper Motor Controller/Testing and Other/ADC Input Impedance/ADC Datasheet.PNG
