alexjegers/DAMPING_ADJUSTER/Stepper Motor Controller/Testing and Other/ADC Measurements/Measurements Graph 12MHz.png

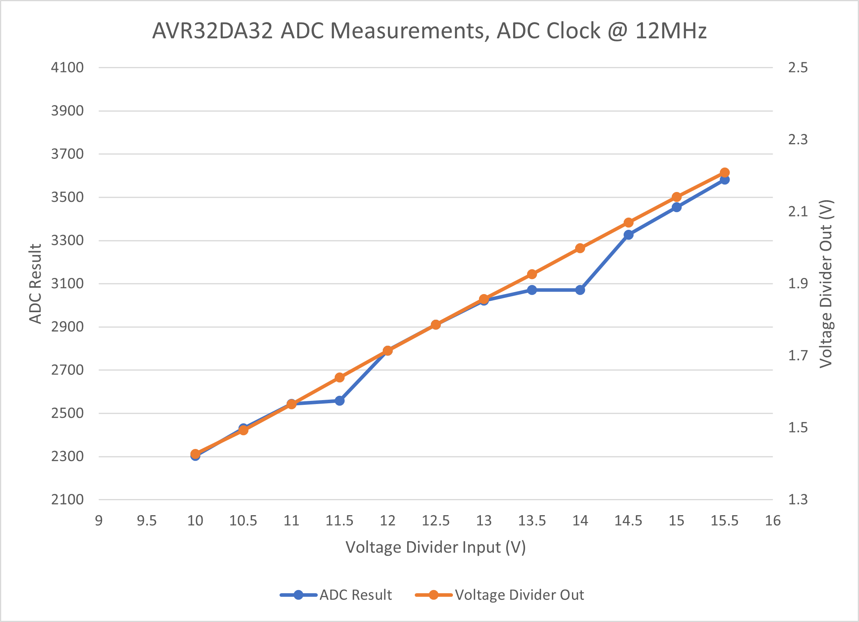
Stepper Motor Controller/Testing and Other/ADC Measurements/Measurements Graph 12MHz.png
