alexjegers/DAMPING_ADJUSTER/Stepper Motor Controller/Testing and Other/ADC Measurements/Measurements Graph.png

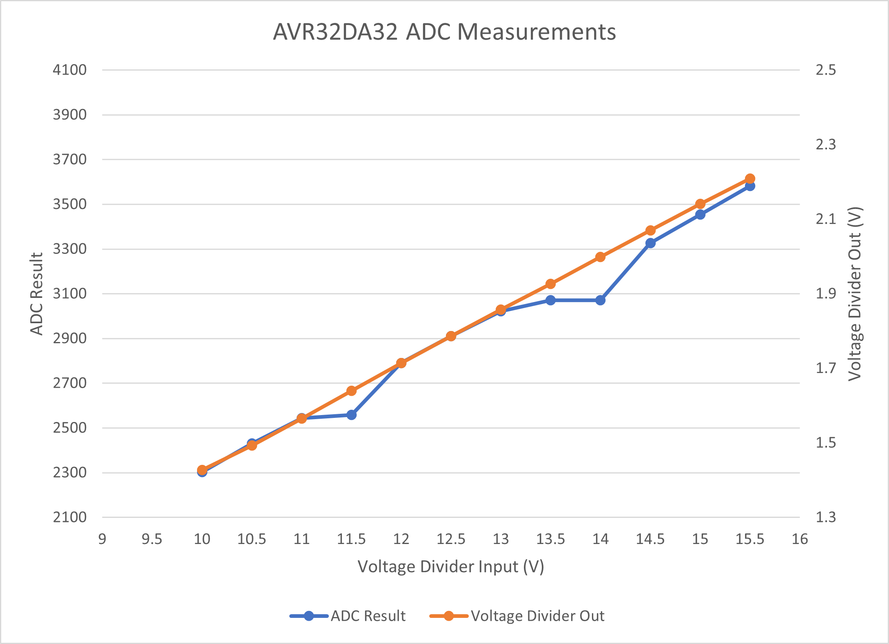
Stepper Motor Controller/Testing and Other/ADC Measurements/Measurements Graph.png
