alexjegers/DAMPING_ADJUSTER/Stepper Motor Controller/Testing and Other/ADC Measurements/PCB Trace.PNG

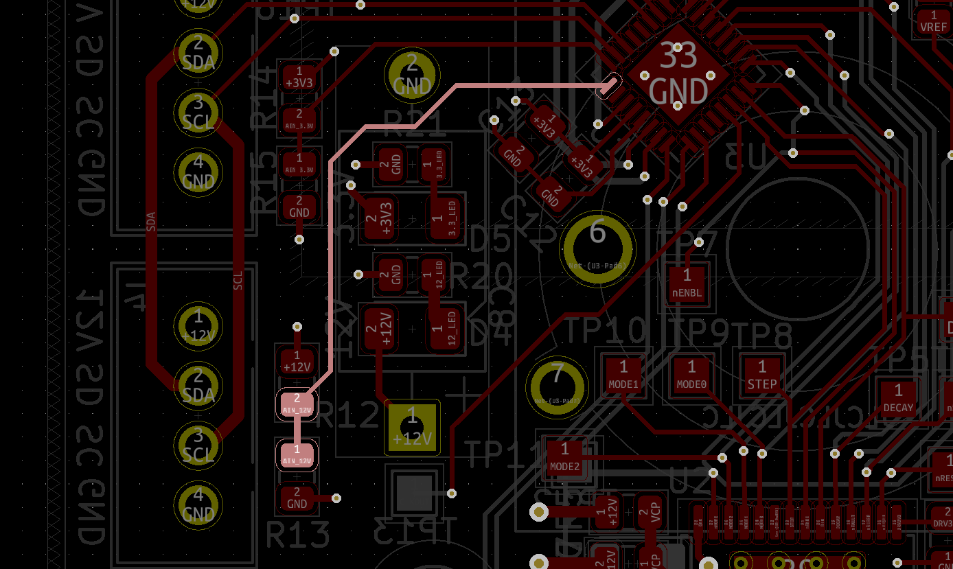
Stepper Motor Controller/Testing and Other/ADC Measurements/PCB Trace.PNG
