alexjegers/DAMPING_ADJUSTER/Stepper Motor Controller/Testing and Other/Encoder Scope Shots/Forcibly stopped while rotating at 100RPM_2.PNG

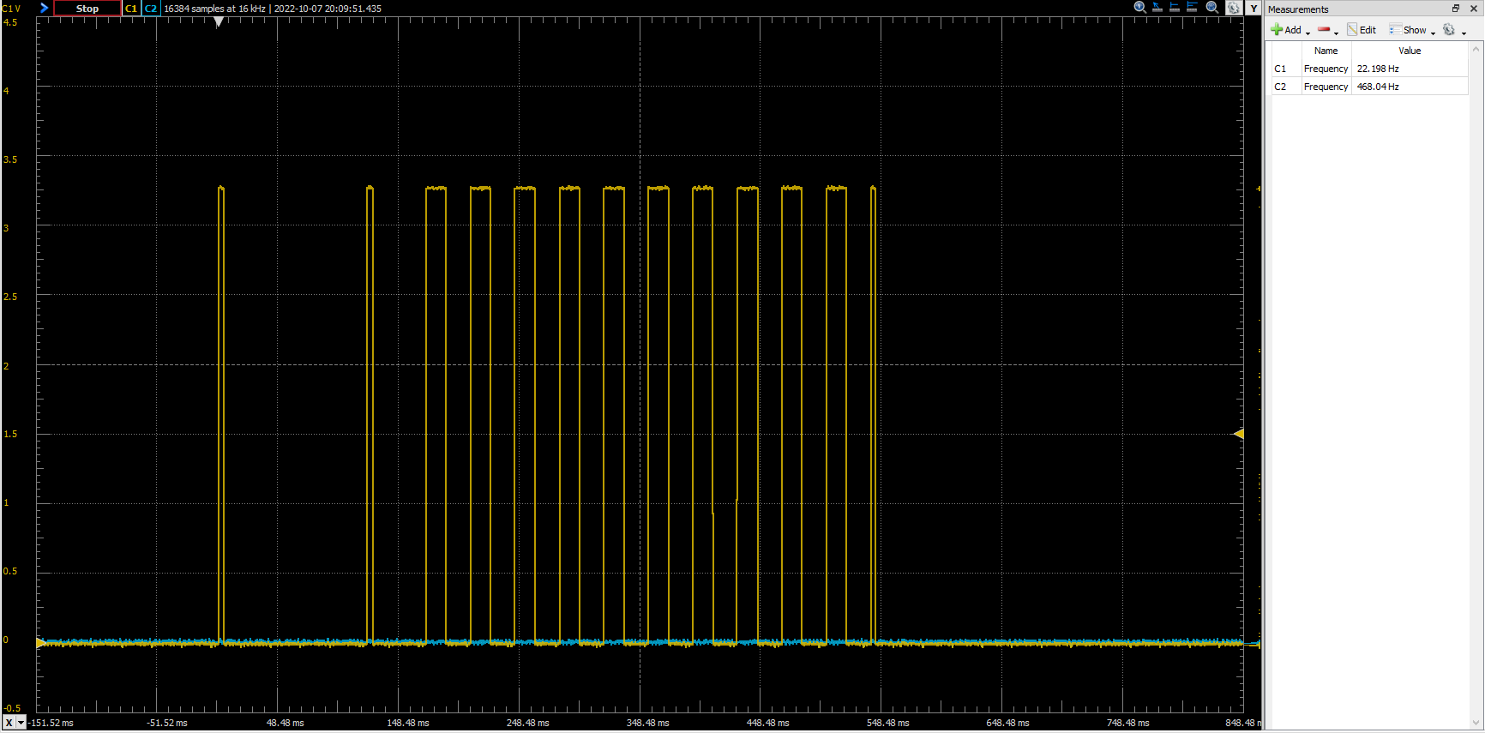
Stepper Motor Controller/Testing and Other/Encoder Scope Shots/Forcibly stopped while rotating at 100RPM_2.PNG
