alexjegers/DAMPING_ADJUSTER/Controller/Testing and Other/ST7789  Address Set Bug/IMG_5340.JPG

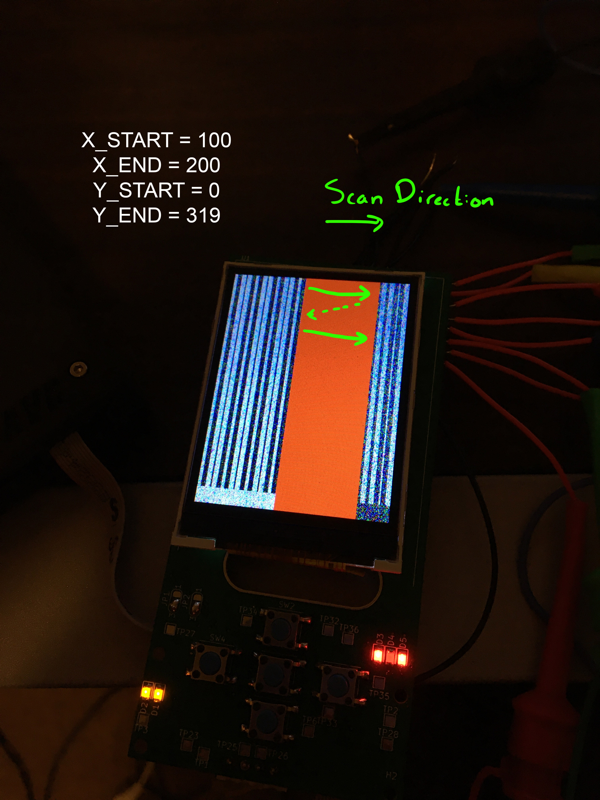
Controller/Testing and Other/ST7789 Address Set Bug/IMG_5340.JPG
