alexjegers/DAMPING_ADJUSTER/Controller/Testing and Other/ST7789  Address Set Bug/Writing 0x2B.JPG

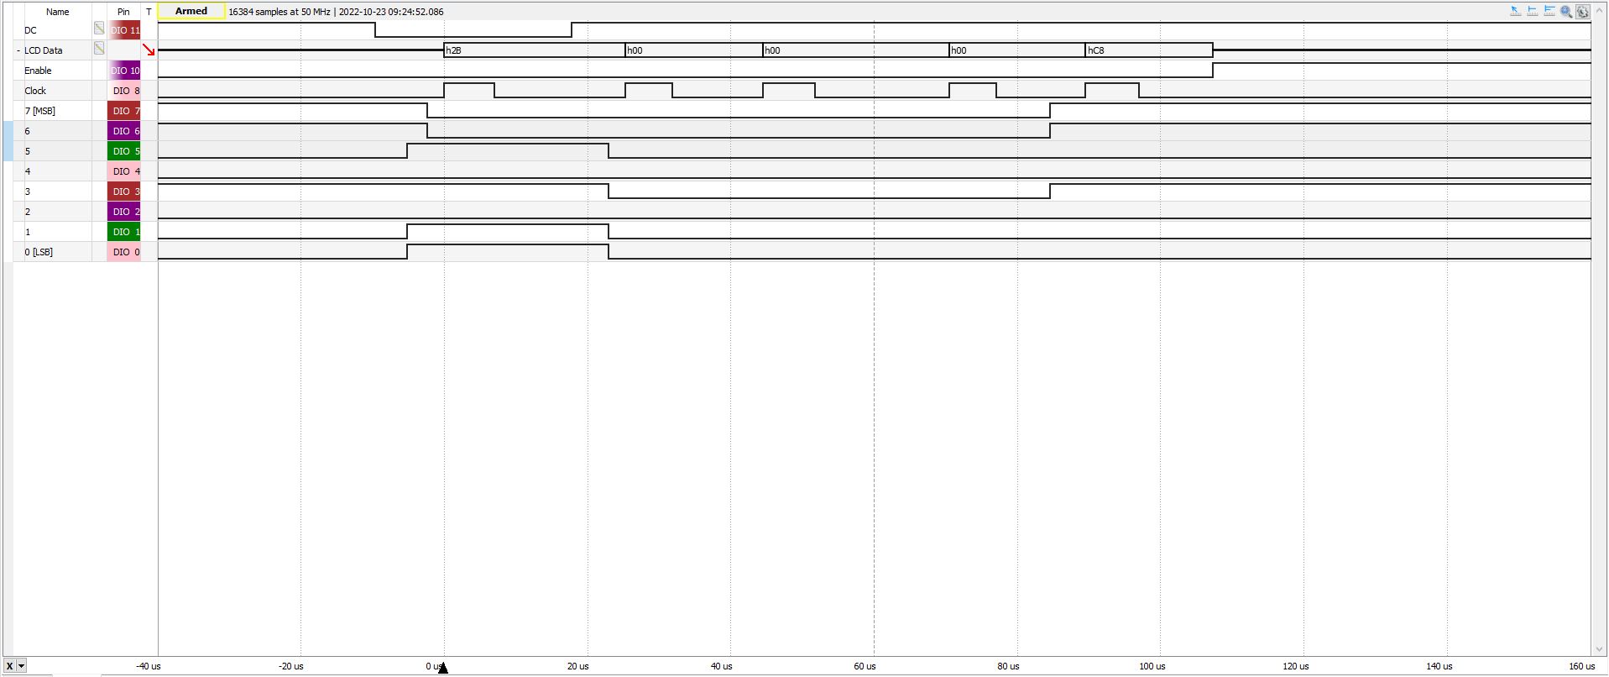
Controller/Testing and Other/ST7789 Address Set Bug/Writing 0x2B.JPG
