alexjegers/DAMPING_ADJUSTER/Stepper Motor Controller/Electrical/Stepper_Motor_Controller.pdf

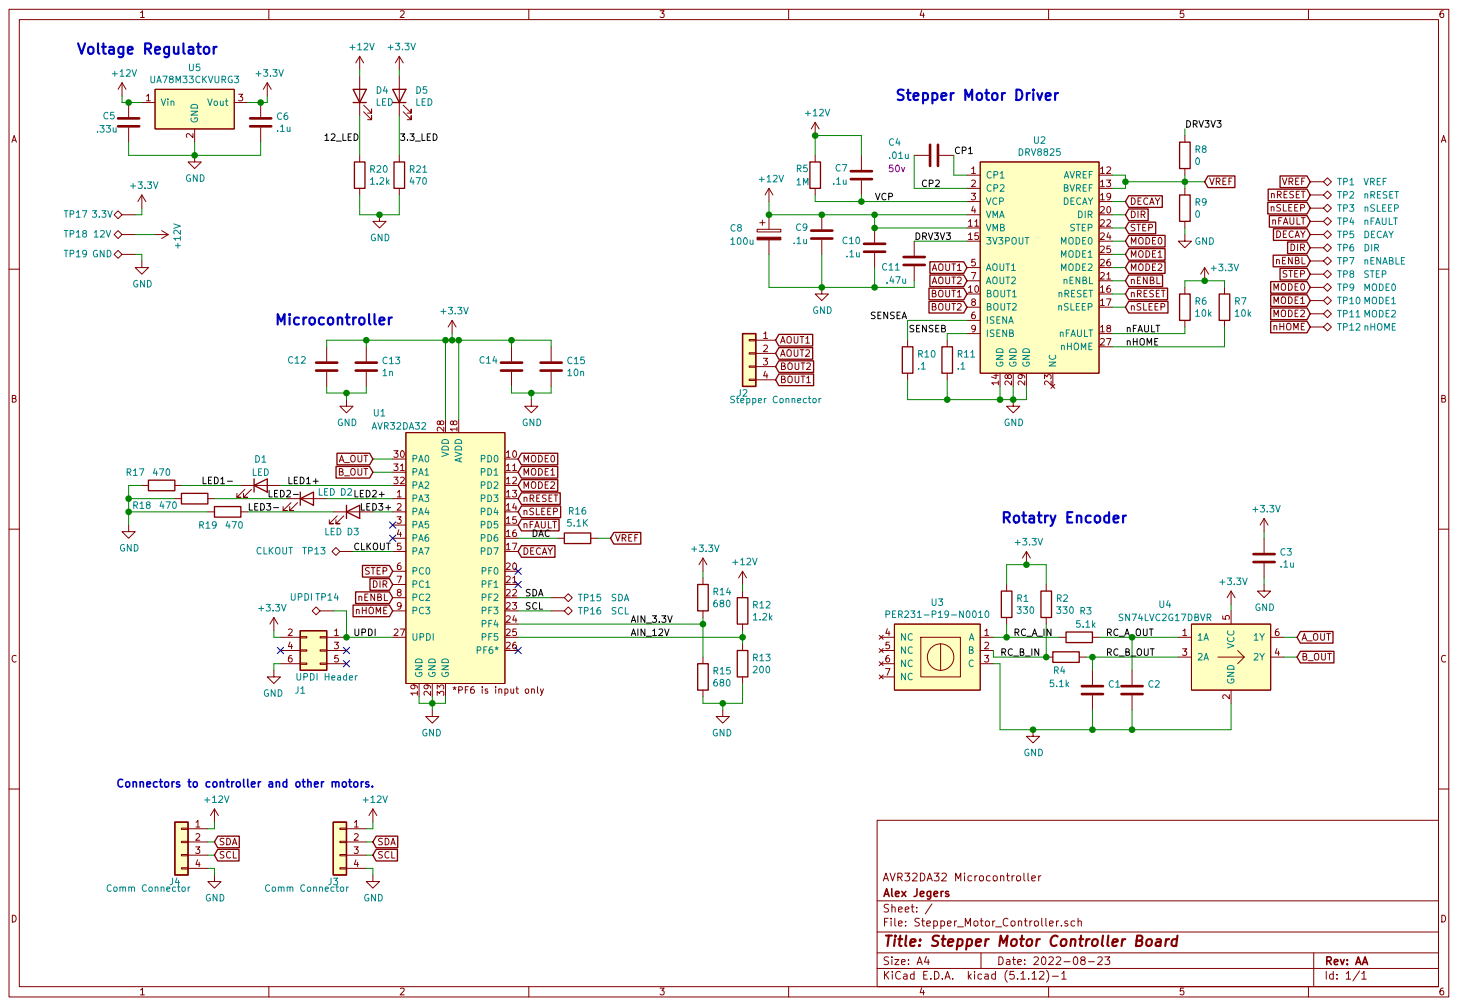
[picture p117: page 1]

LED D2 R18 470
Rotatry Encoder Connectors to controller and other motors.
LED D3 R19 470 GND

File: Stepper_Motor_Controller.sch Sheet: / Alex Jegers AVR32DA32 Microcontroller

Id: 1/1 Title: Stepper Motor Controller Board
