alexjegers/DAMPING_ADJUSTER/Controller/Electrical/Controller_Board_AC/Controller_Borad.pdf

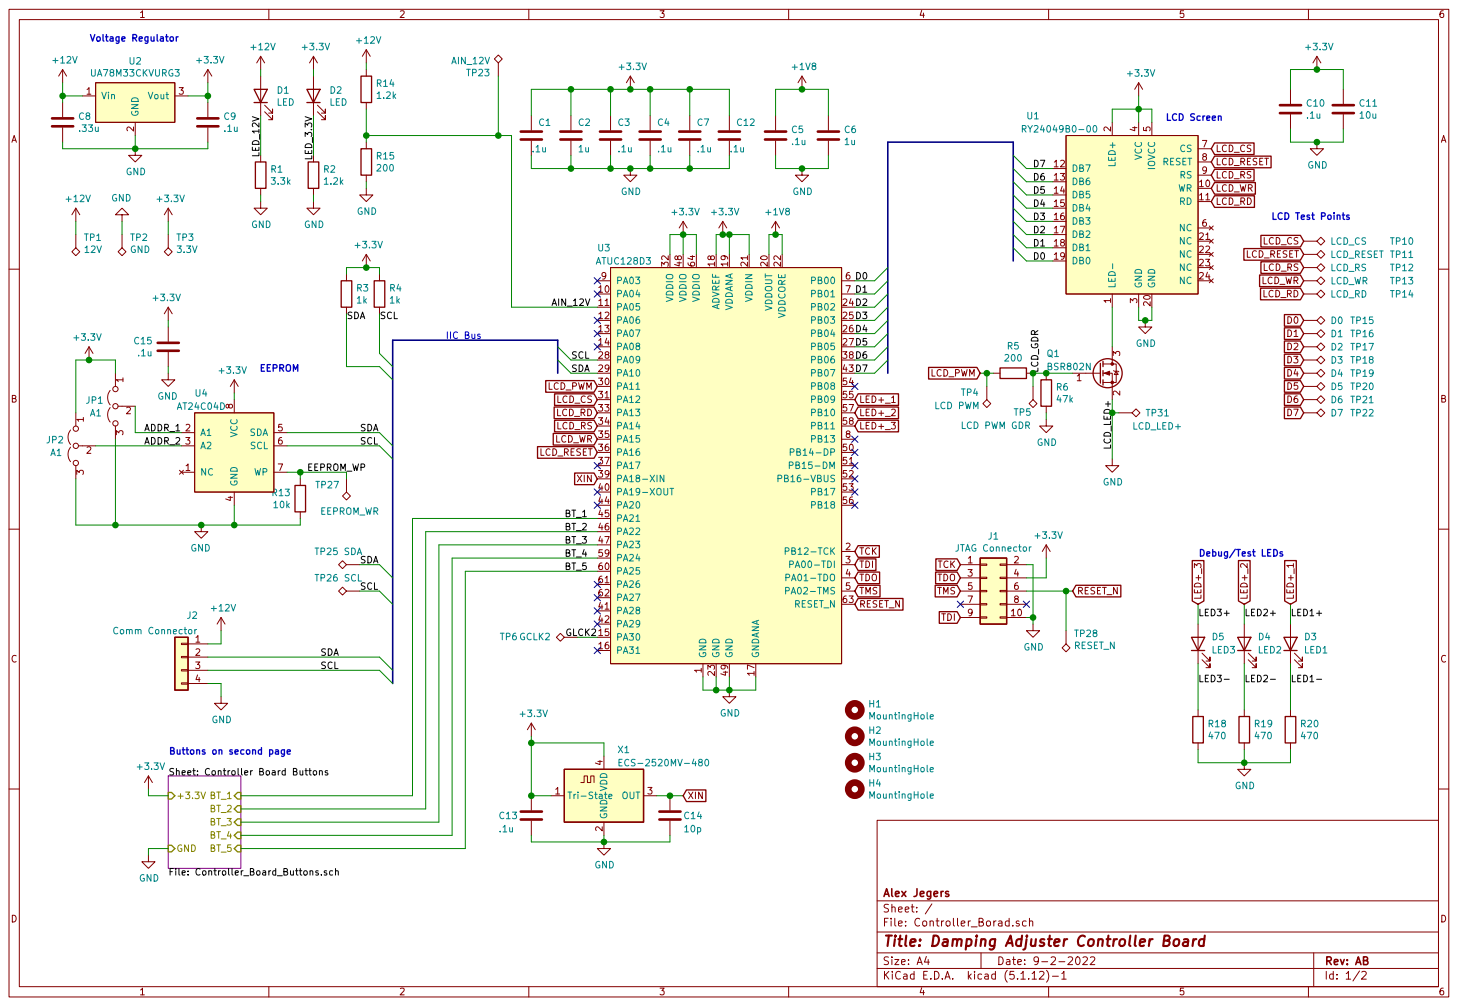
[picture p118: page 1]

LCD Test Points Voltage Regulator

5 NC 6 CS 7 RESET 8 RS 9 U1RY24049B0-00 NC 1 A1 2 A2 3 GND

2 GND 20 NC 21 NC 22 NC 23 NC 24 GND

1 PA04 10 PB12-TCK 2 PA00-TDI 3 PA01-TDO 4 PA02-TMS 5 PB00 6 PB01 7 PB13 8 PA03 9U3 ATUC128D3 LED- 1 WR 10 RD 11 DB7 12 DB6 13 DB5 14 DB4 15 DB3 16 DB2 17 DB1 18 DB0 19 LED+

4 SDA 5 SCL 6 WP 7 VCC

Buttons on second page
+3.3V GND
File: Controller_Borad.sch Sheet: / Alex Jegers Sheet: Controller Board Buttons File: Controller_Board_Buttons.sch BT_1 BT_2 BT_3 BT_4 BT_5 +3.3V GND

Id: 1/2 Title: Damping Adjuster Controller Board

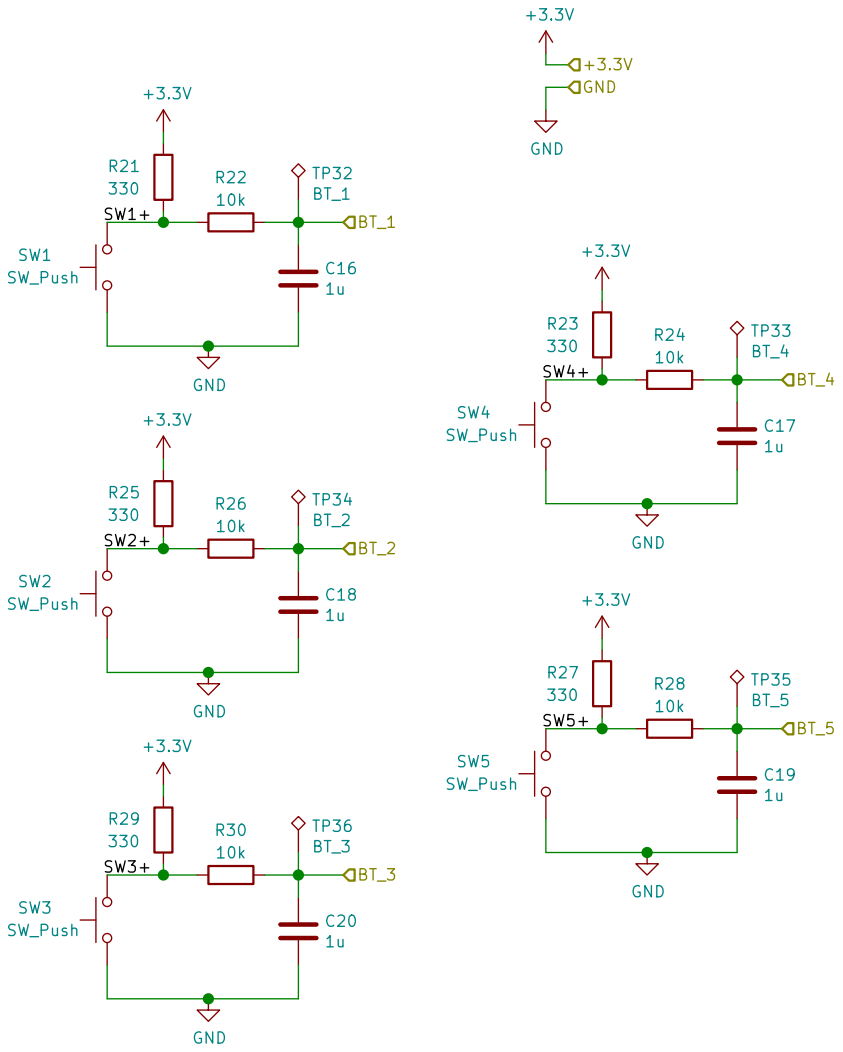
[picture p119: page 2]

File: Controller_Board_Buttons.sch Sheet: /Controller Board Buttons/ C19

Id: 2/2 Title: Damping Adjuster Controller Board
