alexjegers/DAMPING_ADJUSTER/Controller/Electrical/Controller_Board_AB/Controller_Borad.kicad_pcb

## KiCad design Controller/Electrical/Controller_Board_AB/Controller_Borad.kicad_pcb (2022-11-11)

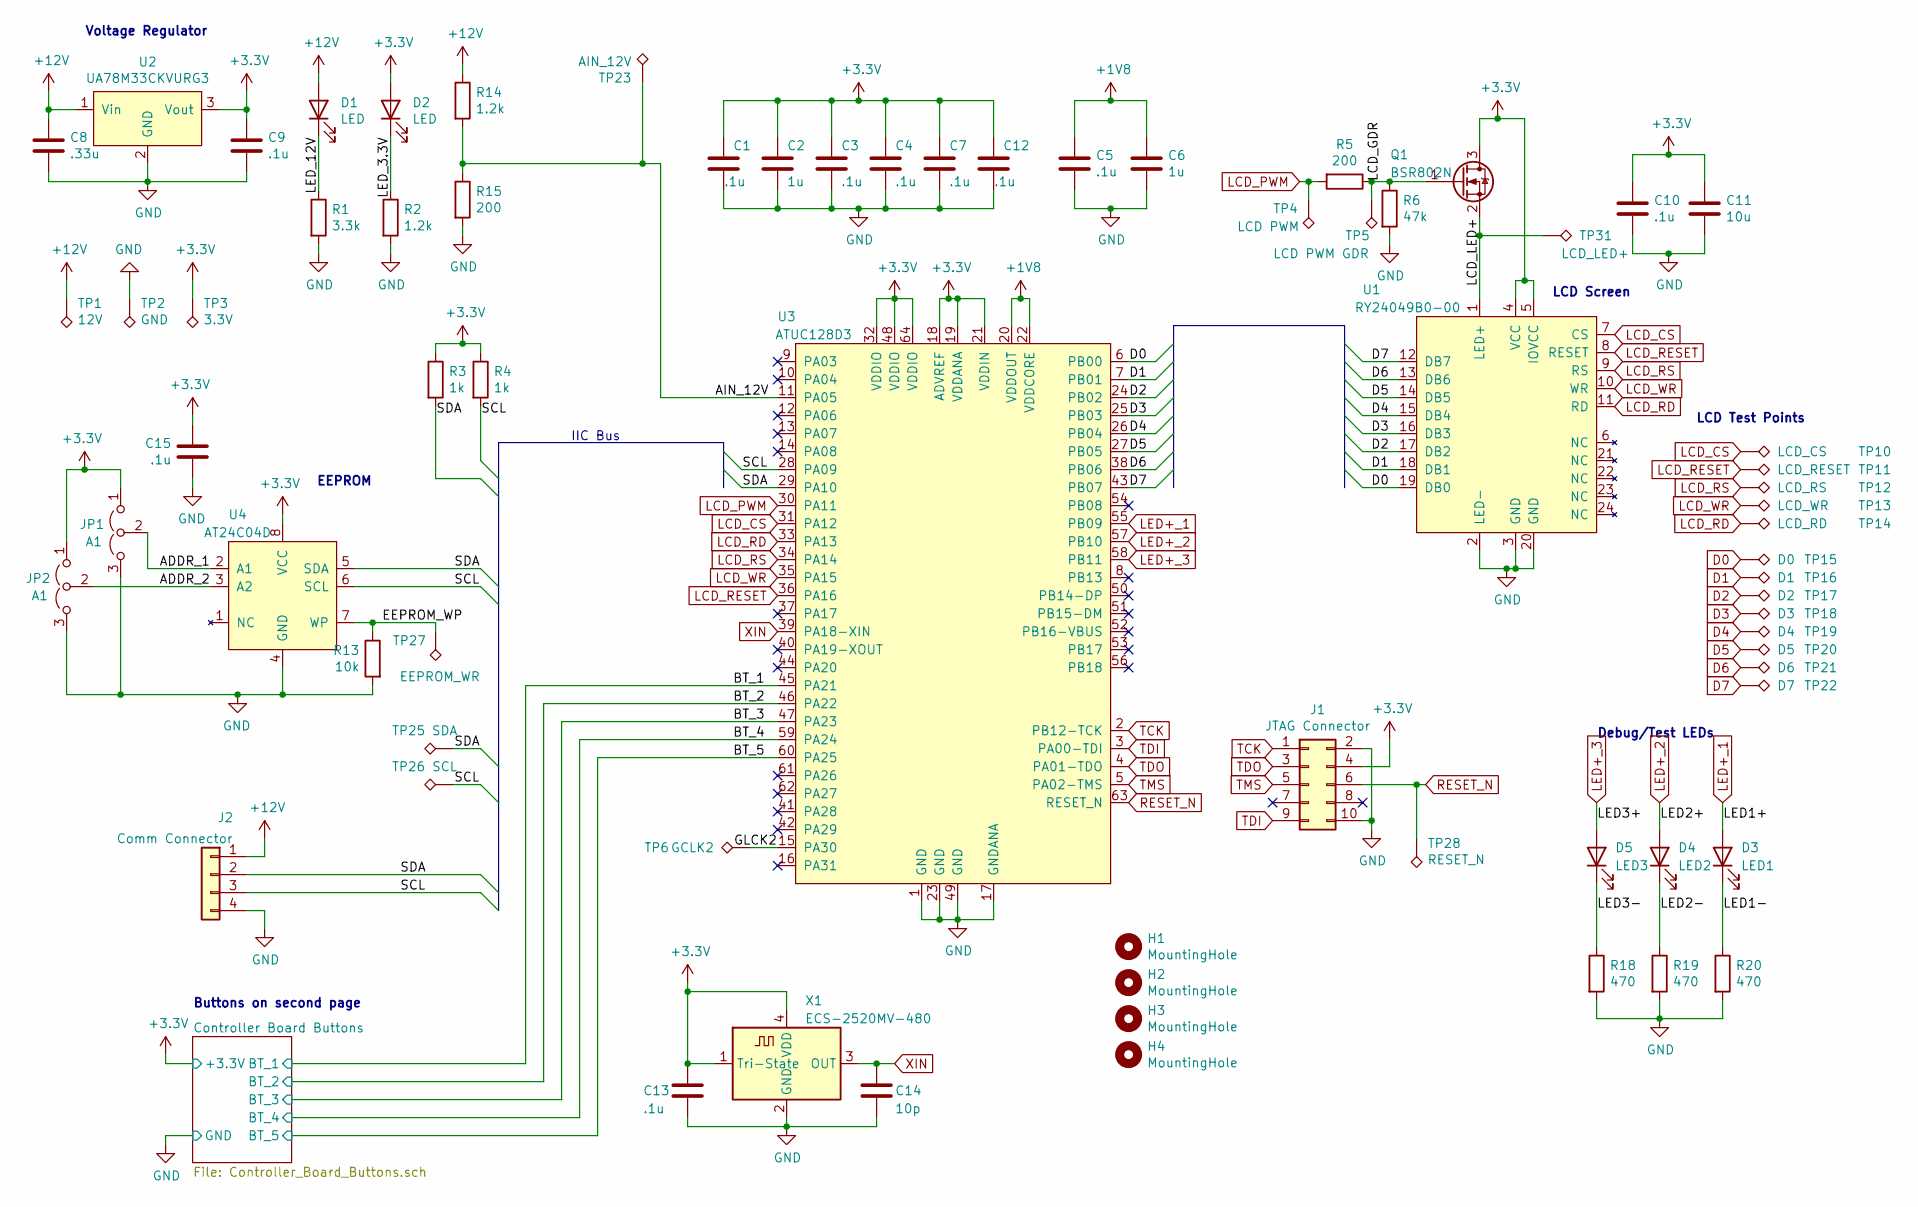
[picture p120: schematic Controller_Borad.sch, Damping Adjuster Controller Board]

Parts:
C1, C3, C4, C5, C7, C9, C10, C12, C13, C15: .1u; C_0805_2012Metric
C2, C6: 1u; C_0805_2012Metric
C8: .33u; C_0805_2012Metric
C11: 10u; C_0805_2012Metric
C14: 10p; C_0805_2012Metric
D1, D2: LED; LED_0805_2012Metric
D3: LED1; LED_0805_2012Metric
D4: LED2; LED_0805_2012Metric
D5: LED3; LED_0805_2012Metric
H1, H2, H3, H4: MountingHole; MountingHole_2.2mm_M2
J1: JTAG Connector; PinHeader_2x05_P1.27mm_Vertical_SMD
J2: Comm Connector; 1005-003
JP1, JP2: A1; SolderJumper-3_P1.3mm_Open_RoundedPad1.0x1.5mm_NumberLabels
Q1: BSR802N; SOT-23
R1: 3.3k; R_0805_2012Metric
R2, R14: 1.2k; R_0805_2012Metric
R3, R4: 1k; R_0805_2012Metric
R5, R15: 200; R_0805_2012Metric
R6: 47k; R_0805_2012Metric
R13: 10k; R_0805_2012Metric
R18, R19, R20: 470; R_0805_2012Metric
TP1: 12V; TestPoint_Pad_1.5x1.5mm
TP2: GND; TestPoint_Pad_1.5x1.5mm
TP3: 3.3V; TestPoint_Pad_1.5x1.5mm
TP4: LCD PWM; TestPoint_Pad_1.5x1.5mm
TP5: LCD PWM GDR; TestPoint_Pad_1.5x1.5mm
TP6: GCLK2; TestPoint_Pad_1.5x1.5mm
TP10: LCD_CS; TestPoint_Pad_1.5x1.5mm
TP11: LCD_RESET; TestPoint_Pad_1.5x1.5mm
TP12: LCD_RS; TestPoint_Pad_1.5x1.5mm
TP13: LCD_WR; TestPoint_Pad_1.5x1.5mm
TP14: LCD_RD; TestPoint_Pad_1.5x1.5mm
TP15: D0; TestPoint_Pad_1.5x1.5mm
TP16: D1; TestPoint_Pad_1.5x1.5mm
TP17: D2; TestPoint_Pad_1.5x1.5mm
TP18: D3; TestPoint_Pad_1.5x1.5mm
TP19: D4; TestPoint_Pad_1.5x1.5mm
TP20: D5; TestPoint_Pad_1.5x1.5mm
TP21: D6; TestPoint_Pad_1.5x1.5mm
TP22: D7; TestPoint_Pad_1.5x1.5mm
TP23: AIN_12V; TestPoint_Pad_1.5x1.5mm
TP25: SDA; TestPoint_Pad_1.5x1.5mm
TP26: SCL; TestPoint_Pad_1.5x1.5mm
TP27: EEPROM_WR; TestPoint_Pad_1.5x1.5mm
TP28: RESET_N; TestPoint_Pad_1.5x1.5mm
TP31: LCD_LED+; TestPoint_Pad_1.5x1.5mm
U1: RY24049B0-00
U2: UA78M33CKVURG3; TO-252-2; Mfg Part # 296-21208-1-ND
U3: ATUC128D3; TQFP-64_10x10mm_P0.5mm
U4: AT24C04D; TSSOP-8_4.4x3mm_P0.65mm
X1: ECS-2520MV-480; Oscillator_SMD_ECS_2520MV-xxx-xx-4Pin_2.5x2.0mm

Connections:
+1V8: C5.1, C6.1, U3.20 (VDDOUT), U3.22 (VDDCORE)
+3V3: C1.1, C2.1, C3.1, C4.1, C7.1, C9.1, C10.1, C11.1, C12.1, C13.1, C15.1, D2.2 (A), J1.4, JP1.1 (A), JP2.1 (A), Q1.3 (D), R3.1, R4.1, TP3.1, U1.4 (VCC), U1.5 (IOVCC), U2.3 (Vout), U3.18 (ADVREF), U3.19 (VDDANA), U3.21 (VDDIN), U3.32 (VDDIO), U3.48 (VDDIO), U3.64 (VDDIO), U4.8 (VCC), X1.1 (Tri-State), X1.4 (VDD); also elsewhere on the board
+12V: C8.1, D1.2 (A), J2.1, R14.1, TP1.1, U2.1 (Vin)
/ADDR_1: JP1.2 (C), U4.2 (A1)
/ADDR_2: JP2.2 (C), U4.3 (A2)
/AIN_12V: R14.2, R15.1, TP23.1, U3.11 (PA05)
/BT_1: U3.45 (PA21); also elsewhere on the board
/BT_2: U3.46 (PA22); also elsewhere on the board
/BT_3: U3.47 (PA23); also elsewhere on the board
/BT_4: U3.59 (PA24); also elsewhere on the board
/BT_5: U3.60 (PA25); also elsewhere on the board
/EEPROM_WP: R13.1, TP27.1, U4.7 (WP)
/GLCK2: TP6.1, U3.15 (PA30)
/LCD_GDR: Q1.1 (G), R5.1, R6.1, TP5.1
/LCD_LED+: Q1.2 (S), TP31.1, U1.1 (LED+)
/LED1-: D3.1 (K), R20.1
/LED2-: D4.1 (K), R19.1
/LED3-: D5.1 (K), R18.1
/LED_3.3V: D2.1 (K), R2.1
/LED_12V: D1.1 (K), R1.1
/SCL: J2.3, R4.2, TP26.1, U3.28 (PA09), U4.6 (SCL)
/SDA: J2.2, R3.2, TP25.1, U3.29 (PA10), U4.5 (SDA)
D0: TP15.1, U1.19 (DB0), U3.6 (PB00)
D1: TP16.1, U1.18 (DB1), U3.7 (PB01)
D2: TP17.1, U1.17 (DB2), U3.24 (PB02)
D3: TP18.1, U1.16 (DB3), U3.25 (PB03)
D4: TP19.1, U1.15 (DB4), U3.26 (PB04)
D5: TP20.1, U1.14 (DB5), U3.27 (PB05)
D6: TP21.1, U1.13 (DB6), U3.38 (PB06)
D7: TP22.1, U1.12 (DB7), U3.43 (PB07)
GND: C1.2, C2.2, C3.2, C4.2, C5.2, C6.2, C7.2, C8.2, C9.2, C10.2, C11.2, C12.2, C13.2, C14.2, C15.2, J1.2, J1.10, J2.4, JP1.3 (B), JP2.3 (B), R1.2, R2.2, R6.2, R13.2, R15.2, R18.2, R19.2, R20.2, TP2.1, U1.2 (LED-), U1.3 (GND), U1.20 (GND), U2.2 (GND), U3.1 (GND), U3.17 (GNDANA), U3.23 (GND), U3.49 (GND), U4.4 (GND), X1.2 (GND); also elsewhere on the board
LCD_CS: TP10.1, U1.7 (CS), U3.31 (PA12)
LCD_PWM: R5.2, TP4.1, U3.30 (PA11)
LCD_RD: TP14.1, U1.11 (RD), U3.33 (PA13)
LCD_RESET: TP11.1, U1.8 (RESET), U3.36 (PA16)
LCD_RS: TP12.1, U1.9 (RS), U3.34 (PA14)
LCD_WR: TP13.1, U1.10 (WR), U3.35 (PA15)
LED+_1: D3.2 (A), U3.55 (PB09)
LED+_2: D4.2 (A), U3.57 (PB10)
LED+_3: D5.2 (A), U3.58 (PB11)
RESET_N: J1.6, TP28.1, U3.63 (RESET_N)
TCK: J1.1, U3.2 (PB12-TCK)
TDI: J1.9, U3.3 (PA00-TDI)
TDO: J1.3, U3.4 (PA01-TDO)
TMS: J1.5, U3.5 (PA02-TMS)
XIN: C14.1, U3.39 (PA18-XIN), X1.3 (OUT)

Notes on the sheet:
LCD Screen
EEPROM
Voltage Regulator
LCD Test Points
Debug/Test LEDs
Buttons on second page
IIC Bus

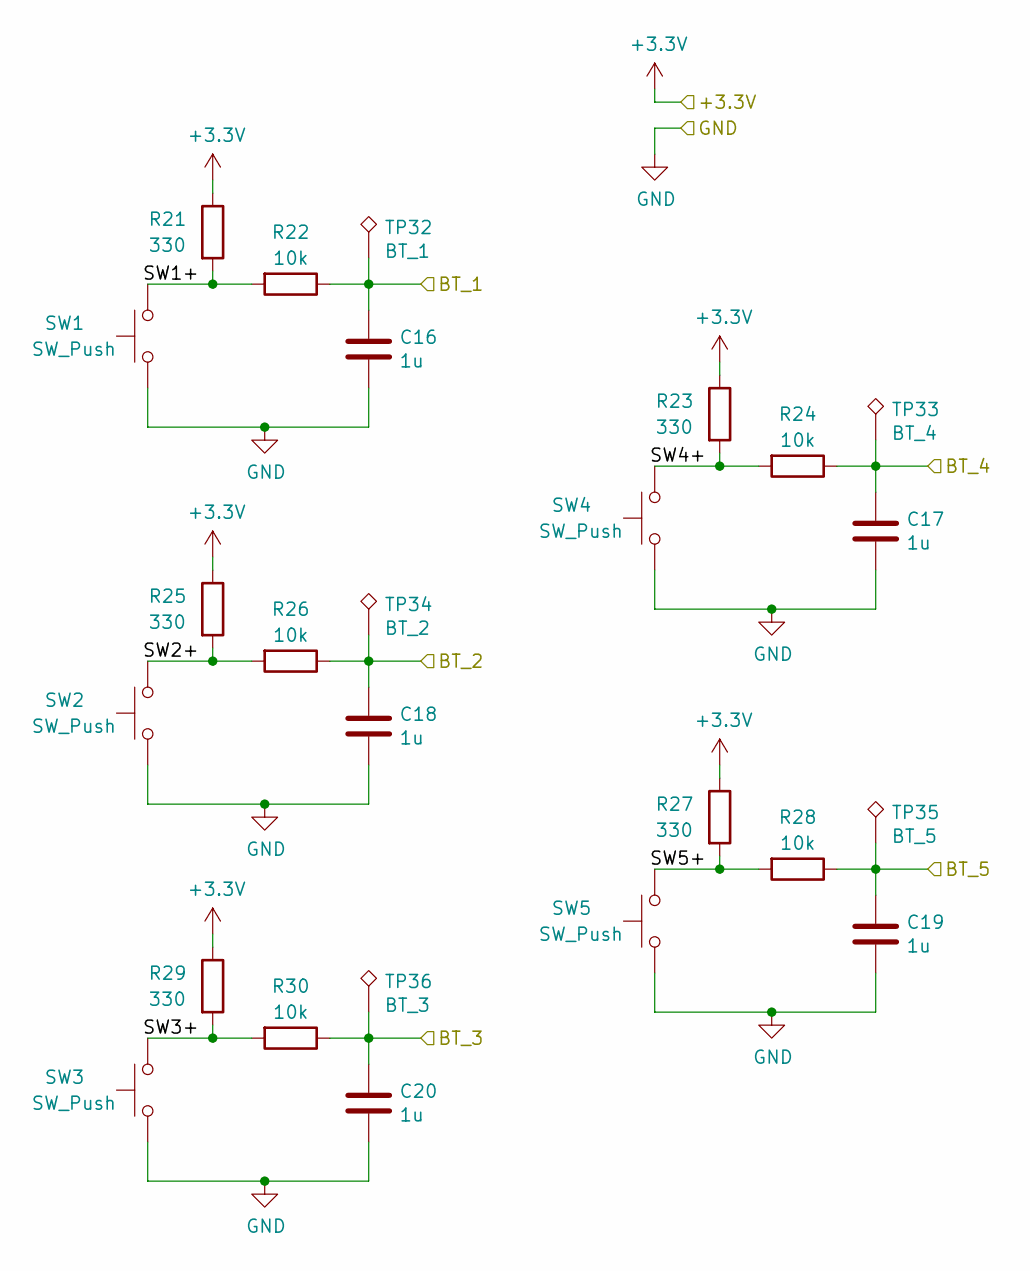
[picture p121: schematic Controller_Board_Buttons.sch, Damping Adjuster Controller Board]

Parts:
C16, C17, C18, C19, C20: 1u; C_0805_2012Metric
R21, R23, R25, R27, R29: 330; R_0805_2012Metric
R22, R24, R26, R28, R30: 10k; R_0805_2012Metric
SW1, SW2, SW3, SW4, SW5: SW_Push; SW_Push_1P1T_NO_6x6mm_H9.5mm
TP32: BT_1; TestPoint_Pad_1.5x1.5mm
TP33: BT_4; TestPoint_Pad_1.5x1.5mm
TP34: BT_2; TestPoint_Pad_1.5x1.5mm
TP35: BT_5; TestPoint_Pad_1.5x1.5mm
TP36: BT_3; TestPoint_Pad_1.5x1.5mm

Connections:
+3V3: R21.1, R23.1, R25.1, R27.1, R29.1; also elsewhere on the board
/BT_1: C16.1, R22.1, TP32.1; also elsewhere on the board
/BT_2: C18.1, R26.1, TP34.1; also elsewhere on the board
/BT_3: C20.1, R30.1, TP36.1; also elsewhere on the board
/BT_4: C17.1, R24.1, TP33.1; also elsewhere on the board
/BT_5: C19.1, R28.1, TP35.1; also elsewhere on the board
/Controller Board Buttons/SW1+: R21.2, R22.2, SW1.2
/Controller Board Buttons/SW2+: R25.2, R26.2, SW2.2
/Controller Board Buttons/SW3+: R29.2, R30.2, SW3.2
/Controller Board Buttons/SW4+: R23.2, R24.2, SW4.2
/Controller Board Buttons/SW5+: R27.2, R28.2, SW5.2
GND: C16.2, C17.2, C18.2, C19.2, C20.2, SW1.1, SW2.1, SW3.1, SW4.1, SW5.1; also elsewhere on the board

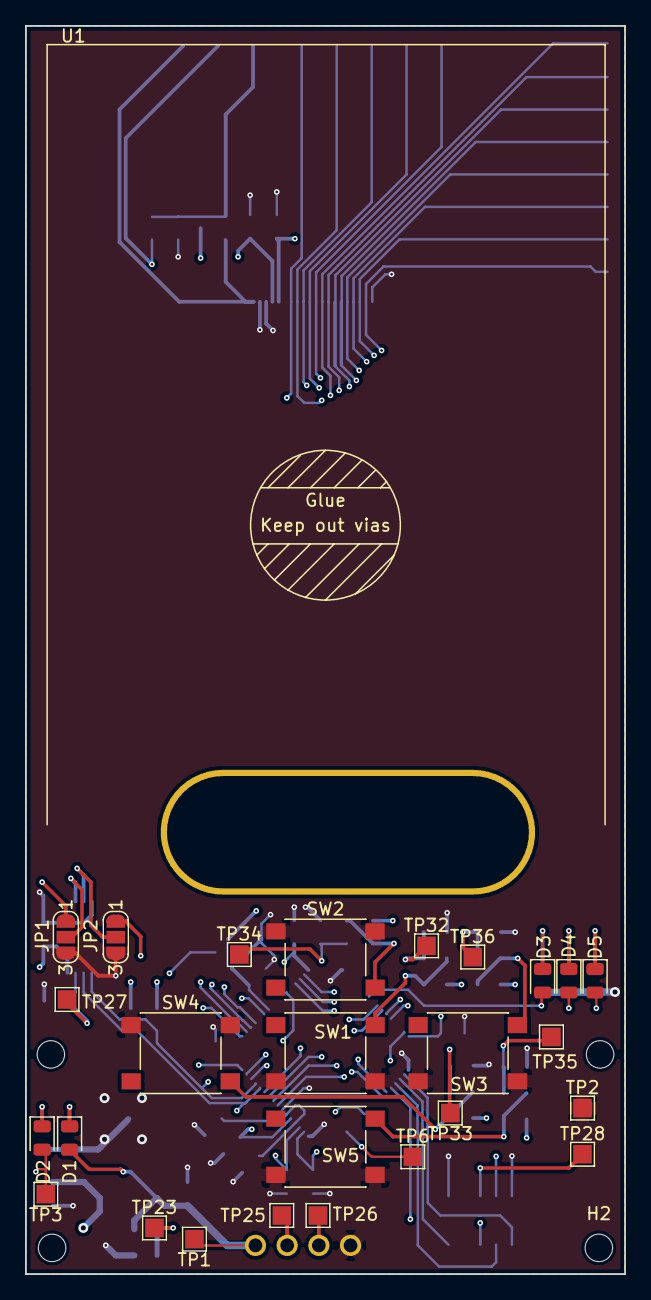
[picture p122: board Controller/Electrical/Controller_Board_AB/Controller_Borad.kicad_pcb from above]

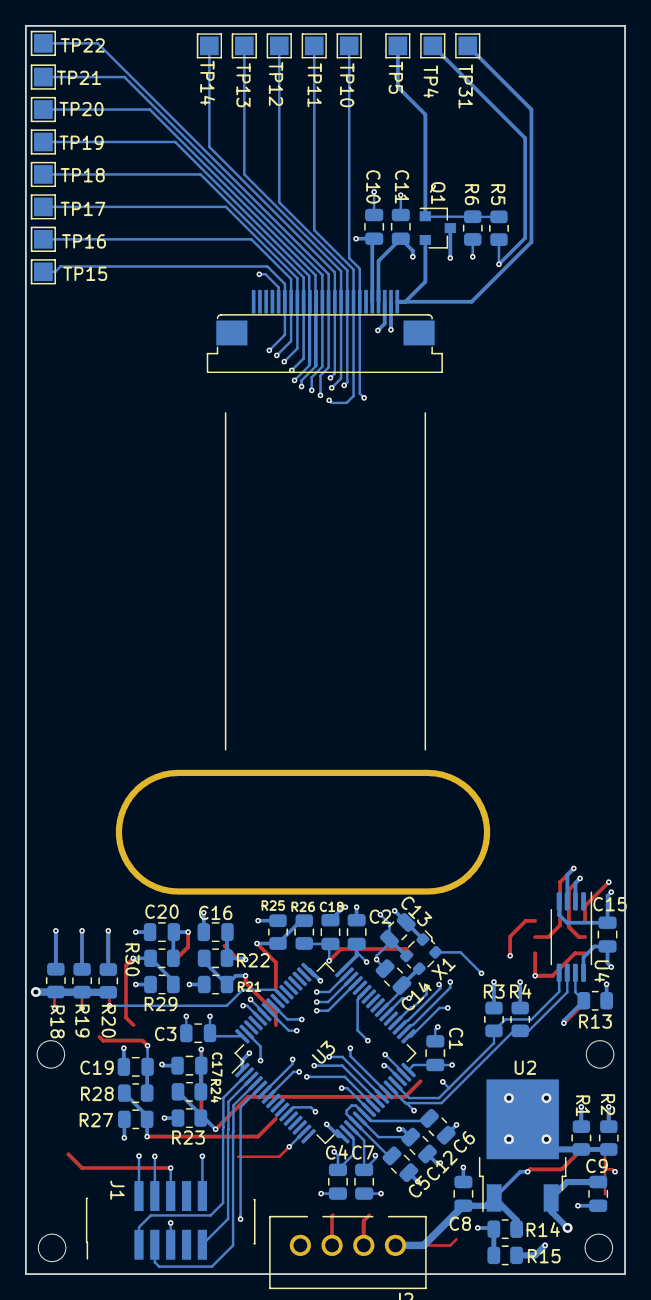
[picture p123: board Controller/Electrical/Controller_Board_AB/Controller_Borad.kicad_pcb from below]

Board: 4 copper layers, 48.0 x 100.0 mm, 96 parts (65 on the bottom side), 51 nets.
