alexjegers/DAMPING_ADJUSTER/Controller/Electrical/Controller_Board_AA/Controller_Borad.kicad_pcb

## KiCad design Controller/Electrical/Controller_Board_AA/Controller_Borad.kicad_pcb (2022-10-05)

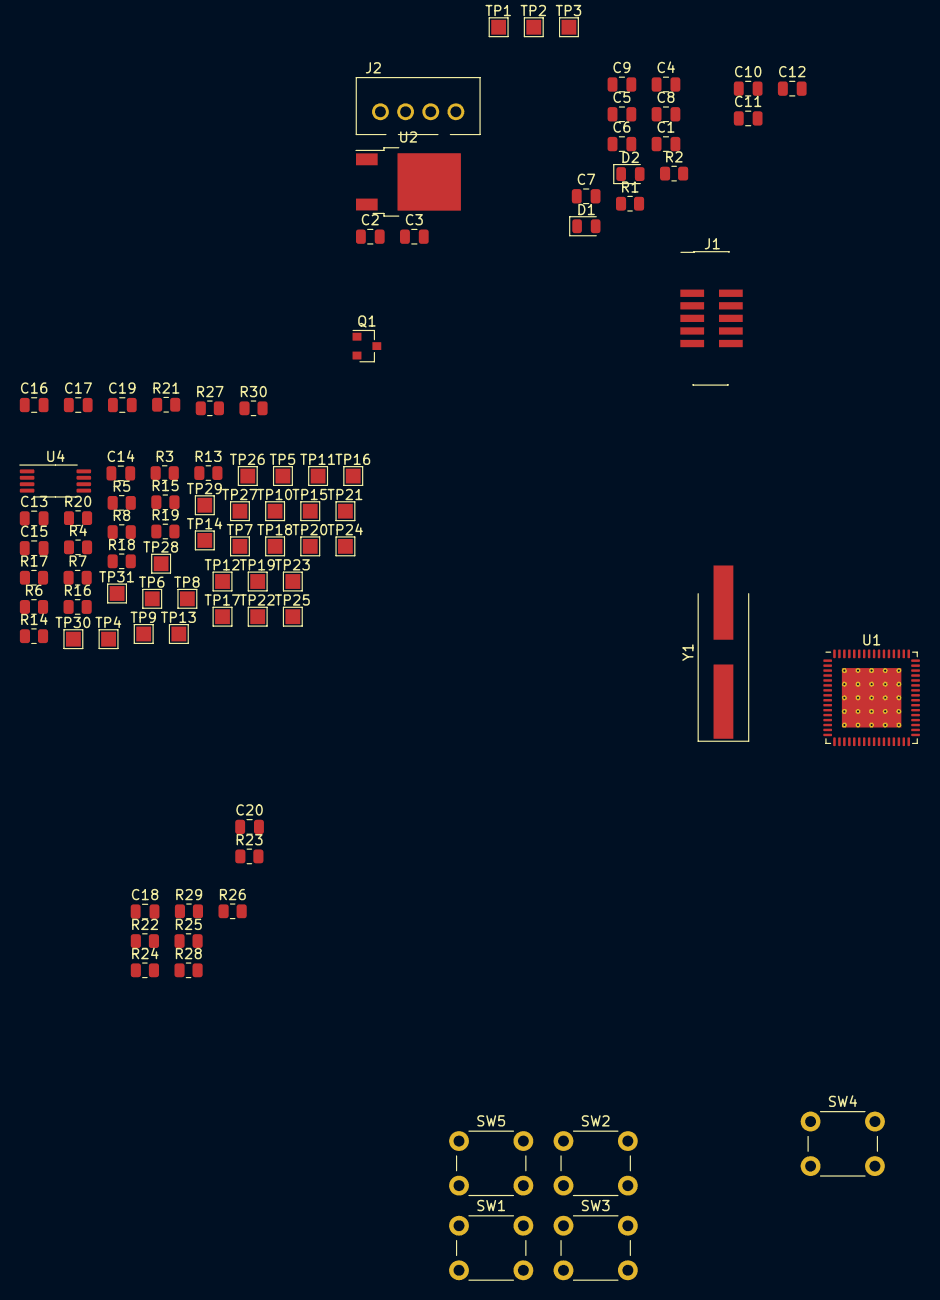
[picture p124: board Controller/Electrical/Controller_Board_AA/Controller_Borad.kicad_pcb from above]

Board: 2 copper layers, 91 parts (0 on the bottom side), 50 nets, no tracks yet.

Parts:
C1, C3, C4, C5, C7, C9, C10, C12, C15: .1u; C_0805_2012Metric
C2, C6, C16, C17, C18, C19, C20: 1u; C_0805_2012Metric
C8: .33u; C_0805_2012Metric
C11: 10u; C_0805_2012Metric
C13, C14: 14p; C_0805_2012Metric
D1, D2: LED; LED_0805_2012Metric
J1: JTAG Connector; PinHeader_2x05_P1.27mm_Vertical_SMD
J2: Comm Connector; 1005-003
Q1: BSR802N; SOT-23
R1: 1.5k; R_0805_2012Metric
R2, R18, R19, R20: 470; R_0805_2012Metric
R3, R4: 1k; R_0805_2012Metric
R5, R15: 200; R_0805_2012Metric
R6: 47k; R_0805_2012Metric
R7, R8, R14: 1.2k; R_0805_2012Metric
R13, R22, R24, R26, R28, R30: 10k; R_0805_2012Metric
R16, R17: 680; R_0805_2012Metric
R21, R23, R25, R27, R29: 330; R_0805_2012Metric
SW1, SW2, SW3, SW4, SW5: SW_Push; SW_PUSH_6mm_H5mm
TP1: 12V; TestPoint_Pad_1.5x1.5mm
TP2: GND; TestPoint_Pad_1.5x1.5mm
TP3: 3.3V; TestPoint_Pad_1.5x1.5mm
TP4: LCD PWM; TestPoint_Pad_1.5x1.5mm
TP5: LCD PWM GDR; TestPoint_Pad_1.5x1.5mm
TP6: GCLK0; TestPoint_Pad_1.5x1.5mm
TP7: GCLK1; TestPoint_Pad_1.5x1.5mm
TP8: GCLK2; TestPoint_Pad_1.5x1.5mm
TP9: GCLK3; TestPoint_Pad_1.5x1.5mm
TP10: LCD_CS; TestPoint_Pad_1.5x1.5mm
TP11: LCD_RESET; TestPoint_Pad_1.5x1.5mm
TP12: LCD_RS; TestPoint_Pad_1.5x1.5mm
TP13: LCD_WR; TestPoint_Pad_1.5x1.5mm
TP14: LCD_RD; TestPoint_Pad_1.5x1.5mm
TP15: D0; TestPoint_Pad_1.5x1.5mm
TP16: D1; TestPoint_Pad_1.5x1.5mm
TP17: D2; TestPoint_Pad_1.5x1.5mm
TP18: D3; TestPoint_Pad_1.5x1.5mm
TP19: D4; TestPoint_Pad_1.5x1.5mm
TP20: D5; TestPoint_Pad_1.5x1.5mm
TP21: D6; TestPoint_Pad_1.5x1.5mm
TP22: D7; TestPoint_Pad_1.5x1.5mm
TP23: AIN_12V; TestPoint_Pad_1.5x1.5mm
TP24: AIN_3.3V; TestPoint_Pad_1.5x1.5mm
TP25: SDA_3; TestPoint_Pad_1.5x1.5mm
TP26: SCL_3; TestPoint_Pad_1.5x1.5mm
TP27: EEPROM_WR; TestPoint_Pad_1.5x1.5mm
TP28: RESET_N; TestPoint_Pad_1.5x1.5mm
TP29: SDA_2; TestPoint_Pad_1.5x1.5mm
TP30: SCL_2; TestPoint_Pad_1.5x1.5mm
TP31: LCD_LED+; TestPoint_Pad_1.5x1.5mm
U1: ATSAM4LC2BA; QFN-64-1EP_9x9mm_P0.5mm_EP6x6mm_ThermalVias
U2: UA78M33CKVURG3; TO-252-2
U4: AT24C04D; TSSOP-8_4.4x3mm_P0.65mm
Y1: 30MHz; Crystal_SMD_HC49-SD_HandSoldering

Connections:
+1V8: C5.1, C6.1, U1.5, U1.7
+3V3: C1.1, C2.1, C3.1, C4.1, C7.1, C9.1, C10.1, C11.1, C12.1, C15.1, D2.2, J1.1, Q1.3, R3.1, R4.1, R7.1, R8.1, R16.1, R21.1, R23.1, R25.1, R27.1, R29.1, TP3.1, U1.8, U1.24, U1.25, U1.39, U1.52, U1.61, U2.3, U4.8
+12V: C8.1, D1.2, J2.1, R14.1, TP1.1, U2.1
/AIN_3.3V: R16.2, R17.1, TP24.1, U1.15
/AIN_12V: R14.2, R15.1, TP23.1, U1.16
/BT_1: C16.1, R22.1, U1.41
/BT_2: C18.1, R26.1, U1.42
/BT_3: C20.1, R30.1, U1.43
/BT_4: C17.1, R24.1, U1.44
/BT_5: C19.1, R28.1, U1.49
/Controller Board Buttons/SW1+: R21.2, R22.2, SW1.2
/Controller Board Buttons/SW2+: R25.2, R26.2, SW3.2
/Controller Board Buttons/SW3+: R29.2, R30.2, SW5.2
/Controller Board Buttons/SW4+: R23.2, R24.2, SW2.2
/Controller Board Buttons/SW5+: R27.2, R28.2, SW4.2
/EEPROM_WP: R13.1, TP27.1, U1.46, U4.7
/GCLK1: TP7.1, U1.48
/GCLK2: TP8.1, U1.53
/GCLK3: TP9.1, U1.54
/GLCK0: TP6.1, U1.47
/LCD_GDR: Q1.1, R5.1, R6.1, TP5.1
/LCD_LED+: Q1.2, TP31.1
/LED_3.3V: D2.1, R2.1
/LED_12V: D1.1, R1.1
/SCL_2: J2.3, R3.2, TP30.1, U1.56
/SCL_3: R8.2, TP26.1, U1.58, U4.6
/SDA_2: J2.2, R4.2, TP29.1, U1.55
/SDA_3: R7.2, TP25.1, U1.57, U4.5
/XIN: C13.1, U1.1, Y1.1
/XOUT: C14.1, U1.2, Y1.2
D0: TP15.1, U1.11
D1: TP16.1, U1.12
D2: TP17.1, U1.13
D3: TP18.1, U1.14
D4: TP19.1, U1.19
D5: TP20.1, U1.20
D6: TP21.1, U1.27
D7: TP22.1, U1.28
GND: C1.2, C2.2, C3.2, C4.2, C5.2, C6.2, C7.2, C8.2, C9.2, C10.2, C11.2, C12.2, C13.2, C14.2, C15.2, C16.2, C17.2, C18.2, C19.2, C20.2, J1.3, J1.5, J1.9, J2.4, R1.2, R2.2, R6.2, R13.2, R15.2, R17.2, R18.2, R19.2, R20.2, SW1.1, SW2.1, SW3.1, SW4.1, SW5.1, TP2.1, U1.6, U1.23, U1.38, U1.64, U1.65, U2.2, U4.4
LCD_CS: TP10.1, U1.29
LCD_PWM: R5.2, TP4.1, U1.26
LCD_RD: TP14.1, U1.30
LCD_RESET: TP11.1, U1.40
LCD_RS: TP12.1, U1.31
LCD_WR: TP13.1, U1.32
RESET_N: J1.10, TP28.1, U1.4
TCK: J1.4, U1.9
TDI: J1.8, U1.60
TDO: J1.6, U1.59
TMS: J1.2, U1.10
