alexjegers/DAMPING_ADJUSTER/Power & Signal Board/Electrical/Power_Board_001/Power_Board_001.kicad_pcb

## KiCad design Power & Signal Board/Electrical/Power_Board_001/Power_Board_001.kicad_pcb (2022-10-05)

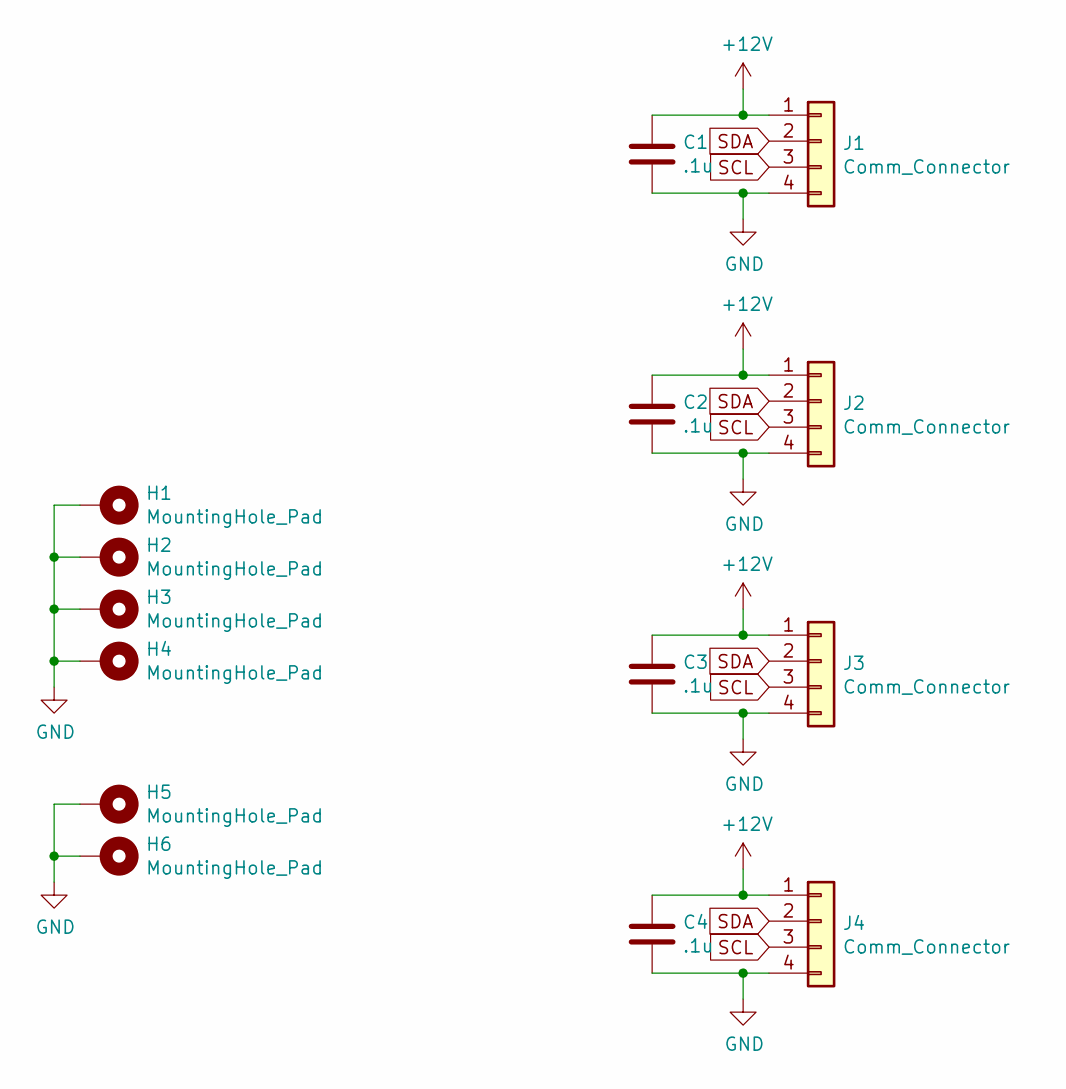
[picture p125: schematic Power_Board_001.sch]

Parts:
C1, C2, C3, C4: .1u; C_0805_2012Metric_Pad1.18x1.45mm_HandSolder
H1, H2, H3, H4: MountingHole_Pad; MountingHole_3.2mm_M3_DIN965_Pad
H5, H6: MountingHole_Pad; MountingHole_2.2mm_M2_DIN965_Pad
J1, J2, J3, J4: Comm_Connector; 1005-003

Connections:
+12V: C1.1, C2.1, C3.1, C4.1, J1.1, J2.1, J3.1, J4.1
GND: C1.2, C2.2, C3.2, C4.2, H1.1, H2.1, H3.1, H4.1, H5.1, H6.1, J1.4, J2.4, J3.4, J4.4
SCL: J1.3, J2.3, J3.3, J4.3
SDA: J1.2, J2.2, J3.2, J4.2

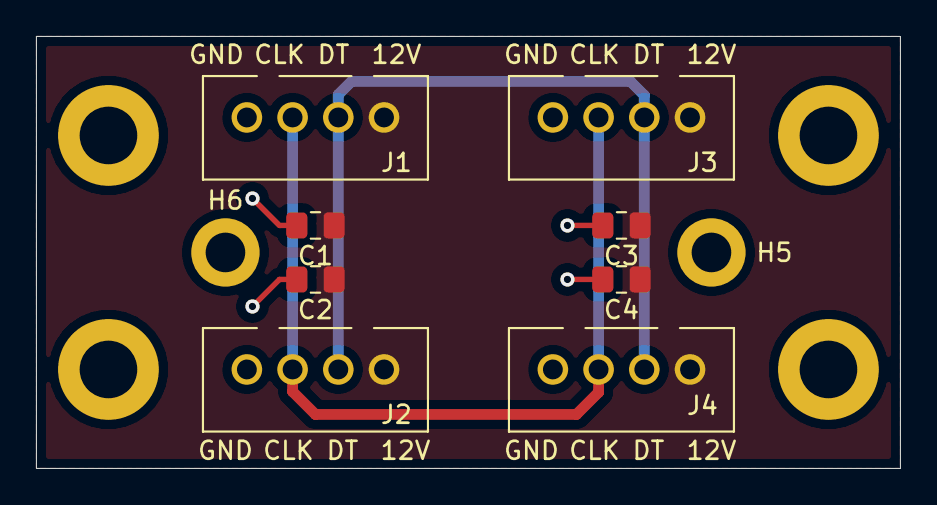
[picture p126: board Power_Board_001.kicad_pcb from above]

Board: 2 copper layers, 48.0 x 24.0 mm, 14 parts (0 on the bottom side), 4 nets.
