alexjegers/DAMPING_ADJUSTER/Stepper Motor Controller/Electrical/Stepper_Motor_Controller.kicad_pcb

## KiCad design Stepper Motor Controller/Electrical/Stepper_Motor_Controller.kicad_pcb (2022-10-05)

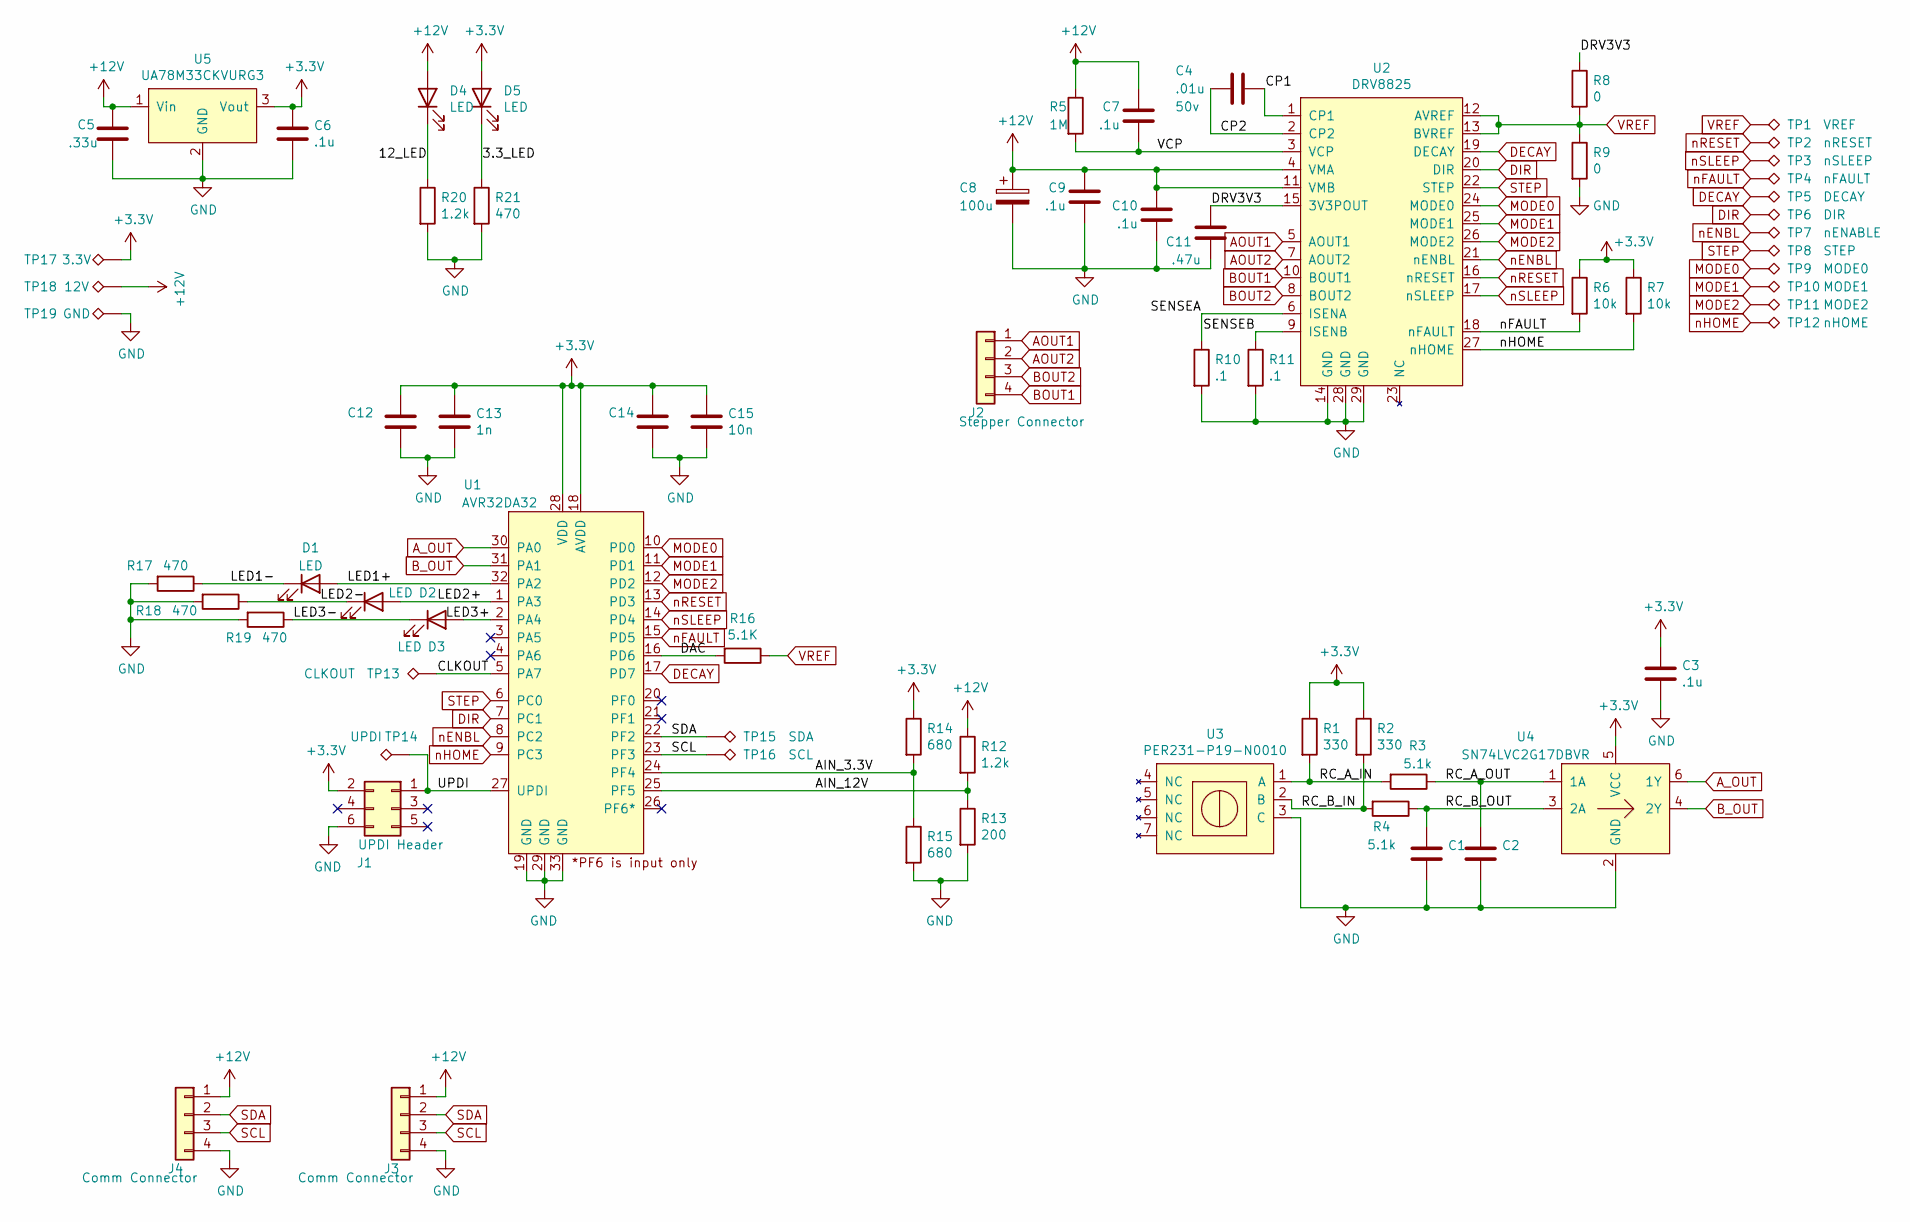
[picture p127: schematic Stepper_Motor_Controller.sch, Stepper Motor Controller Board]

Parts:
C1, C2, C12, C14: C_0805_2012Metric
C3, C6, C9, C10: .1u; C_0805_2012Metric
C4: .01u; C_0805_2012Metric; Voltage 50v
C5: .33u; C_0805_2012Metric
C7: .1u; C_0805_2012Metric; Voltage 16v
C8: 100u; CP_Axial_L10.0mm_D6.0mm_P15.00mm_Horizontal; MFG Part # MAL202136101E3
C11: .47u; C_0805_2012Metric; Voltage 6.3V
C13: 1n; C_0805_2012Metric
C15: 10n; C_0805_2012Metric
D1, D2, D3, D4, D5: LED; LED_1206_3216Metric
J1: UPDI Header; PinHeader_2x03_P2.54mm_Vertical
J2: Stepper Connector; 1005-003
J3, J4: Comm Connector; 1005-003
R1, R2: 330; R_0805_2012Metric
R3, R4: 5.1k; R_0805_2012Metric
R5: 1M; R_0805_2012Metric
R6, R7: 10k; R_0805_2012Metric
R8, R9: 0; R_0805_2012Metric
R10, R11: .1; R_1206_3216Metric; MFG Part # KDV12DR100ET
R12, R20: 1.2k; R_0805_2012Metric
R13: 200; R_0805_2012Metric
R14, R15: 680; R_0805_2012Metric
R16: 5.1K; R_0805_2012Metric
R17, R18, R19, R21: 470; R_0805_2012Metric
TP1: VREF; TestPoint_Pad_1.5x1.5mm
TP2: nRESET; TestPoint_Pad_1.5x1.5mm
TP3: nSLEEP; TestPoint_Pad_1.5x1.5mm
TP4: nFAULT; TestPoint_Pad_1.5x1.5mm
TP5: DECAY; TestPoint_Pad_1.5x1.5mm
TP6: DIR; TestPoint_Pad_1.5x1.5mm
TP7: nENABLE; TestPoint_Pad_1.5x1.5mm
TP8: STEP; TestPoint_Pad_1.5x1.5mm
TP9: MODE0; TestPoint_Pad_1.5x1.5mm
TP10: MODE1; TestPoint_Pad_1.5x1.5mm
TP11: MODE2; TestPoint_Pad_1.5x1.5mm
TP12: nHOME; TestPoint_Pad_1.5x1.5mm
TP13: CLKOUT; TestPoint_Pad_1.5x1.5mm
TP14: UPDI; TestPoint_Pad_1.5x1.5mm
TP15: SDA; TestPoint_Pad_1.5x1.5mm
TP16: SCL; TestPoint_Pad_1.5x1.5mm
TP17: 3.3V; TestPoint_Pad_1.5x1.5mm
TP18: 12V; TestPoint_Pad_1.5x1.5mm
TP19: GND; TestPoint_Pad_1.5x1.5mm
U1: AVR32DA32; QFN-32-1EP_5x5mm_P0.5mm_EP3.1x3.1mm
U2: DRV8825; HTSSOP-28-1EP_4.4x9.7mm_P0.65mm_EP2.85x5.4mm_ThermalVias
U3: PER231-P19-N0010
U4: SN74LVC2G17DBVR; SOT-23-6_Handsoldering
U5: UA78M33CKVURG3; TO-252-2

Connections:
+3V3: C3.1, C6.1, C12.1, C13.1, C14.1, C15.1, D5.2 (A), J1.2, R1.1, R2.1, R6.1, R7.1, R14.1, TP17.1, U1.18 (AVDD), U1.28 (VDD), U4.5 (VCC), U5.3 (Vout)
+12V: C5.1, C7.2, C8.1, C9.2, C10.2, D4.2 (A), J3.1, J4.1, R5.1, R12.1, TP18.1, U2.4 (VMA), U2.11 (VMB), U5.1 (Vin)
/3.3_LED: D5.1 (K), R21.1
/12_LED: D4.1 (K), R20.1
/AIN_3.3V: R14.2, R15.1, U1.24 (PF4)
/AIN_12V: R12.2, R13.1, U1.25 (PF5)
/CLKOUT: TP13.1, U1.5 (PA7)
/CP1: C4.2, U2.1 (CP1)
/CP2: C4.1, U2.2 (CP2)
/DAC: R16.2, U1.16 (PD6)
/DRV3V3: C11.2, R8.1, U2.15 (3V3POUT)
/LED1+: D1.2 (A), U1.32 (PA2)
/LED1-: D1.1 (K), R17.1
/LED2+: D2.2 (A), U1.1 (PA3)
/LED2-: D2.1 (K), R18.1
/LED3+: D3.2 (A), U1.2 (PA4)
/LED3-: D3.1 (K), R19.1
/RC_A_IN: R1.2, R3.2, U3.1 (A)
/RC_A_OUT: C2.1, R3.1, U4.1 (1A)
/RC_B_IN: R2.2, R4.2, U3.2 (B)
/RC_B_OUT: C1.1, R4.1, U4.3 (2A)
/SENSEA: R10.1, U2.6 (ISENA)
/SENSEB: R11.1, U2.9 (ISENB)
/UPDI: J1.1, TP14.1, U1.27 (UPDI)
/VCP: C7.1, R5.2, U2.3 (VCP)
AOUT1: J2.1, U2.5 (AOUT1)
AOUT2: J2.2, U2.7 (AOUT2)
A_OUT: U1.30 (PA0), U4.6 (1Y)
BOUT1: J2.4, U2.10 (BOUT1)
BOUT2: J2.3, U2.8 (BOUT2)
B_OUT: U1.31 (PA1), U4.4 (2Y)
DECAY: TP5.1, U1.17 (PD7), U2.19 (DECAY)
DIR: TP6.1, U1.7 (PC1), U2.20 (DIR)
GND: C1.2, C2.2, C3.2, C5.2, C6.2, C8.2, C9.1, C10.1, C11.1, C12.2, C13.2, C14.2, C15.2, J1.6, J3.4, J4.4, R9.2, R10.2, R11.2, R13.2, R15.2, R17.2, R18.2, R19.2, R20.2, R21.2, TP19.1, U1.19 (GND), U1.29 (GND), U1.33 (GND), U2.14 (GND), U2.28 (GND), U2.29 (GND), U3.3 (C), U4.2 (GND), U5.2 (GND)
MODE0: TP9.1, U1.10 (PD0), U2.24 (MODE0)
MODE1: TP10.1, U1.11 (PD1), U2.25 (MODE1)
MODE2: TP11.1, U1.12 (PD2), U2.26 (MODE2)
SCL: J3.3, J4.3, TP16.1, U1.23 (PF3)
SDA: J3.2, J4.2, TP15.1, U1.22 (PF2)
STEP: TP8.1, U1.6 (PC0), U2.22 (STEP)
VREF: R8.2, R9.1, R16.1, TP1.1, U2.12 (AVREF), U2.13 (BVREF)
nENBL: TP7.1, U1.8 (PC2), U2.21 (nENBL)
nFAULT: R6.2, TP4.1, U1.15 (PD5), U2.18 (nFAULT)
nHOME: R7.2, TP12.1, U1.9 (PC3), U2.27 (nHOME)
nRESET: TP2.1, U1.13 (PD3), U2.16 (nRESET)
nSLEEP: TP3.1, U1.14 (PD4), U2.17 (nSLEEP)

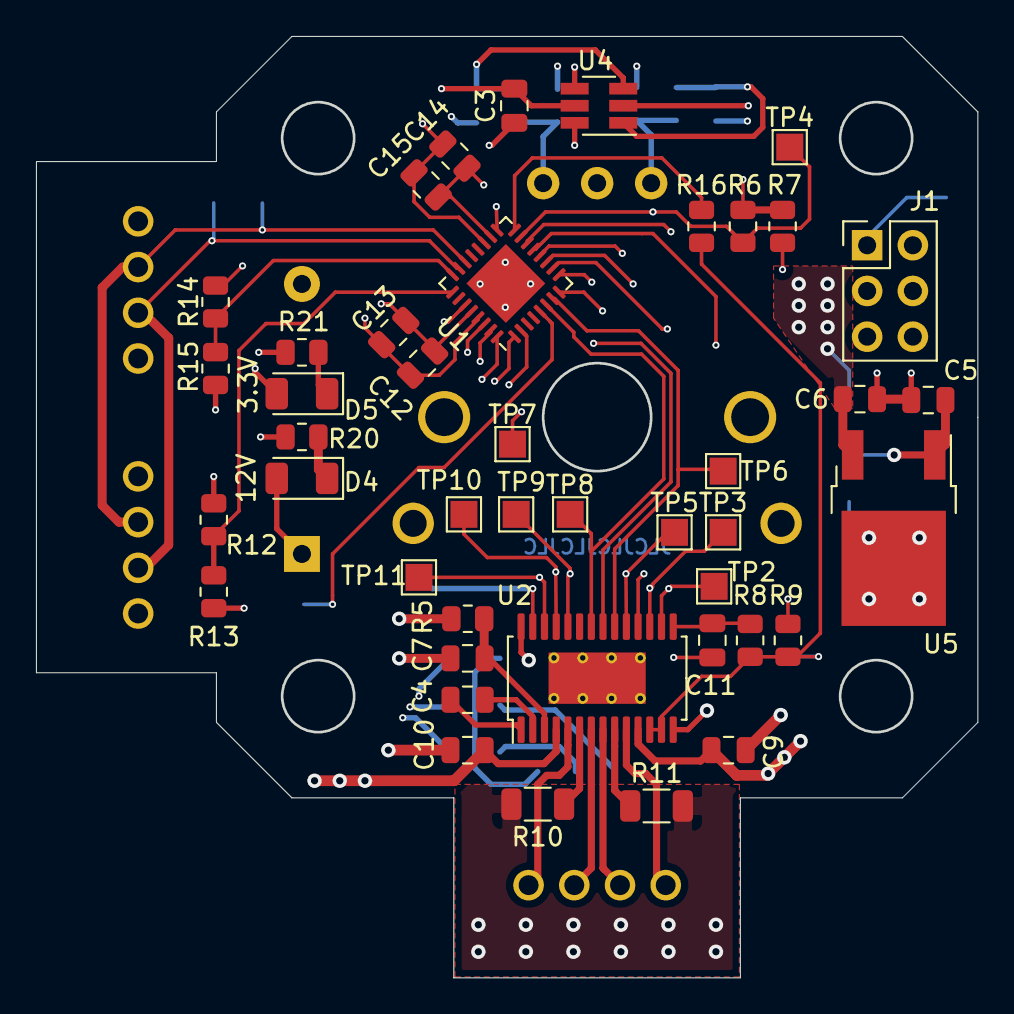
[picture p128: board Stepper_Motor_Controller.kicad_pcb from above]

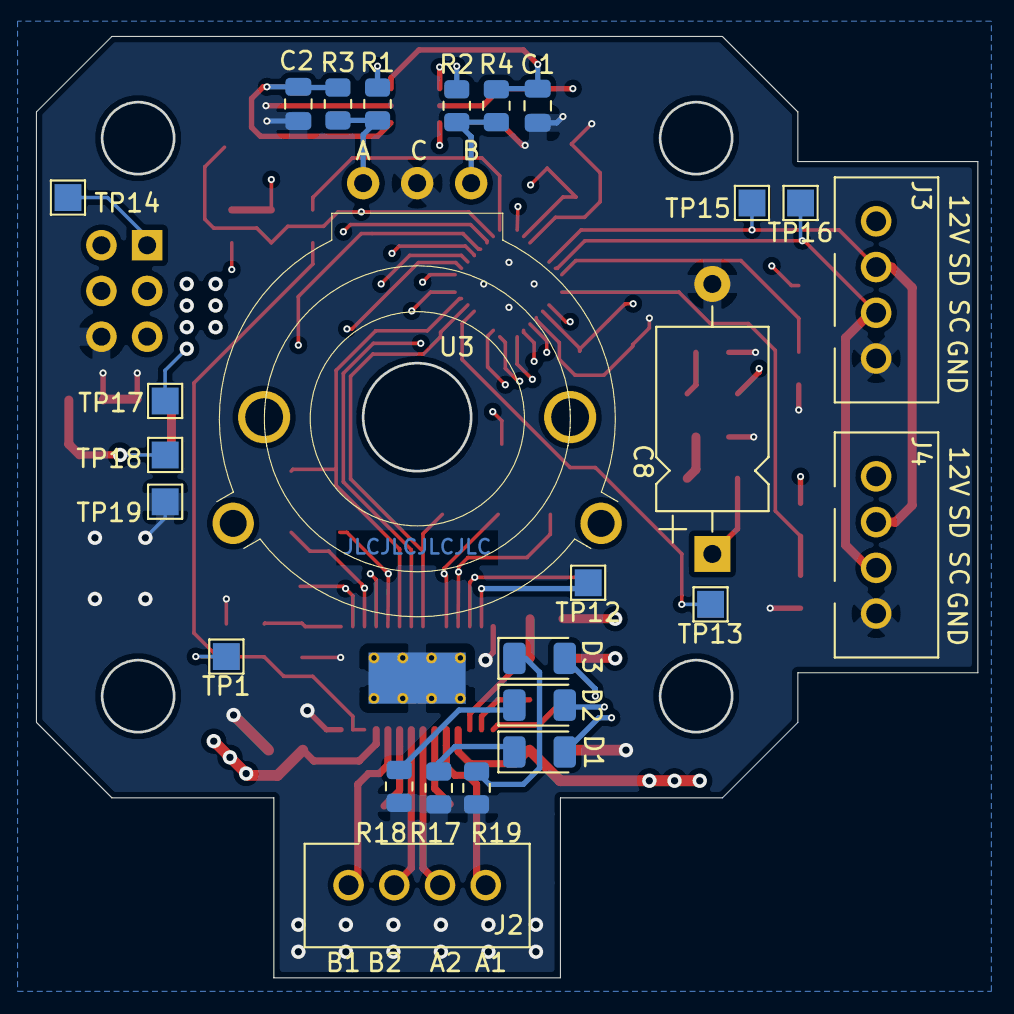
[picture p129: board Stepper_Motor_Controller.kicad_pcb from below]

Board: 4 copper layers, 52.3 x 52.3 mm, 69 parts (26 on the bottom side), 46 nets.
