alexjegers/DAMPING_ADJUSTER/Stepper Motor Controller/Firmware/DampingMotorController002/DampingMotorController002/inc/iic.h

/*
 * iic.h
 *
 * Created: 9/17/2022 11:54:48 AM
 *  Author: AJ992
 */ 


#ifndef IIC_H_
#define IIC_H_

/*This device address.*/
#define DEVICE_ADDR				(0x05 << 1)

#define IIC_REQUESTING_READ		TWI_DIR_bm
#define IIC_REQUESTING_WRITE	0

/*
IIC_DATA_struct holds all the data that could be sent or received over IIC.
They are addressed by the offset from the start of IIC_DATA_struct.
*/
typedef struct IIC_DATA_t  
{
	union
	{
		int16_t val;
		struct  
		{
			char msb;
			char lsb;
		}bytes;
	}position;						//0x00
	
	union
	{
		int16_t val;
		struct
		{
			int8_t msb;
			int8_t lsb;
		}bytes;
	}setPoint;						//0x02
	
	uint8_t stepMode;				//0x04
	uint16_t currentLimit;			//0x05
	uint8_t decayMode;				//0x07
	uint16_t speedInRPM;			//0x08
	uint8_t flags;					//0x0A
	uint8_t voltage;				//0x0B
}IIC_DATA_struct;

void iicInit();													//Puts TWI hardware in slave mode and enables interrupts.
void iicKill();													//Disables slave mode.
void iicEnableInterrupts();										//Enable the IIC interrupts.
void iicDisableInterrupts();									//Disables the IIC interrupts.

/*TWI int flags*/
int8_t iicAddrOrStopFlag();										//Returns true if the address match interrupt flag is set.
int8_t iicReadOrWriteFlag();									//Returns non-zero if master is requesting read, 0 if master is writing.
int8_t iicDataIntFlag();										//Returns non-zero if flag is set, returns zero if not set.
void iicWaitForDataIntFlag();									//Sits in a while loop until the data interrupt flag is sent.


void iicSendResponse(TWI_SCMD_t response, TWI_ACKACT_t ack);	//Choose to respond or complete transmission with an ACK or NACK.
char iicReadSdata();											//Returns the data in the SDATA register.
void iicWriteSdata(uint8_t data);								//Writes to SDATA register.

void iicLoadFromStepper();										//Populates the IIC_DATA_struct with new data (before sending data).
void iicLoadToStepper();										//Handles data from IIC_DATA_struct into the program (after receiving data.)

#endif /* IIC_H_ */
