alexjegers/DAMPING_ADJUSTER/(commit log)

2022-10-05 File Organization
    [BOM & Dev Costs.xlsx, Full Parts List.xlsx, Pinout Check Template.xlsx]
2022-10-05 File Orginization
    [1020.SLDPRT, 1024-001.SLDPRT, 1024-001.STEP, 1025-001.SLDPRT, 1025.STEP, 1026-001.SLDPRT, 1027-001.SLDPRT, 1027-001.STEP]
2022-10-06 Added power and distribution board enclosure part
    [1031-001.SLDPRT, 1032-001.SLDPRT, Full Parts List.xlsx]
2022-10-06 New revisions
    [1013-002.SLDPRT, 1019-002.SLDPRT, A1001-003.SLDASM, Full Parts List.xlsx]
2022-10-07 Decreased thread revolutions
    [1013-002.SLDPRT]
2022-10-07 stepperGoToZero function improvements
2022-10-11 Shorted hex key
    [1013-002.SLDPRT, 1019-002.SLDPRT, A1001-003.SLDASM]
2022-10-11 New versions
    [1010-004.SLDPRT, 1011-004.SLDPRT, 1011-004.STL]
2022-10-11 Updated for encoder signal processing testing
2022-10-11 Created mold for carbon fiber.
    [1028-001 Mold 2.SLDPRT, 1028-001 Mold.SLDPRT]
2022-10-11 Widened area for LCD
    [1029-001.SLDPRT]
2022-10-11 Initial release
    [Controller_Borad.kicad_pcb]
2022-10-19 Enlarged hole for connectors on back.
    [1020-001.SLDPRT, 1020.SLDPRT, 1024-001.SLDPRT, 1025-001.SLDPRT, 1026-001.SLDPRT, 1027-001.SLDPRT, 1028-001.SLDPRT, 1028-002.SLDPRT]
2022-10-19 No change
    [Controller_Borad.kicad_pcb]
2022-11-04 Added button and label classes
2022-11-11 Stupid bug that was just a bad solder joint
    D7 bit of data bus had a bad solder joint.
2022-11-11 Final edits and printed enclosure for power board
    [1031-001.SLDPRT, 1032-001.SLDPRT, A1007-001.SLDASM, Power_Board_001.SLDASM, Power_Board_001.step]
2022-11-11 Added setPosition function for stepper motor
2022-11-14 New schematic and PCB version AC
    [Controller_Board_Buttons.sch, Controller_Board_JLC_BOM.xlsx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]
2022-11-14 Added annotations
    [Stepper_Motor_Controller.sch]
2022-11-15 Create AVR32 Interrupts Guide.pdf
2022-11-15 Fix errors in schematic from Ver. AB
    [Controller_Borad.sch]
2022-11-15 Added schematic JPGs
2022-12-20 Added rounded buttons. Label strings fixed length .
    [forms.cpp, forms.h]
2022-12-20 Fixed bug when calculating max offset
    [iic.c, main.c]
2022-12-20 Added DXF and new config for CNC machining
    [1028-002.DXF, 1028-002.SLDDRW, 1028-002.SLDPRT]
